SmoothieAq/cevo2/readme.md

# Cevo2
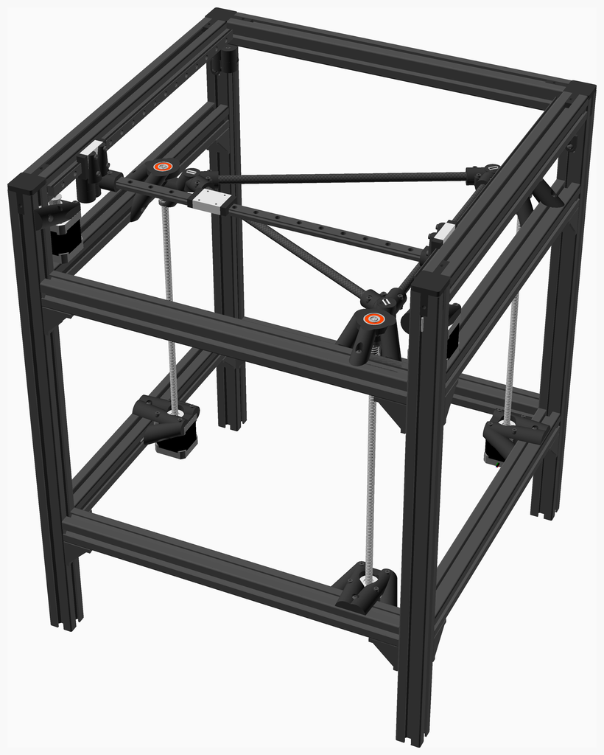
[picture p1: assemblies/frame22_assembled.png]
Main Assembly


<span></span>

---
## Table of Contents
1. [Parts list](#Parts_list)
1. [Loops Motor Holder Assembly](#loops_motor_holder_assembly)
1. [Idler Assembly](#idler_assembly)
1. [Bed1 Assembly](#bed1_assembly)
1. [Leads1 Assembly](#leads1_assembly)
1. [Leads2 Assembly](#leads2_assembly)
1. [Frame SideR Assembly](#frame_sideR_assembly)
1. [Frame SideL Assembly](#frame_sideL_assembly)
1. [Frame Assembly](#frame_assembly)
1. [Frame1 Assembly](#frame1_assembly)
1. [Frame2 Assembly](#frame2_assembly)
1. [Frame3 Assembly](#frame3_assembly)
1. [Frame10 Assembly](#frame10_assembly)
1. [Frame11 Assembly](#frame11_assembly)
1. [Frame20 Assembly](#frame20_assembly)
1. [Frame21 Assembly](#frame21_assembly)
1. [Frame22 Assembly](#frame22_assembly)

<span></span>
[Top](#TOP)

---

## Parts list
| <span style="writing-mode: vertical-rl; text-orientation: mixed;">Loops&nbsp;Motor&nbsp;Holder</span> | <span style="writing-mode: vertical-rl; text-orientation: mixed;">Idler</span> | <span style="writing-mode: vertical-rl; text-orientation: mixed;">Bed1</span> | <span style="writing-mode: vertical-rl; text-orientation: mixed;">Leads1</span> | <span style="writing-mode: vertical-rl; text-orientation: mixed;">Leads2</span> | <span style="writing-mode: vertical-rl; text-orientation: mixed;">Frame&nbsp;SideR</span> | <span style="writing-mode: vertical-rl; text-orientation: mixed;">Frame&nbsp;SideL</span> | <span style="writing-mode: vertical-rl; text-orientation: mixed;">Frame</span> | <span style="writing-mode: vertical-rl; text-orientation: mixed;">Frame1</span> | <span style="writing-mode: vertical-rl; text-orientation: mixed;">Frame2</span> | <span style="writing-mode: vertical-rl; text-orientation: mixed;">Frame3</span> | <span style="writing-mode: vertical-rl; text-orientation: mixed;">Frame10</span> | <span style="writing-mode: vertical-rl; text-orientation: mixed;">Frame11</span> | <span style="writing-mode: vertical-rl; text-orientation: mixed;">Frame20</span> | <span style="writing-mode: vertical-rl; text-orientation: mixed;">Frame21</span> | <span style="writing-mode: vertical-rl; text-orientation: mixed;">Frame22</span> | <span style="writing-mode: vertical-rl; text-orientation: mixed;">TOTALS</span> |  |
|---:|---:|---:|---:|---:|---:|---:|---:|---:|---:|---:|---:|---:|---:|---:|---:|---:|:---|
|  |  |  |  |  |  |  |  |  |  |  |  |  |  |  |  | | **Vitamins** |
| &nbsp;&nbsp;.&nbsp; | &nbsp;&nbsp;.&nbsp; | &nbsp;&nbsp;.&nbsp; | &nbsp;&nbsp;.&nbsp; | &nbsp;&nbsp;.&nbsp; | &nbsp;&nbsp;.&nbsp; | &nbsp;&nbsp;.&nbsp; | &nbsp;&nbsp;.&nbsp; | &nbsp;&nbsp;.&nbsp; | &nbsp;&nbsp;3&nbsp; | &nbsp;&nbsp;.&nbsp; | &nbsp;&nbsp;.&nbsp; | &nbsp;&nbsp;.&nbsp; | &nbsp;&nbsp;.&nbsp; | &nbsp;&nbsp;.&nbsp; | &nbsp;&nbsp;.&nbsp; |  &nbsp;&nbsp;3&nbsp; | &nbsp;&nbsp; Ball bearing 608-2RS 8mm x 22mm x 7mm |
| &nbsp;&nbsp;.&nbsp; | &nbsp;&nbsp;.&nbsp; | &nbsp;&nbsp;.&nbsp; | &nbsp;&nbsp;.&nbsp; | &nbsp;&nbsp;.&nbsp; | &nbsp;&nbsp;.&nbsp; | &nbsp;&nbsp;.&nbsp; | &nbsp;&nbsp;.&nbsp; | &nbsp;&nbsp;.&nbsp; | &nbsp;&nbsp;.&nbsp; | &nbsp;&nbsp;1&nbsp; | &nbsp;&nbsp;.&nbsp; | &nbsp;&nbsp;.&nbsp; | &nbsp;&nbsp;.&nbsp; | &nbsp;&nbsp;.&nbsp; | &nbsp;&nbsp;.&nbsp; |  &nbsp;&nbsp;1&nbsp; | &nbsp;&nbsp; Carbon fiber OD 10mm ID 8mm x 283mm |
| &nbsp;&nbsp;.&nbsp; | &nbsp;&nbsp;.&nbsp; | &nbsp;&nbsp;.&nbsp; | &nbsp;&nbsp;.&nbsp; | &nbsp;&nbsp;.&nbsp; | &nbsp;&nbsp;.&nbsp; | &nbsp;&nbsp;.&nbsp; | &nbsp;&nbsp;.&nbsp; | &nbsp;&nbsp;.&nbsp; | &nbsp;&nbsp;.&nbsp; | &nbsp;&nbsp;2&nbsp; | &nbsp;&nbsp;.&nbsp; | &nbsp;&nbsp;.&nbsp; | &nbsp;&nbsp;.&nbsp; | &nbsp;&nbsp;.&nbsp; | &nbsp;&nbsp;.&nbsp; |  &nbsp;&nbsp;2&nbsp; | &nbsp;&nbsp; Carbon fiber OD 10mm ID 8mm x 318.882mm |
| &nbsp;&nbsp;.&nbsp; | &nbsp;&nbsp;.&nbsp; | &nbsp;&nbsp;.&nbsp; | &nbsp;&nbsp;.&nbsp; | &nbsp;&nbsp;.&nbsp; | &nbsp;&nbsp;3&nbsp; | &nbsp;&nbsp;3&nbsp; | &nbsp;&nbsp;.&nbsp; | &nbsp;&nbsp;.&nbsp; | &nbsp;&nbsp;.&nbsp; | &nbsp;&nbsp;.&nbsp; | &nbsp;&nbsp;.&nbsp; | &nbsp;&nbsp;.&nbsp; | &nbsp;&nbsp;.&nbsp; | &nbsp;&nbsp;.&nbsp; | &nbsp;&nbsp;.&nbsp; |  &nbsp;&nbsp;6&nbsp; | &nbsp;&nbsp; Extrusion E3030 x 410mm |
| &nbsp;&nbsp;.&nbsp; | &nbsp;&nbsp;.&nbsp; | &nbsp;&nbsp;.&nbsp; | &nbsp;&nbsp;.&nbsp; | &nbsp;&nbsp;.&nbsp; | &nbsp;&nbsp;.&nbsp; | &nbsp;&nbsp;.&nbsp; | &nbsp;&nbsp;4&nbsp; | &nbsp;&nbsp;.&nbsp; | &nbsp;&nbsp;.&nbsp; | &nbsp;&nbsp;.&nbsp; | &nbsp;&nbsp;.&nbsp; | &nbsp;&nbsp;.&nbsp; | &nbsp;&nbsp;.&nbsp; | &nbsp;&nbsp;.&nbsp; | &nbsp;&nbsp;.&nbsp; |  &nbsp;&nbsp;4&nbsp; | &nbsp;&nbsp; Extrusion E3030 x 420mm |
| &nbsp;&nbsp;.&nbsp; | &nbsp;&nbsp;.&nbsp; | &nbsp;&nbsp;.&nbsp; | &nbsp;&nbsp;.&nbsp; | &nbsp;&nbsp;.&nbsp; | &nbsp;&nbsp;2&nbsp; | &nbsp;&nbsp;2&nbsp; | &nbsp;&nbsp;.&nbsp; | &nbsp;&nbsp;.&nbsp; | &nbsp;&nbsp;.&nbsp; | &nbsp;&nbsp;.&nbsp; | &nbsp;&nbsp;.&nbsp; | &nbsp;&nbsp;.&nbsp; | &nbsp;&nbsp;.&nbsp; | &nbsp;&nbsp;.&nbsp; | &nbsp;&nbsp;.&nbsp; |  &nbsp;&nbsp;4&nbsp; | &nbsp;&nbsp; Extrusion E3030 x 600mm |
| &nbsp;&nbsp;.&nbsp; | &nbsp;&nbsp;.&nbsp; | &nbsp;&nbsp;.&nbsp; | &nbsp;&nbsp;.&nbsp; | &nbsp;&nbsp;.&nbsp; | &nbsp;&nbsp;4&nbsp; | &nbsp;&nbsp;4&nbsp; | &nbsp;&nbsp;6&nbsp; | &nbsp;&nbsp;.&nbsp; | &nbsp;&nbsp;.&nbsp; | &nbsp;&nbsp;.&nbsp; | &nbsp;&nbsp;.&nbsp; | &nbsp;&nbsp;.&nbsp; | &nbsp;&nbsp;.&nbsp; | &nbsp;&nbsp;.&nbsp; | &nbsp;&nbsp;.&nbsp; |  &nbsp;&nbsp;14&nbsp; | &nbsp;&nbsp; Extrusion corner bracket 30 |
| &nbsp;&nbsp;.&nbsp; | &nbsp;&nbsp;.&nbsp; | &nbsp;&nbsp;.&nbsp; | &nbsp;&nbsp;.&nbsp; | &nbsp;&nbsp;.&nbsp; | &nbsp;&nbsp;2&nbsp; | &nbsp;&nbsp;2&nbsp; | &nbsp;&nbsp;.&nbsp; | &nbsp;&nbsp;.&nbsp; | &nbsp;&nbsp;.&nbsp; | &nbsp;&nbsp;.&nbsp; | &nbsp;&nbsp;.&nbsp; | &nbsp;&nbsp;.&nbsp; | &nbsp;&nbsp;.&nbsp; | &nbsp;&nbsp;.&nbsp; | &nbsp;&nbsp;.&nbsp; |  &nbsp;&nbsp;4&nbsp; | &nbsp;&nbsp; Extrusion inner corner bracket E30 M5 |
| &nbsp;&nbsp;.&nbsp; | &nbsp;&nbsp;.&nbsp; | &nbsp;&nbsp;3&nbsp; | &nbsp;&nbsp;.&nbsp; | &nbsp;&nbsp;.&nbsp; | &nbsp;&nbsp;.&nbsp; | &nbsp;&nbsp;.&nbsp; | &nbsp;&nbsp;.&nbsp; | &nbsp;&nbsp;.&nbsp; | &nbsp;&nbsp;.&nbsp; | &nbsp;&nbsp;.&nbsp; | &nbsp;&nbsp;.&nbsp; | &nbsp;&nbsp;.&nbsp; | &nbsp;&nbsp;.&nbsp; | &nbsp;&nbsp;.&nbsp; | &nbsp;&nbsp;.&nbsp; |  &nbsp;&nbsp;3&nbsp; | &nbsp;&nbsp; Leadscrew nut 8 x 2 |
| &nbsp;&nbsp;.&nbsp; | &nbsp;&nbsp;.&nbsp; | &nbsp;&nbsp;.&nbsp; | &nbsp;&nbsp;.&nbsp; | &nbsp;&nbsp;.&nbsp; | &nbsp;&nbsp;.&nbsp; | &nbsp;&nbsp;.&nbsp; | &nbsp;&nbsp;.&nbsp; | &nbsp;&nbsp;.&nbsp; | &nbsp;&nbsp;.&nbsp; | &nbsp;&nbsp;.&nbsp; | &nbsp;&nbsp;.&nbsp; | &nbsp;&nbsp;.&nbsp; | &nbsp;&nbsp;.&nbsp; | &nbsp;&nbsp;.&nbsp; | &nbsp;&nbsp;1&nbsp; |  &nbsp;&nbsp;1&nbsp; | &nbsp;&nbsp; Linear rail MGN12 x 396mm |
| &nbsp;&nbsp;.&nbsp; | &nbsp;&nbsp;.&nbsp; | &nbsp;&nbsp;.&nbsp; | &nbsp;&nbsp;.&nbsp; | &nbsp;&nbsp;.&nbsp; | &nbsp;&nbsp;.&nbsp; | &nbsp;&nbsp;.&nbsp; | &nbsp;&nbsp;.&nbsp; | &nbsp;&nbsp;.&nbsp; | &nbsp;&nbsp;.&nbsp; | &nbsp;&nbsp;.&nbsp; | &nbsp;&nbsp;.&nbsp; | &nbsp;&nbsp;.&nbsp; | &nbsp;&nbsp;2&nbsp; | &nbsp;&nbsp;.&nbsp; | &nbsp;&nbsp;.&nbsp; |  &nbsp;&nbsp;2&nbsp; | &nbsp;&nbsp; Linear rail MGN12 x 410mm |
| &nbsp;&nbsp;.&nbsp; | &nbsp;&nbsp;.&nbsp; | &nbsp;&nbsp;.&nbsp; | &nbsp;&nbsp;.&nbsp; | &nbsp;&nbsp;.&nbsp; | &nbsp;&nbsp;9&nbsp; | &nbsp;&nbsp;9&nbsp; | &nbsp;&nbsp;.&nbsp; | &nbsp;&nbsp;.&nbsp; | &nbsp;&nbsp;.&nbsp; | &nbsp;&nbsp;.&nbsp; | &nbsp;&nbsp;.&nbsp; | &nbsp;&nbsp;.&nbsp; | &nbsp;&nbsp;.&nbsp; | &nbsp;&nbsp;.&nbsp; | &nbsp;&nbsp;.&nbsp; |  &nbsp;&nbsp;18&nbsp; | &nbsp;&nbsp; Nut M3 sliding T |
| &nbsp;&nbsp;.&nbsp; | &nbsp;&nbsp;4&nbsp; | &nbsp;&nbsp;12&nbsp; | &nbsp;&nbsp;.&nbsp; | &nbsp;&nbsp;.&nbsp; | &nbsp;&nbsp;.&nbsp; | &nbsp;&nbsp;.&nbsp; | &nbsp;&nbsp;.&nbsp; | &nbsp;&nbsp;.&nbsp; | &nbsp;&nbsp;.&nbsp; | &nbsp;&nbsp;9&nbsp; | &nbsp;&nbsp;.&nbsp; | &nbsp;&nbsp;.&nbsp; | &nbsp;&nbsp;.&nbsp; | &nbsp;&nbsp;4&nbsp; | &nbsp;&nbsp;2&nbsp; |  &nbsp;&nbsp;31&nbsp; | &nbsp;&nbsp; Nut M3 x 2.4mm  |
| &nbsp;&nbsp;.&nbsp; | &nbsp;&nbsp;.&nbsp; | &nbsp;&nbsp;.&nbsp; | &nbsp;&nbsp;.&nbsp; | &nbsp;&nbsp;.&nbsp; | &nbsp;&nbsp;17&nbsp; | &nbsp;&nbsp;17&nbsp; | &nbsp;&nbsp;15&nbsp; | &nbsp;&nbsp;.&nbsp; | &nbsp;&nbsp;.&nbsp; | &nbsp;&nbsp;.&nbsp; | &nbsp;&nbsp;.&nbsp; | &nbsp;&nbsp;.&nbsp; | &nbsp;&nbsp;.&nbsp; | &nbsp;&nbsp;.&nbsp; | &nbsp;&nbsp;.&nbsp; |  &nbsp;&nbsp;49&nbsp; | &nbsp;&nbsp; Nut M4 sliding T |
| &nbsp;&nbsp;.&nbsp; | &nbsp;&nbsp;4&nbsp; | &nbsp;&nbsp;.&nbsp; | &nbsp;&nbsp;.&nbsp; | &nbsp;&nbsp;.&nbsp; | &nbsp;&nbsp;.&nbsp; | &nbsp;&nbsp;.&nbsp; | &nbsp;&nbsp;.&nbsp; | &nbsp;&nbsp;.&nbsp; | &nbsp;&nbsp;.&nbsp; | &nbsp;&nbsp;.&nbsp; | &nbsp;&nbsp;.&nbsp; | &nbsp;&nbsp;.&nbsp; | &nbsp;&nbsp;.&nbsp; | &nbsp;&nbsp;.&nbsp; | &nbsp;&nbsp;4&nbsp; |  &nbsp;&nbsp;8&nbsp; | &nbsp;&nbsp; Pulley GT2 idler smooth 10mm |
| &nbsp;&nbsp;2&nbsp; | &nbsp;&nbsp;.&nbsp; | &nbsp;&nbsp;.&nbsp; | &nbsp;&nbsp;.&nbsp; | &nbsp;&nbsp;.&nbsp; | &nbsp;&nbsp;.&nbsp; | &nbsp;&nbsp;.&nbsp; | &nbsp;&nbsp;.&nbsp; | &nbsp;&nbsp;.&nbsp; | &nbsp;&nbsp;.&nbsp; | &nbsp;&nbsp;.&nbsp; | &nbsp;&nbsp;.&nbsp; | &nbsp;&nbsp;.&nbsp; | &nbsp;&nbsp;.&nbsp; | &nbsp;&nbsp;.&nbsp; | &nbsp;&nbsp;.&nbsp; |  &nbsp;&nbsp;2&nbsp; | &nbsp;&nbsp; Pulley GT2OB 20 teeth |
| &nbsp;&nbsp;.&nbsp; | &nbsp;&nbsp;.&nbsp; | &nbsp;&nbsp;.&nbsp; | &nbsp;&nbsp;.&nbsp; | &nbsp;&nbsp;.&nbsp; | &nbsp;&nbsp;.&nbsp; | &nbsp;&nbsp;.&nbsp; | &nbsp;&nbsp;.&nbsp; | &nbsp;&nbsp;.&nbsp; | &nbsp;&nbsp;.&nbsp; | &nbsp;&nbsp;.&nbsp; | &nbsp;&nbsp;.&nbsp; | &nbsp;&nbsp;.&nbsp; | &nbsp;&nbsp;18&nbsp; | &nbsp;&nbsp;.&nbsp; | &nbsp;&nbsp;.&nbsp; |  &nbsp;&nbsp;18&nbsp; | &nbsp;&nbsp; Screw M3 cap x  5mm |
| &nbsp;&nbsp;.&nbsp; | &nbsp;&nbsp;.&nbsp; | &nbsp;&nbsp;.&nbsp; | &nbsp;&nbsp;.&nbsp; | &nbsp;&nbsp;.&nbsp; | &nbsp;&nbsp;.&nbsp; | &nbsp;&nbsp;.&nbsp; | &nbsp;&nbsp;.&nbsp; | &nbsp;&nbsp;.&nbsp; | &nbsp;&nbsp;.&nbsp; | &nbsp;&nbsp;.&nbsp; | &nbsp;&nbsp;.&nbsp; | &nbsp;&nbsp;.&nbsp; | &nbsp;&nbsp;.&nbsp; | &nbsp;&nbsp;4&nbsp; | &nbsp;&nbsp;.&nbsp; |  &nbsp;&nbsp;4&nbsp; | &nbsp;&nbsp; Screw M3 cap x 10mm |
| &nbsp;&nbsp;4&nbsp; | &nbsp;&nbsp;.&nbsp; | &nbsp;&nbsp;.&nbsp; | &nbsp;&nbsp;.&nbsp; | &nbsp;&nbsp;.&nbsp; | &nbsp;&nbsp;.&nbsp; | &nbsp;&nbsp;.&nbsp; | &nbsp;&nbsp;.&nbsp; | &nbsp;&nbsp;.&nbsp; | &nbsp;&nbsp;.&nbsp; | &nbsp;&nbsp;.&nbsp; | &nbsp;&nbsp;.&nbsp; | &nbsp;&nbsp;.&nbsp; | &nbsp;&nbsp;.&nbsp; | &nbsp;&nbsp;.&nbsp; | &nbsp;&nbsp;.&nbsp; |  &nbsp;&nbsp;4&nbsp; | &nbsp;&nbsp; Screw M3 cap x 11mm |
| &nbsp;&nbsp;.&nbsp; | &nbsp;&nbsp;.&nbsp; | &nbsp;&nbsp;12&nbsp; | &nbsp;&nbsp;12&nbsp; | &nbsp;&nbsp;.&nbsp; | &nbsp;&nbsp;.&nbsp; | &nbsp;&nbsp;.&nbsp; | &nbsp;&nbsp;.&nbsp; | &nbsp;&nbsp;.&nbsp; | &nbsp;&nbsp;.&nbsp; | &nbsp;&nbsp;9&nbsp; | &nbsp;&nbsp;.&nbsp; | &nbsp;&nbsp;.&nbsp; | &nbsp;&nbsp;.&nbsp; | &nbsp;&nbsp;4&nbsp; | &nbsp;&nbsp;.&nbsp; |  &nbsp;&nbsp;37&nbsp; | &nbsp;&nbsp; Screw M3 cap x 12mm |
| &nbsp;&nbsp;4&nbsp; | &nbsp;&nbsp;.&nbsp; | &nbsp;&nbsp;.&nbsp; | &nbsp;&nbsp;.&nbsp; | &nbsp;&nbsp;.&nbsp; | &nbsp;&nbsp;.&nbsp; | &nbsp;&nbsp;.&nbsp; | &nbsp;&nbsp;.&nbsp; | &nbsp;&nbsp;.&nbsp; | &nbsp;&nbsp;.&nbsp; | &nbsp;&nbsp;.&nbsp; | &nbsp;&nbsp;.&nbsp; | &nbsp;&nbsp;.&nbsp; | &nbsp;&nbsp;.&nbsp; | &nbsp;&nbsp;.&nbsp; | &nbsp;&nbsp;.&nbsp; |  &nbsp;&nbsp;4&nbsp; | &nbsp;&nbsp; Screw M3 cap x 14mm |
| &nbsp;&nbsp;.&nbsp; | &nbsp;&nbsp;.&nbsp; | &nbsp;&nbsp;.&nbsp; | &nbsp;&nbsp;.&nbsp; | &nbsp;&nbsp;.&nbsp; | &nbsp;&nbsp;.&nbsp; | &nbsp;&nbsp;.&nbsp; | &nbsp;&nbsp;.&nbsp; | &nbsp;&nbsp;.&nbsp; | &nbsp;&nbsp;.&nbsp; | &nbsp;&nbsp;.&nbsp; | &nbsp;&nbsp;.&nbsp; | &nbsp;&nbsp;.&nbsp; | &nbsp;&nbsp;.&nbsp; | &nbsp;&nbsp;.&nbsp; | &nbsp;&nbsp;2&nbsp; |  &nbsp;&nbsp;2&nbsp; | &nbsp;&nbsp; Screw M3 cap x 16mm |
| &nbsp;&nbsp;.&nbsp; | &nbsp;&nbsp;4&nbsp; | &nbsp;&nbsp;.&nbsp; | &nbsp;&nbsp;.&nbsp; | &nbsp;&nbsp;.&nbsp; | &nbsp;&nbsp;.&nbsp; | &nbsp;&nbsp;.&nbsp; | &nbsp;&nbsp;.&nbsp; | &nbsp;&nbsp;.&nbsp; | &nbsp;&nbsp;.&nbsp; | &nbsp;&nbsp;.&nbsp; | &nbsp;&nbsp;.&nbsp; | &nbsp;&nbsp;.&nbsp; | &nbsp;&nbsp;.&nbsp; | &nbsp;&nbsp;.&nbsp; | &nbsp;&nbsp;.&nbsp; |  &nbsp;&nbsp;4&nbsp; | &nbsp;&nbsp; Screw M3 cap x 25mm |
| &nbsp;&nbsp;.&nbsp; | &nbsp;&nbsp;.&nbsp; | &nbsp;&nbsp;.&nbsp; | &nbsp;&nbsp;.&nbsp; | &nbsp;&nbsp;.&nbsp; | &nbsp;&nbsp;.&nbsp; | &nbsp;&nbsp;.&nbsp; | &nbsp;&nbsp;.&nbsp; | &nbsp;&nbsp;.&nbsp; | &nbsp;&nbsp;.&nbsp; | &nbsp;&nbsp;.&nbsp; | &nbsp;&nbsp;.&nbsp; | &nbsp;&nbsp;.&nbsp; | &nbsp;&nbsp;.&nbsp; | &nbsp;&nbsp;.&nbsp; | &nbsp;&nbsp;4&nbsp; |  &nbsp;&nbsp;4&nbsp; | &nbsp;&nbsp; Screw M3 cap x 30mm |
| &nbsp;&nbsp;4&nbsp; | &nbsp;&nbsp;.&nbsp; | &nbsp;&nbsp;.&nbsp; | &nbsp;&nbsp;.&nbsp; | &nbsp;&nbsp;.&nbsp; | &nbsp;&nbsp;.&nbsp; | &nbsp;&nbsp;.&nbsp; | &nbsp;&nbsp;.&nbsp; | &nbsp;&nbsp;.&nbsp; | &nbsp;&nbsp;.&nbsp; | &nbsp;&nbsp;.&nbsp; | &nbsp;&nbsp;.&nbsp; | &nbsp;&nbsp;.&nbsp; | &nbsp;&nbsp;.&nbsp; | &nbsp;&nbsp;.&nbsp; | &nbsp;&nbsp;.&nbsp; |  &nbsp;&nbsp;4&nbsp; | &nbsp;&nbsp; Screw M3 grub x  6mm |
| &nbsp;&nbsp;.&nbsp; | &nbsp;&nbsp;.&nbsp; | &nbsp;&nbsp;.&nbsp; | &nbsp;&nbsp;.&nbsp; | &nbsp;&nbsp;.&nbsp; | &nbsp;&nbsp;8&nbsp; | &nbsp;&nbsp;8&nbsp; | &nbsp;&nbsp;12&nbsp; | &nbsp;&nbsp;.&nbsp; | &nbsp;&nbsp;.&nbsp; | &nbsp;&nbsp;.&nbsp; | &nbsp;&nbsp;8&nbsp; | &nbsp;&nbsp;.&nbsp; | &nbsp;&nbsp;.&nbsp; | &nbsp;&nbsp;.&nbsp; | &nbsp;&nbsp;.&nbsp; |  &nbsp;&nbsp;36&nbsp; | &nbsp;&nbsp; Screw M4 dome x  8mm |
| &nbsp;&nbsp;.&nbsp; | &nbsp;&nbsp;.&nbsp; | &nbsp;&nbsp;.&nbsp; | &nbsp;&nbsp;.&nbsp; | &nbsp;&nbsp;.&nbsp; | &nbsp;&nbsp;.&nbsp; | &nbsp;&nbsp;.&nbsp; | &nbsp;&nbsp;.&nbsp; | &nbsp;&nbsp;9&nbsp; | &nbsp;&nbsp;9&nbsp; | &nbsp;&nbsp;.&nbsp; | &nbsp;&nbsp;.&nbsp; | &nbsp;&nbsp;4&nbsp; | &nbsp;&nbsp;.&nbsp; | &nbsp;&nbsp;.&nbsp; | &nbsp;&nbsp;.&nbsp; |  &nbsp;&nbsp;22&nbsp; | &nbsp;&nbsp; Screw M4 dome x 12mm |
| &nbsp;&nbsp;.&nbsp; | &nbsp;&nbsp;.&nbsp; | &nbsp;&nbsp;6&nbsp; | &nbsp;&nbsp;.&nbsp; | &nbsp;&nbsp;.&nbsp; | &nbsp;&nbsp;.&nbsp; | &nbsp;&nbsp;.&nbsp; | &nbsp;&nbsp;.&nbsp; | &nbsp;&nbsp;.&nbsp; | &nbsp;&nbsp;.&nbsp; | &nbsp;&nbsp;.&nbsp; | &nbsp;&nbsp;.&nbsp; | &nbsp;&nbsp;.&nbsp; | &nbsp;&nbsp;.&nbsp; | &nbsp;&nbsp;.&nbsp; | &nbsp;&nbsp;.&nbsp; |  &nbsp;&nbsp;6&nbsp; | &nbsp;&nbsp; Smooth rod 2mm x 10mm |
| &nbsp;&nbsp;.&nbsp; | &nbsp;&nbsp;.&nbsp; | &nbsp;&nbsp;3&nbsp; | &nbsp;&nbsp;.&nbsp; | &nbsp;&nbsp;.&nbsp; | &nbsp;&nbsp;.&nbsp; | &nbsp;&nbsp;.&nbsp; | &nbsp;&nbsp;.&nbsp; | &nbsp;&nbsp;.&nbsp; | &nbsp;&nbsp;.&nbsp; | &nbsp;&nbsp;.&nbsp; | &nbsp;&nbsp;.&nbsp; | &nbsp;&nbsp;.&nbsp; | &nbsp;&nbsp;.&nbsp; | &nbsp;&nbsp;.&nbsp; | &nbsp;&nbsp;.&nbsp; |  &nbsp;&nbsp;3&nbsp; | &nbsp;&nbsp; Spring 11.85mm OD, 0.8mm gauge x 37.8mm long, closed end |
| &nbsp;&nbsp;2&nbsp; | &nbsp;&nbsp;.&nbsp; | &nbsp;&nbsp;.&nbsp; | &nbsp;&nbsp;.&nbsp; | &nbsp;&nbsp;.&nbsp; | &nbsp;&nbsp;.&nbsp; | &nbsp;&nbsp;.&nbsp; | &nbsp;&nbsp;.&nbsp; | &nbsp;&nbsp;.&nbsp; | &nbsp;&nbsp;.&nbsp; | &nbsp;&nbsp;.&nbsp; | &nbsp;&nbsp;.&nbsp; | &nbsp;&nbsp;.&nbsp; | &nbsp;&nbsp;.&nbsp; | &nbsp;&nbsp;.&nbsp; | &nbsp;&nbsp;.&nbsp; |  &nbsp;&nbsp;2&nbsp; | &nbsp;&nbsp; Stepper motor NEMA17 x 47mm |
| &nbsp;&nbsp;.&nbsp; | &nbsp;&nbsp;.&nbsp; | &nbsp;&nbsp;.&nbsp; | &nbsp;&nbsp;3&nbsp; | &nbsp;&nbsp;.&nbsp; | &nbsp;&nbsp;.&nbsp; | &nbsp;&nbsp;.&nbsp; | &nbsp;&nbsp;.&nbsp; | &nbsp;&nbsp;.&nbsp; | &nbsp;&nbsp;.&nbsp; | &nbsp;&nbsp;.&nbsp; | &nbsp;&nbsp;.&nbsp; | &nbsp;&nbsp;.&nbsp; | &nbsp;&nbsp;.&nbsp; | &nbsp;&nbsp;.&nbsp; | &nbsp;&nbsp;.&nbsp; |  &nbsp;&nbsp;3&nbsp; | &nbsp;&nbsp; Stepper motor NEMA17 x 47mm |
| &nbsp;&nbsp;.&nbsp; | &nbsp;&nbsp;.&nbsp; | &nbsp;&nbsp;6&nbsp; | &nbsp;&nbsp;.&nbsp; | &nbsp;&nbsp;.&nbsp; | &nbsp;&nbsp;.&nbsp; | &nbsp;&nbsp;.&nbsp; | &nbsp;&nbsp;.&nbsp; | &nbsp;&nbsp;.&nbsp; | &nbsp;&nbsp;.&nbsp; | &nbsp;&nbsp;.&nbsp; | &nbsp;&nbsp;.&nbsp; | &nbsp;&nbsp;.&nbsp; | &nbsp;&nbsp;.&nbsp; | &nbsp;&nbsp;.&nbsp; | &nbsp;&nbsp;.&nbsp; |  &nbsp;&nbsp;6&nbsp; | &nbsp;&nbsp; Washer  M2 x 5mm x 0.3mm |
| &nbsp;&nbsp;.&nbsp; | &nbsp;&nbsp;8&nbsp; | &nbsp;&nbsp;.&nbsp; | &nbsp;&nbsp;.&nbsp; | &nbsp;&nbsp;.&nbsp; | &nbsp;&nbsp;.&nbsp; | &nbsp;&nbsp;.&nbsp; | &nbsp;&nbsp;.&nbsp; | &nbsp;&nbsp;.&nbsp; | &nbsp;&nbsp;.&nbsp; | &nbsp;&nbsp;.&nbsp; | &nbsp;&nbsp;.&nbsp; | &nbsp;&nbsp;.&nbsp; | &nbsp;&nbsp;.&nbsp; | &nbsp;&nbsp;.&nbsp; | &nbsp;&nbsp;8&nbsp; |  &nbsp;&nbsp;16&nbsp; | &nbsp;&nbsp; Washer  M3 x 6mm x 1mm |
| &nbsp;&nbsp;16&nbsp; | &nbsp;&nbsp;20&nbsp; | &nbsp;&nbsp;42&nbsp; | &nbsp;&nbsp;15&nbsp; | &nbsp;&nbsp;.&nbsp; | &nbsp;&nbsp;45&nbsp; | &nbsp;&nbsp;45&nbsp; | &nbsp;&nbsp;37&nbsp; | &nbsp;&nbsp;9&nbsp; | &nbsp;&nbsp;12&nbsp; | &nbsp;&nbsp;21&nbsp; | &nbsp;&nbsp;8&nbsp; | &nbsp;&nbsp;4&nbsp; | &nbsp;&nbsp;20&nbsp; | &nbsp;&nbsp;12&nbsp; | &nbsp;&nbsp;21&nbsp; | &nbsp;&nbsp;327&nbsp; | &nbsp;&nbsp;Total vitamins count |
|  |  |  |  |  |  |  |  |  |  |  |  |  |  |  |  | | **3D printed parts** |
| &nbsp;&nbsp;.&nbsp; | &nbsp;&nbsp;.&nbsp; | &nbsp;&nbsp;.&nbsp; | &nbsp;&nbsp;.&nbsp; | &nbsp;&nbsp;.&nbsp; | &nbsp;&nbsp;.&nbsp; | &nbsp;&nbsp;.&nbsp; | &nbsp;&nbsp;.&nbsp; | &nbsp;&nbsp;.&nbsp; | &nbsp;&nbsp;.&nbsp; | &nbsp;&nbsp;1&nbsp; | &nbsp;&nbsp;.&nbsp; | &nbsp;&nbsp;.&nbsp; | &nbsp;&nbsp;.&nbsp; | &nbsp;&nbsp;.&nbsp; | &nbsp;&nbsp;.&nbsp; |  &nbsp;&nbsp;1&nbsp; | &nbsp;&nbsp;bed_holderB1.stl |
| &nbsp;&nbsp;.&nbsp; | &nbsp;&nbsp;.&nbsp; | &nbsp;&nbsp;1&nbsp; | &nbsp;&nbsp;.&nbsp; | &nbsp;&nbsp;.&nbsp; | &nbsp;&nbsp;.&nbsp; | &nbsp;&nbsp;.&nbsp; | &nbsp;&nbsp;.&nbsp; | &nbsp;&nbsp;.&nbsp; | &nbsp;&nbsp;.&nbsp; | &nbsp;&nbsp;.&nbsp; | &nbsp;&nbsp;.&nbsp; | &nbsp;&nbsp;.&nbsp; | &nbsp;&nbsp;.&nbsp; | &nbsp;&nbsp;.&nbsp; | &nbsp;&nbsp;.&nbsp; |  &nbsp;&nbsp;1&nbsp; | &nbsp;&nbsp;bed_holderB2.stl |
| &nbsp;&nbsp;.&nbsp; | &nbsp;&nbsp;.&nbsp; | &nbsp;&nbsp;.&nbsp; | &nbsp;&nbsp;.&nbsp; | &nbsp;&nbsp;.&nbsp; | &nbsp;&nbsp;.&nbsp; | &nbsp;&nbsp;.&nbsp; | &nbsp;&nbsp;.&nbsp; | &nbsp;&nbsp;.&nbsp; | &nbsp;&nbsp;.&nbsp; | &nbsp;&nbsp;1&nbsp; | &nbsp;&nbsp;.&nbsp; | &nbsp;&nbsp;.&nbsp; | &nbsp;&nbsp;.&nbsp; | &nbsp;&nbsp;.&nbsp; | &nbsp;&nbsp;.&nbsp; |  &nbsp;&nbsp;1&nbsp; | &nbsp;&nbsp;bed_holderF1.stl |
| &nbsp;&nbsp;.&nbsp; | &nbsp;&nbsp;.&nbsp; | &nbsp;&nbsp;1&nbsp; | &nbsp;&nbsp;.&nbsp; | &nbsp;&nbsp;.&nbsp; | &nbsp;&nbsp;.&nbsp; | &nbsp;&nbsp;.&nbsp; | &nbsp;&nbsp;.&nbsp; | &nbsp;&nbsp;.&nbsp; | &nbsp;&nbsp;.&nbsp; | &nbsp;&nbsp;.&nbsp; | &nbsp;&nbsp;.&nbsp; | &nbsp;&nbsp;.&nbsp; | &nbsp;&nbsp;.&nbsp; | &nbsp;&nbsp;.&nbsp; | &nbsp;&nbsp;.&nbsp; |  &nbsp;&nbsp;1&nbsp; | &nbsp;&nbsp;bed_holderF2.stl |
| &nbsp;&nbsp;.&nbsp; | &nbsp;&nbsp;.&nbsp; | &nbsp;&nbsp;.&nbsp; | &nbsp;&nbsp;.&nbsp; | &nbsp;&nbsp;.&nbsp; | &nbsp;&nbsp;.&nbsp; | &nbsp;&nbsp;.&nbsp; | &nbsp;&nbsp;.&nbsp; | &nbsp;&nbsp;.&nbsp; | &nbsp;&nbsp;.&nbsp; | &nbsp;&nbsp;1&nbsp; | &nbsp;&nbsp;.&nbsp; | &nbsp;&nbsp;.&nbsp; | &nbsp;&nbsp;.&nbsp; | &nbsp;&nbsp;.&nbsp; | &nbsp;&nbsp;.&nbsp; |  &nbsp;&nbsp;1&nbsp; | &nbsp;&nbsp;bed_holderL1.stl |
| &nbsp;&nbsp;.&nbsp; | &nbsp;&nbsp;.&nbsp; | &nbsp;&nbsp;1&nbsp; | &nbsp;&nbsp;.&nbsp; | &nbsp;&nbsp;.&nbsp; | &nbsp;&nbsp;.&nbsp; | &nbsp;&nbsp;.&nbsp; | &nbsp;&nbsp;.&nbsp; | &nbsp;&nbsp;.&nbsp; | &nbsp;&nbsp;.&nbsp; | &nbsp;&nbsp;.&nbsp; | &nbsp;&nbsp;.&nbsp; | &nbsp;&nbsp;.&nbsp; | &nbsp;&nbsp;.&nbsp; | &nbsp;&nbsp;.&nbsp; | &nbsp;&nbsp;.&nbsp; |  &nbsp;&nbsp;1&nbsp; | &nbsp;&nbsp;bed_holderL2.stl |
| &nbsp;&nbsp;.&nbsp; | &nbsp;&nbsp;1&nbsp; | &nbsp;&nbsp;.&nbsp; | &nbsp;&nbsp;.&nbsp; | &nbsp;&nbsp;.&nbsp; | &nbsp;&nbsp;.&nbsp; | &nbsp;&nbsp;.&nbsp; | &nbsp;&nbsp;.&nbsp; | &nbsp;&nbsp;.&nbsp; | &nbsp;&nbsp;.&nbsp; | &nbsp;&nbsp;.&nbsp; | &nbsp;&nbsp;.&nbsp; | &nbsp;&nbsp;.&nbsp; | &nbsp;&nbsp;.&nbsp; | &nbsp;&nbsp;.&nbsp; | &nbsp;&nbsp;.&nbsp; |  &nbsp;&nbsp;1&nbsp; | &nbsp;&nbsp;idler_holderL1.stl |
| &nbsp;&nbsp;.&nbsp; | &nbsp;&nbsp;1&nbsp; | &nbsp;&nbsp;.&nbsp; | &nbsp;&nbsp;.&nbsp; | &nbsp;&nbsp;.&nbsp; | &nbsp;&nbsp;.&nbsp; | &nbsp;&nbsp;.&nbsp; | &nbsp;&nbsp;.&nbsp; | &nbsp;&nbsp;.&nbsp; | &nbsp;&nbsp;.&nbsp; | &nbsp;&nbsp;.&nbsp; | &nbsp;&nbsp;.&nbsp; | &nbsp;&nbsp;.&nbsp; | &nbsp;&nbsp;.&nbsp; | &nbsp;&nbsp;.&nbsp; | &nbsp;&nbsp;.&nbsp; |  &nbsp;&nbsp;1&nbsp; | &nbsp;&nbsp;idler_holderL2.stl |
| &nbsp;&nbsp;.&nbsp; | &nbsp;&nbsp;1&nbsp; | &nbsp;&nbsp;.&nbsp; | &nbsp;&nbsp;.&nbsp; | &nbsp;&nbsp;.&nbsp; | &nbsp;&nbsp;.&nbsp; | &nbsp;&nbsp;.&nbsp; | &nbsp;&nbsp;.&nbsp; | &nbsp;&nbsp;.&nbsp; | &nbsp;&nbsp;.&nbsp; | &nbsp;&nbsp;.&nbsp; | &nbsp;&nbsp;.&nbsp; | &nbsp;&nbsp;.&nbsp; | &nbsp;&nbsp;.&nbsp; | &nbsp;&nbsp;.&nbsp; | &nbsp;&nbsp;.&nbsp; |  &nbsp;&nbsp;1&nbsp; | &nbsp;&nbsp;idler_holderR1.stl |
| &nbsp;&nbsp;.&nbsp; | &nbsp;&nbsp;1&nbsp; | &nbsp;&nbsp;.&nbsp; | &nbsp;&nbsp;.&nbsp; | &nbsp;&nbsp;.&nbsp; | &nbsp;&nbsp;.&nbsp; | &nbsp;&nbsp;.&nbsp; | &nbsp;&nbsp;.&nbsp; | &nbsp;&nbsp;.&nbsp; | &nbsp;&nbsp;.&nbsp; | &nbsp;&nbsp;.&nbsp; | &nbsp;&nbsp;.&nbsp; | &nbsp;&nbsp;.&nbsp; | &nbsp;&nbsp;.&nbsp; | &nbsp;&nbsp;.&nbsp; | &nbsp;&nbsp;.&nbsp; |  &nbsp;&nbsp;1&nbsp; | &nbsp;&nbsp;idler_holderR2.stl |
| &nbsp;&nbsp;.&nbsp; | &nbsp;&nbsp;.&nbsp; | &nbsp;&nbsp;.&nbsp; | &nbsp;&nbsp;.&nbsp; | &nbsp;&nbsp;.&nbsp; | &nbsp;&nbsp;.&nbsp; | &nbsp;&nbsp;.&nbsp; | &nbsp;&nbsp;.&nbsp; | &nbsp;&nbsp;.&nbsp; | &nbsp;&nbsp;3&nbsp; | &nbsp;&nbsp;.&nbsp; | &nbsp;&nbsp;.&nbsp; | &nbsp;&nbsp;.&nbsp; | &nbsp;&nbsp;.&nbsp; | &nbsp;&nbsp;.&nbsp; | &nbsp;&nbsp;.&nbsp; |  &nbsp;&nbsp;3&nbsp; | &nbsp;&nbsp;leads_holder.stl |
| &nbsp;&nbsp;.&nbsp; | &nbsp;&nbsp;.&nbsp; | &nbsp;&nbsp;.&nbsp; | &nbsp;&nbsp;3&nbsp; | &nbsp;&nbsp;.&nbsp; | &nbsp;&nbsp;.&nbsp; | &nbsp;&nbsp;.&nbsp; | &nbsp;&nbsp;.&nbsp; | &nbsp;&nbsp;.&nbsp; | &nbsp;&nbsp;.&nbsp; | &nbsp;&nbsp;.&nbsp; | &nbsp;&nbsp;.&nbsp; | &nbsp;&nbsp;.&nbsp; | &nbsp;&nbsp;.&nbsp; | &nbsp;&nbsp;.&nbsp; | &nbsp;&nbsp;.&nbsp; |  &nbsp;&nbsp;3&nbsp; | &nbsp;&nbsp;leads_motor_holder.stl |
| &nbsp;&nbsp;1&nbsp; | &nbsp;&nbsp;.&nbsp; | &nbsp;&nbsp;.&nbsp; | &nbsp;&nbsp;.&nbsp; | &nbsp;&nbsp;.&nbsp; | &nbsp;&nbsp;.&nbsp; | &nbsp;&nbsp;.&nbsp; | &nbsp;&nbsp;.&nbsp; | &nbsp;&nbsp;.&nbsp; | &nbsp;&nbsp;.&nbsp; | &nbsp;&nbsp;.&nbsp; | &nbsp;&nbsp;.&nbsp; | &nbsp;&nbsp;.&nbsp; | &nbsp;&nbsp;.&nbsp; | &nbsp;&nbsp;.&nbsp; | &nbsp;&nbsp;.&nbsp; |  &nbsp;&nbsp;1&nbsp; | &nbsp;&nbsp;loops_motor_holderL.stl |
| &nbsp;&nbsp;1&nbsp; | &nbsp;&nbsp;.&nbsp; | &nbsp;&nbsp;.&nbsp; | &nbsp;&nbsp;.&nbsp; | &nbsp;&nbsp;.&nbsp; | &nbsp;&nbsp;.&nbsp; | &nbsp;&nbsp;.&nbsp; | &nbsp;&nbsp;.&nbsp; | &nbsp;&nbsp;.&nbsp; | &nbsp;&nbsp;.&nbsp; | &nbsp;&nbsp;.&nbsp; | &nbsp;&nbsp;.&nbsp; | &nbsp;&nbsp;.&nbsp; | &nbsp;&nbsp;.&nbsp; | &nbsp;&nbsp;.&nbsp; | &nbsp;&nbsp;.&nbsp; |  &nbsp;&nbsp;1&nbsp; | &nbsp;&nbsp;loops_motor_holderR.stl |
| &nbsp;&nbsp;.&nbsp; | &nbsp;&nbsp;.&nbsp; | &nbsp;&nbsp;.&nbsp; | &nbsp;&nbsp;.&nbsp; | &nbsp;&nbsp;.&nbsp; | &nbsp;&nbsp;.&nbsp; | &nbsp;&nbsp;.&nbsp; | &nbsp;&nbsp;.&nbsp; | &nbsp;&nbsp;.&nbsp; | &nbsp;&nbsp;.&nbsp; | &nbsp;&nbsp;.&nbsp; | &nbsp;&nbsp;.&nbsp; | &nbsp;&nbsp;.&nbsp; | &nbsp;&nbsp;.&nbsp; | &nbsp;&nbsp;1&nbsp; | &nbsp;&nbsp;.&nbsp; |  &nbsp;&nbsp;1&nbsp; | &nbsp;&nbsp;x_holderL1.stl |
| &nbsp;&nbsp;.&nbsp; | &nbsp;&nbsp;.&nbsp; | &nbsp;&nbsp;.&nbsp; | &nbsp;&nbsp;.&nbsp; | &nbsp;&nbsp;.&nbsp; | &nbsp;&nbsp;.&nbsp; | &nbsp;&nbsp;.&nbsp; | &nbsp;&nbsp;.&nbsp; | &nbsp;&nbsp;.&nbsp; | &nbsp;&nbsp;.&nbsp; | &nbsp;&nbsp;.&nbsp; | &nbsp;&nbsp;.&nbsp; | &nbsp;&nbsp;.&nbsp; | &nbsp;&nbsp;.&nbsp; | &nbsp;&nbsp;.&nbsp; | &nbsp;&nbsp;1&nbsp; |  &nbsp;&nbsp;1&nbsp; | &nbsp;&nbsp;x_holderL2.stl |
| &nbsp;&nbsp;.&nbsp; | &nbsp;&nbsp;.&nbsp; | &nbsp;&nbsp;.&nbsp; | &nbsp;&nbsp;.&nbsp; | &nbsp;&nbsp;.&nbsp; | &nbsp;&nbsp;.&nbsp; | &nbsp;&nbsp;.&nbsp; | &nbsp;&nbsp;.&nbsp; | &nbsp;&nbsp;.&nbsp; | &nbsp;&nbsp;.&nbsp; | &nbsp;&nbsp;.&nbsp; | &nbsp;&nbsp;.&nbsp; | &nbsp;&nbsp;.&nbsp; | &nbsp;&nbsp;.&nbsp; | &nbsp;&nbsp;1&nbsp; | &nbsp;&nbsp;.&nbsp; |  &nbsp;&nbsp;1&nbsp; | &nbsp;&nbsp;x_holderR1.stl |
| &nbsp;&nbsp;.&nbsp; | &nbsp;&nbsp;.&nbsp; | &nbsp;&nbsp;.&nbsp; | &nbsp;&nbsp;.&nbsp; | &nbsp;&nbsp;.&nbsp; | &nbsp;&nbsp;.&nbsp; | &nbsp;&nbsp;.&nbsp; | &nbsp;&nbsp;.&nbsp; | &nbsp;&nbsp;.&nbsp; | &nbsp;&nbsp;.&nbsp; | &nbsp;&nbsp;.&nbsp; | &nbsp;&nbsp;.&nbsp; | &nbsp;&nbsp;.&nbsp; | &nbsp;&nbsp;.&nbsp; | &nbsp;&nbsp;.&nbsp; | &nbsp;&nbsp;1&nbsp; |  &nbsp;&nbsp;1&nbsp; | &nbsp;&nbsp;x_holderR2.stl |
| &nbsp;&nbsp;2&nbsp; | &nbsp;&nbsp;4&nbsp; | &nbsp;&nbsp;3&nbsp; | &nbsp;&nbsp;3&nbsp; | &nbsp;&nbsp;.&nbsp; | &nbsp;&nbsp;.&nbsp; | &nbsp;&nbsp;.&nbsp; | &nbsp;&nbsp;.&nbsp; | &nbsp;&nbsp;.&nbsp; | &nbsp;&nbsp;3&nbsp; | &nbsp;&nbsp;3&nbsp; | &nbsp;&nbsp;.&nbsp; | &nbsp;&nbsp;.&nbsp; | &nbsp;&nbsp;.&nbsp; | &nbsp;&nbsp;2&nbsp; | &nbsp;&nbsp;2&nbsp; | &nbsp;&nbsp;22&nbsp; | &nbsp;&nbsp;Total 3D printed parts count |

<span></span>
[Top](#TOP)

---

## Loops Motor Holder Assembly
### Vitamins
|Qty|Description|
|---:|:---|
|2| Pulley GT2OB 20 teeth|
|4| Screw M3 cap x 11mm|
|4| Screw M3 cap x 14mm|
|4| Screw M3 grub x  6mm|
|2| Stepper motor NEMA17 x 47mm|

### 3D Printed parts

| 1 x loops_motor_holderL.stl | 1 x loops_motor_holderR.stl |
|---|---|
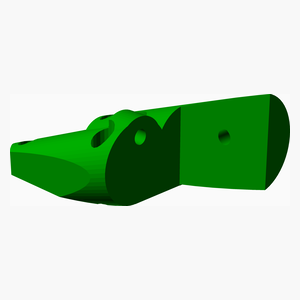
[picture p2: stls/loops_motor_holderL.png]
loops_motor_holderL.stl
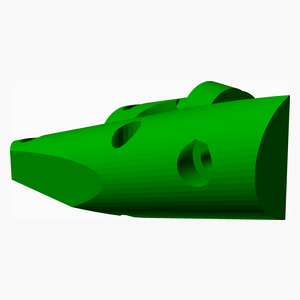
[picture p3: stls/loops_motor_holderR.png]
loops_motor_holderR.stl
|  |  

### Assembly instructions
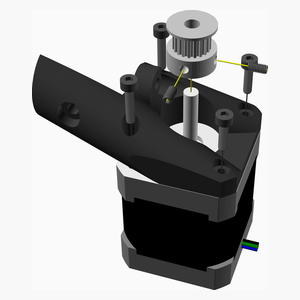
[picture p4: assemblies/loops_motor_holder_assembly_tn.png]
loops_motor_holder_assembly


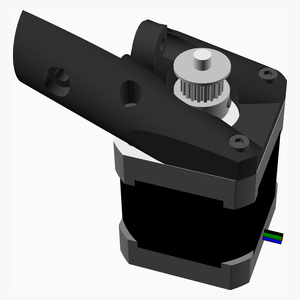
[picture p5: assemblies/loops_motor_holder_assembled_tn.png]
loops_motor_holder_assembled


<span></span>
[Top](#TOP)

---

## Idler Assembly
### Vitamins
|Qty|Description|
|---:|:---|
|4| Nut M3 x 2.4mm |
|4| Pulley GT2 idler smooth 10mm|
|4| Screw M3 cap x 25mm|
|8| Washer  M3 x 6mm x 1mm|

### 3D Printed parts

| 1 x idler_holderL1.stl | 1 x idler_holderL2.stl | 1 x idler_holderR1.stl |
|---|---|---|
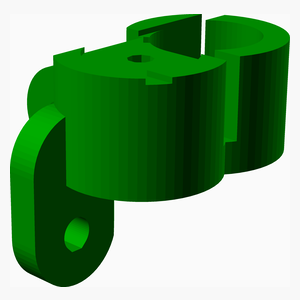
[picture p6: stls/idler_holderL1.png]
idler_holderL1.stl
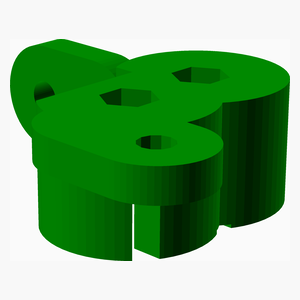
[picture p7: stls/idler_holderL2.png]
idler_holderL2.stl
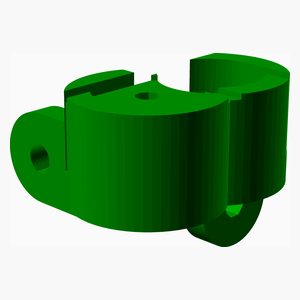
[picture p8: stls/idler_holderR1.png]
idler_holderR1.stl
|  |  |  

| 1 x idler_holderR2.stl |
|---|
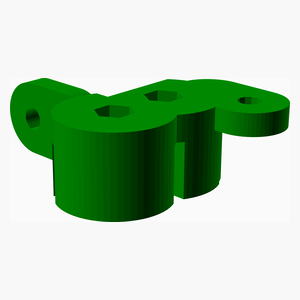
[picture p9: stls/idler_holderR2.png]
idler_holderR2.stl
|  

### Assembly instructions
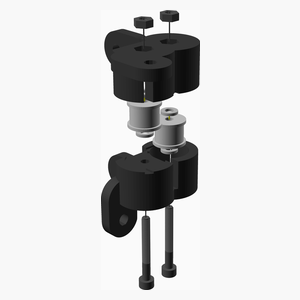
[picture p10: assemblies/idler_assembly_tn.png]
idler_assembly


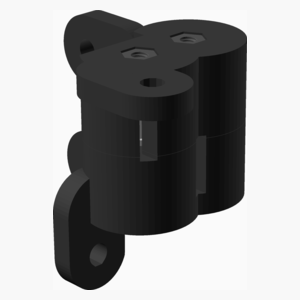
[picture p11: assemblies/idler_assembled_tn.png]
idler_assembled


<span></span>
[Top](#TOP)

---

## Bed1 Assembly
### Vitamins
|Qty|Description|
|---:|:---|
|3| Leadscrew nut 8 x 2|
|12| Nut M3 x 2.4mm |
|12| Screw M3 cap x 12mm|
|6| Smooth rod 2mm x 10mm|
|3| Spring 11.85mm OD, 0.8mm gauge x 37.8mm long, closed end|
|6| Washer  M2 x 5mm x 0.3mm|

### 3D Printed parts

| 1 x bed_holderB2.stl | 1 x bed_holderF2.stl | 1 x bed_holderL2.stl |
|---|---|---|
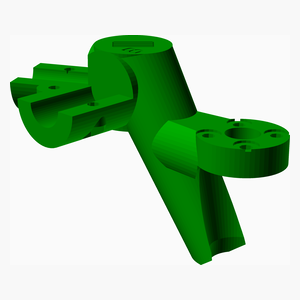
[picture p12: stls/bed_holderB2.png]
bed_holderB2.stl
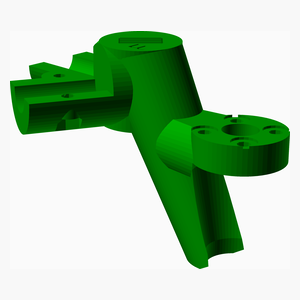
[picture p13: stls/bed_holderF2.png]
bed_holderF2.stl
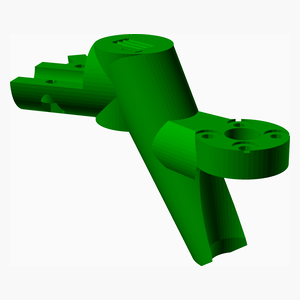
[picture p14: stls/bed_holderL2.png]
bed_holderL2.stl
|  |  |  

### Assembly instructions
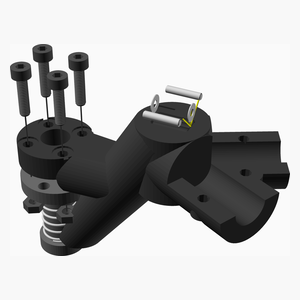
[picture p15: assemblies/bed1_assembly_tn.png]
bed1_assembly


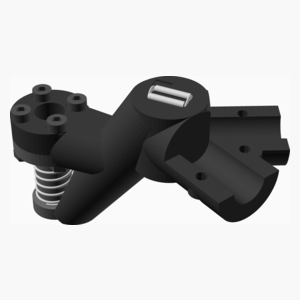
[picture p16: assemblies/bed1_assembled_tn.png]
bed1_assembled


<span></span>
[Top](#TOP)

---

## Leads1 Assembly
### Vitamins
|Qty|Description|
|---:|:---|
|12| Screw M3 cap x 12mm|
|3| Stepper motor NEMA17 x 47mm|

### 3D Printed parts

| 3 x leads_motor_holder.stl |
|---|
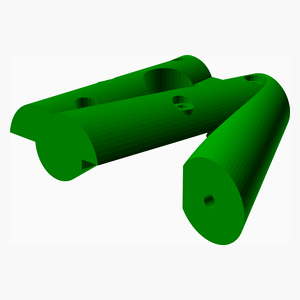
[picture p17: stls/leads_motor_holder.png]
leads_motor_holder.stl
|  

### Assembly instructions
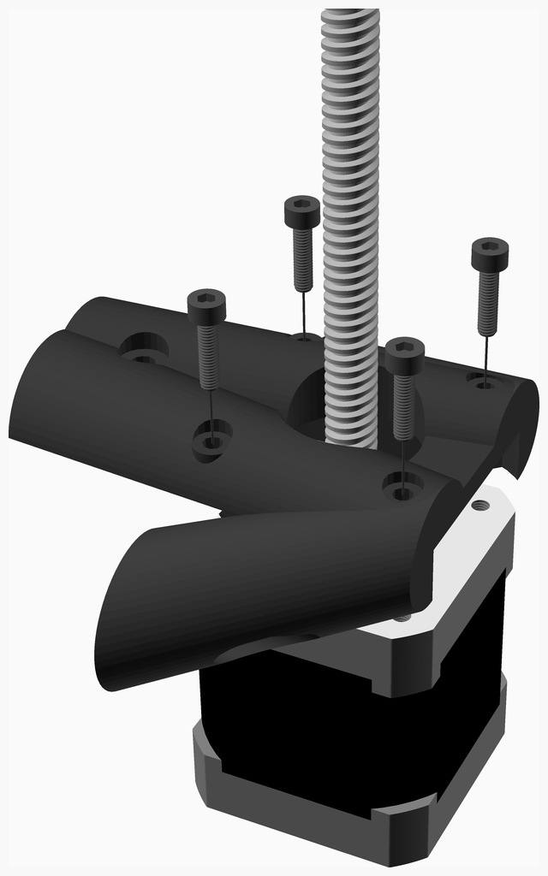
[picture p18: assemblies/leads1_assembly.png]
leads1_assembly


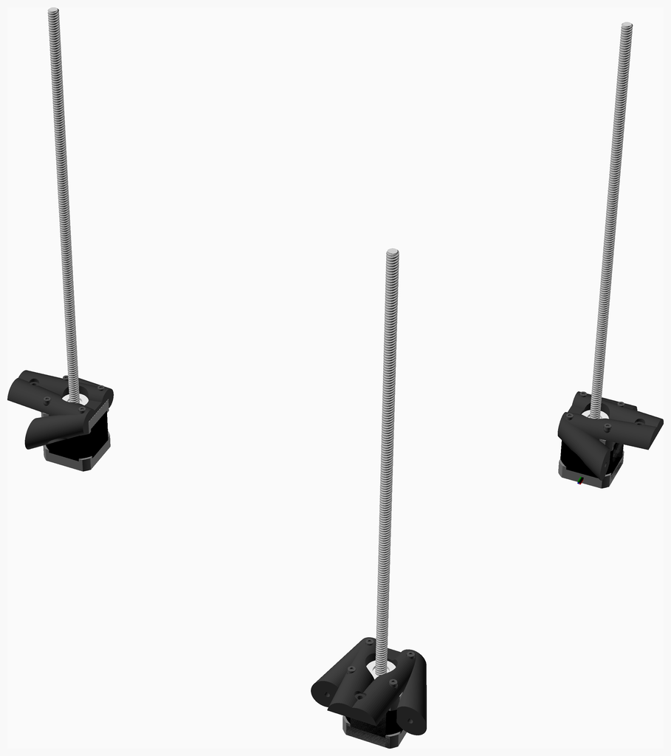
[picture p19: assemblies/leads1_assembled.png]
leads1_assembled


<span></span>
[Top](#TOP)

---

## Leads2 Assembly
### Sub-assemblies

| 1 x bed1_assembly | 1 x leads1_assembly |
|---|---|
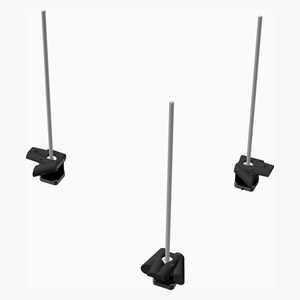
[picture p20: assemblies/leads1_assembled_tn.png]
leads1_assembled
| bed1_assembled |  

### Assembly instructions
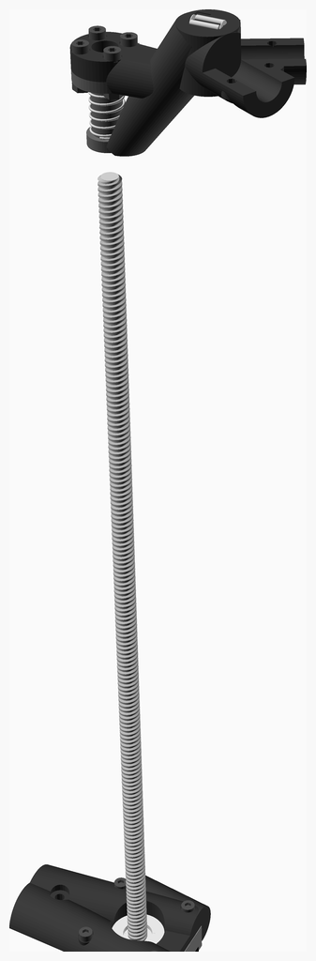
[picture p21: assemblies/leads2_assembly.png]
leads2_assembly


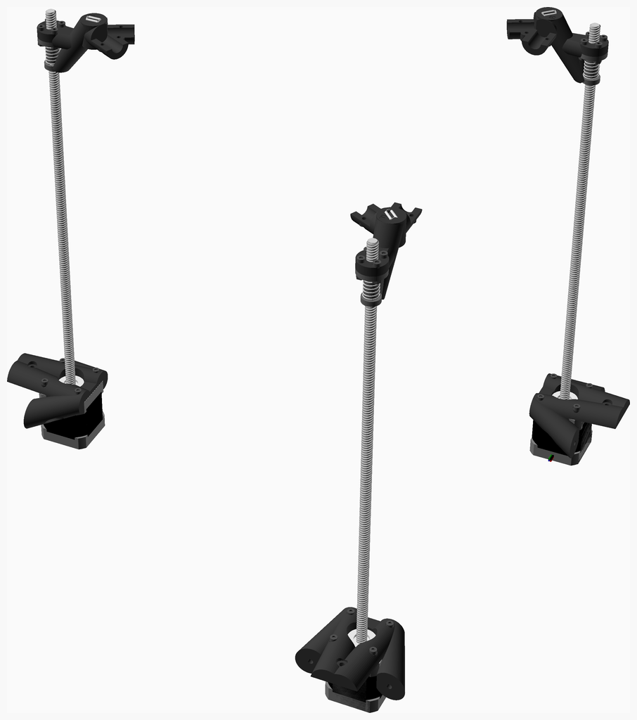
[picture p22: assemblies/leads2_assembled.png]
leads2_assembled


<span></span>
[Top](#TOP)

---

## Frame SideR Assembly
### Vitamins
|Qty|Description|
|---:|:---|
|3| Extrusion E3030 x 410mm|
|2| Extrusion E3030 x 600mm|
|4| Extrusion corner bracket 30|
|2| Extrusion inner corner bracket E30 M5|
|9| Nut M3 sliding T|
|17| Nut M4 sliding T|
|8| Screw M4 dome x  8mm|

### Assembly instructions
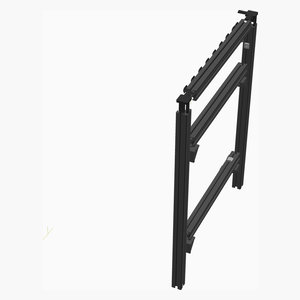
[picture p23: assemblies/frame_sideR_assembly_tn.png]
frame_sideR_assembly


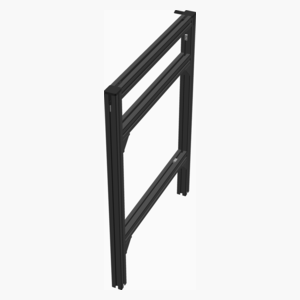
[picture p24: assemblies/frame_sideR_assembled_tn.png]
frame_sideR_assembled


<span></span>
[Top](#TOP)

---

## Frame SideL Assembly
### Vitamins
|Qty|Description|
|---:|:---|
|3| Extrusion E3030 x 410mm|
|2| Extrusion E3030 x 600mm|
|4| Extrusion corner bracket 30|
|2| Extrusion inner corner bracket E30 M5|
|9| Nut M3 sliding T|
|17| Nut M4 sliding T|
|8| Screw M4 dome x  8mm|

### Assembly instructions
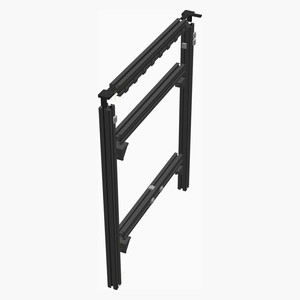
[picture p25: assemblies/frame_sideL_assembly_tn.png]
frame_sideL_assembly


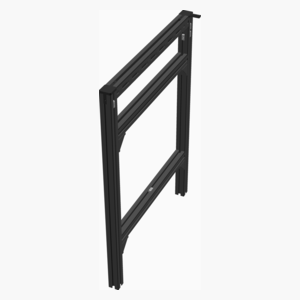
[picture p26: assemblies/frame_sideL_assembled_tn.png]
frame_sideL_assembled


<span></span>
[Top](#TOP)

---

## Frame Assembly
### Vitamins
|Qty|Description|
|---:|:---|
|4| Extrusion E3030 x 420mm|
|6| Extrusion corner bracket 30|
|15| Nut M4 sliding T|
|12| Screw M4 dome x  8mm|

### Sub-assemblies

| 1 x frame_sideL_assembly | 1 x frame_sideR_assembly |
|---|---|
| frame_sideL_assembled | frame_sideR_assembled 

### Assembly instructions
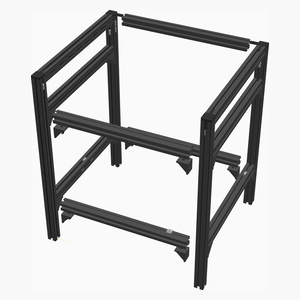
[picture p27: assemblies/frame_assembly_tn.png]
frame_assembly


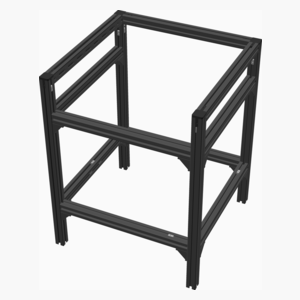
[picture p28: assemblies/frame_assembled_tn.png]
frame_assembled


<span></span>
[Top](#TOP)

---

## Frame1 Assembly
### Vitamins
|Qty|Description|
|---:|:---|
|9| Screw M4 dome x 12mm|

### Sub-assemblies

| 1 x frame_assembly | 1 x leads2_assembly |
|---|---|
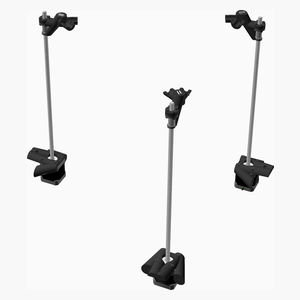
[picture p29: assemblies/leads2_assembled_tn.png]
leads2_assembled
| frame_assembled |  

### Assembly instructions
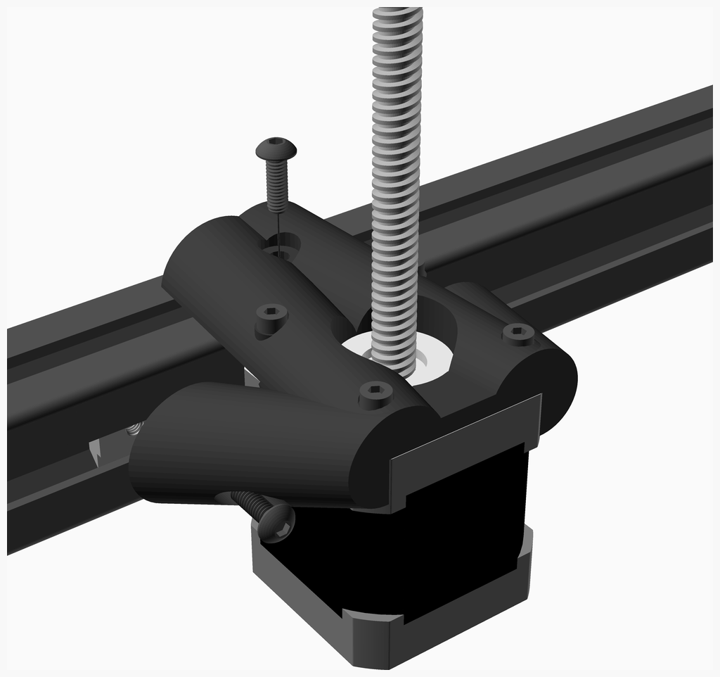
[picture p30: assemblies/frame1_assembly.png]
frame1_assembly


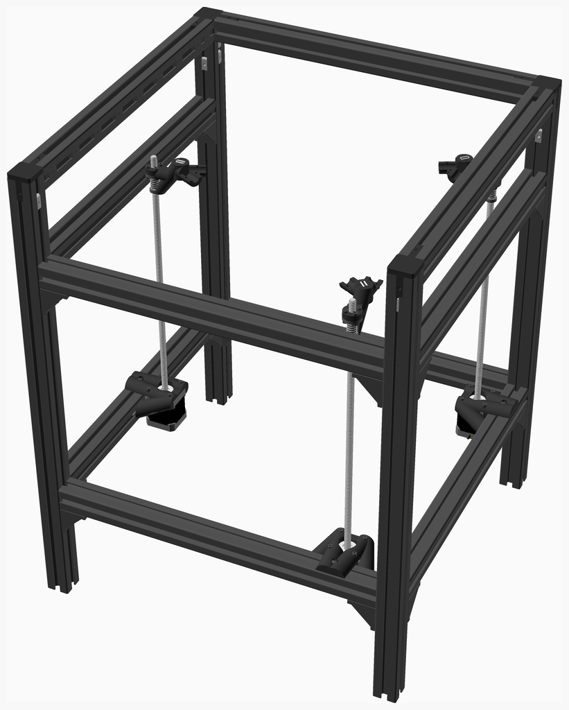
[picture p31: assemblies/frame1_assembled.png]
frame1_assembled


<span></span>
[Top](#TOP)

---

## Frame2 Assembly
### Vitamins
|Qty|Description|
|---:|:---|
|3| Ball bearing 608-2RS 8mm x 22mm x 7mm|
|9| Screw M4 dome x 12mm|

### 3D Printed parts

| 3 x leads_holder.stl |
|---|
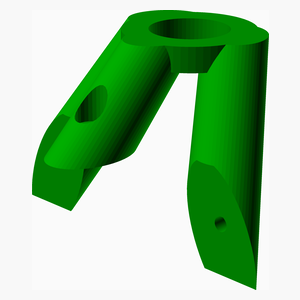
[picture p32: stls/leads_holder.png]
leads_holder.stl
|  

### Sub-assemblies

| 1 x frame1_assembly |
|---|
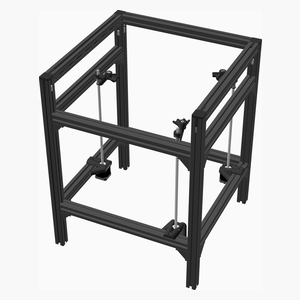
[picture p33: assemblies/frame1_assembled_tn.png]
frame1_assembled
|  

### Assembly instructions
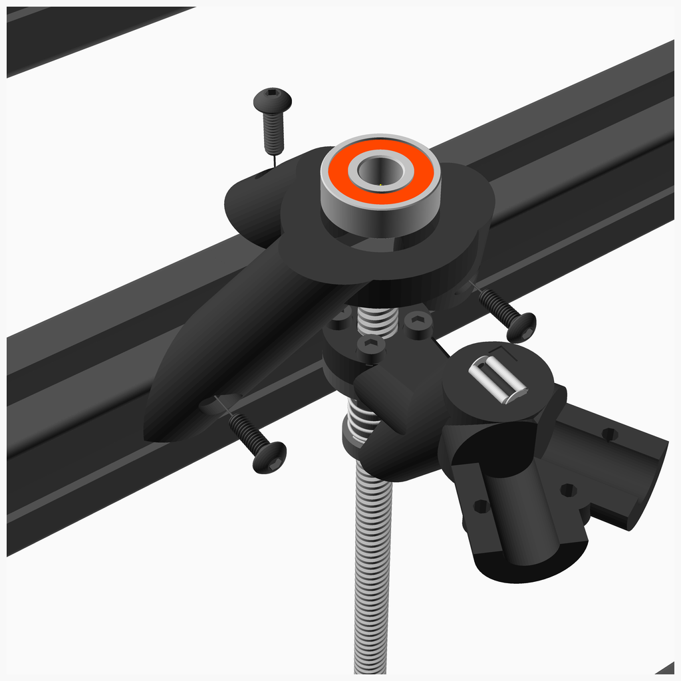
[picture p34: assemblies/frame2_assembly.png]
frame2_assembly


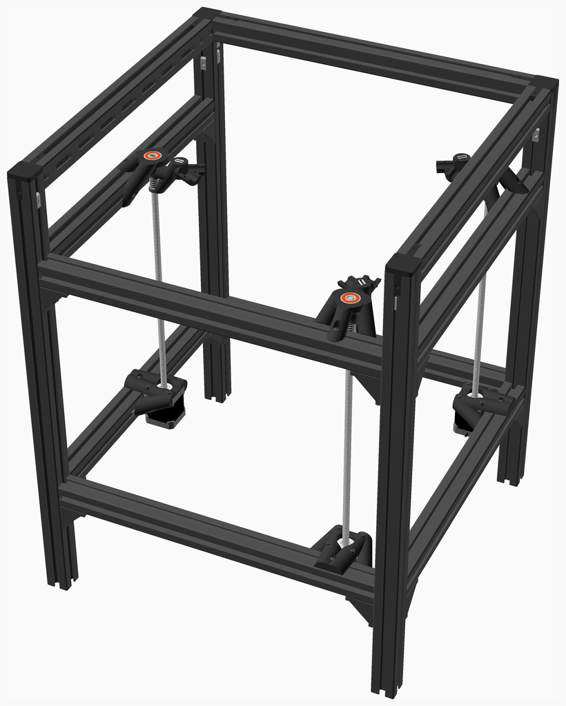
[picture p35: assemblies/frame2_assembled.png]
frame2_assembled


<span></span>
[Top](#TOP)

---

## Frame3 Assembly
### Vitamins
|Qty|Description|
|---:|:---|
|1| Carbon fiber OD 10mm ID 8mm x 283mm|
|2| Carbon fiber OD 10mm ID 8mm x 318.882mm|
|9| Nut M3 x 2.4mm |
|9| Screw M3 cap x 12mm|

### 3D Printed parts

| 1 x bed_holderB1.stl | 1 x bed_holderF1.stl | 1 x bed_holderL1.stl |
|---|---|---|
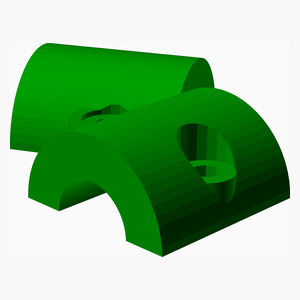
[picture p36: stls/bed_holderB1.png]
bed_holderB1.stl
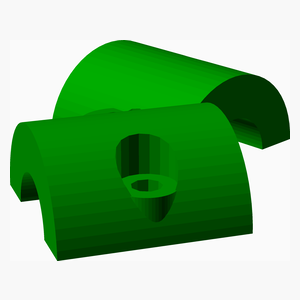
[picture p37: stls/bed_holderF1.png]
bed_holderF1.stl
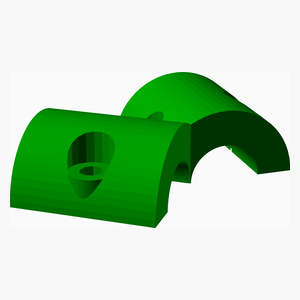
[picture p38: stls/bed_holderL1.png]
bed_holderL1.stl
|  |  |  

### Sub-assemblies

| 1 x frame2_assembly |
|---|
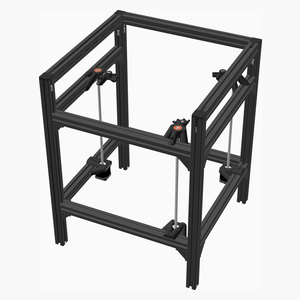
[picture p39: assemblies/frame2_assembled_tn.png]
frame2_assembled
|  

### Assembly instructions
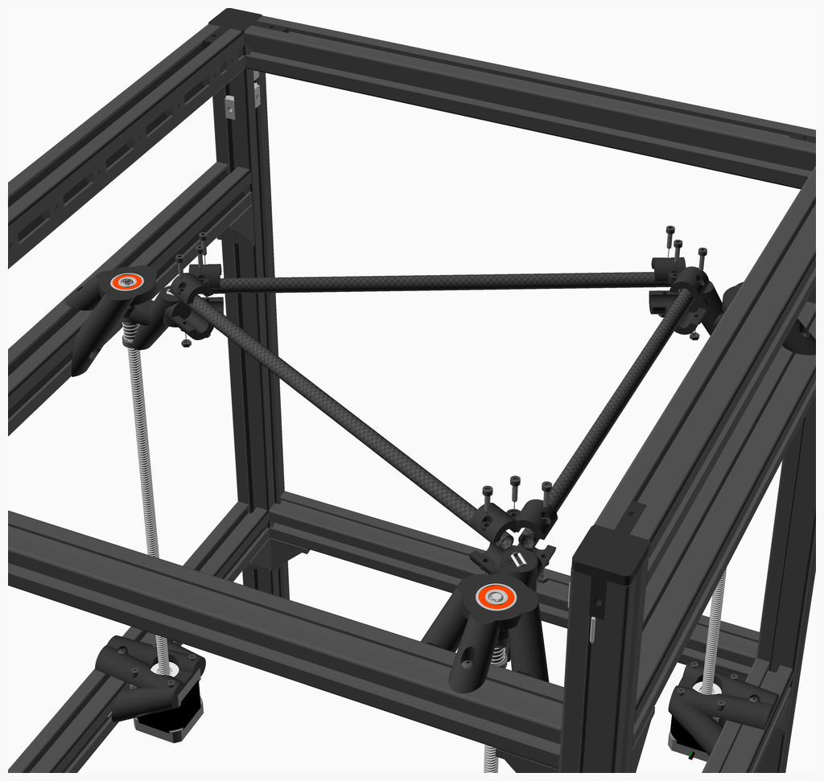
[picture p40: assemblies/frame3_assembly.png]
frame3_assembly


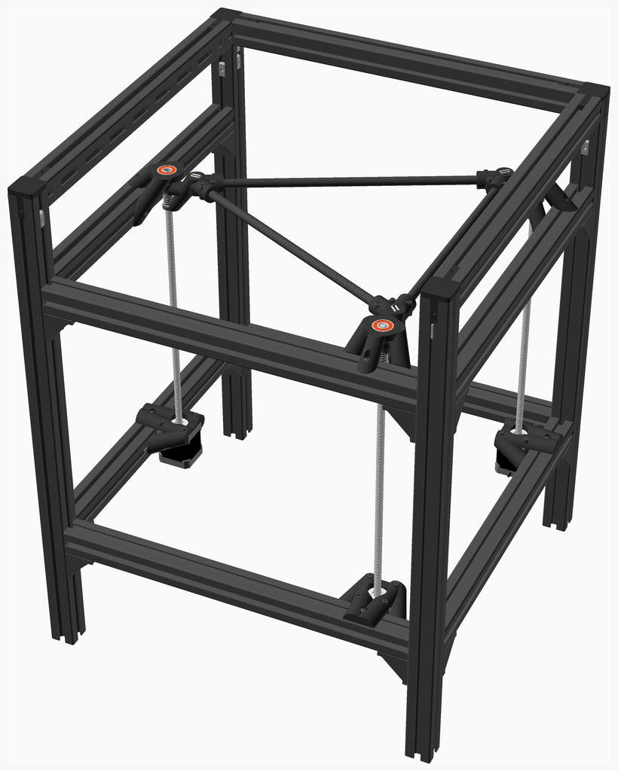
[picture p41: assemblies/frame3_assembled.png]
frame3_assembled


<span></span>
[Top](#TOP)

---

## Frame10 Assembly
### Vitamins
|Qty|Description|
|---:|:---|
|8| Screw M4 dome x  8mm|

### Sub-assemblies

| 1 x frame3_assembly | 1 x idler_assembly |
|---|---|
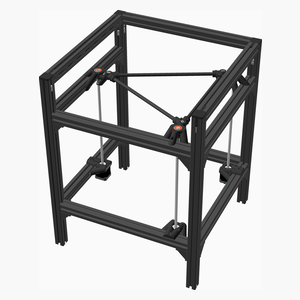
[picture p42: assemblies/frame3_assembled_tn.png]
frame3_assembled
|  | idler_assembled 

### Assembly instructions
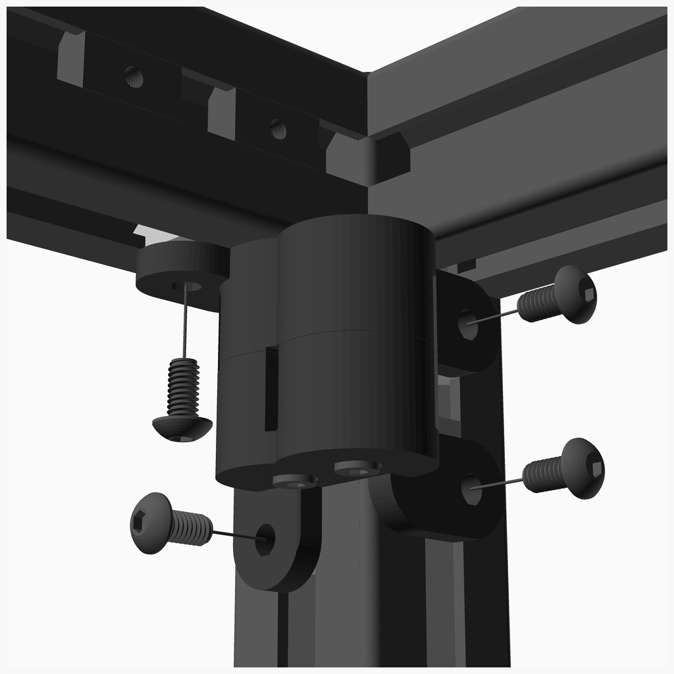
[picture p43: assemblies/frame10_assembly.png]
frame10_assembly


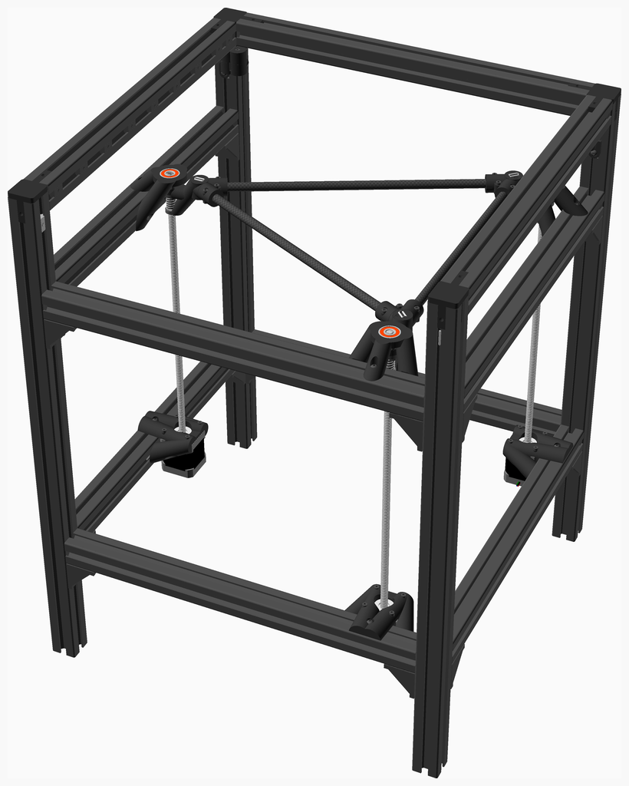
[picture p44: assemblies/frame10_assembled.png]
frame10_assembled


<span></span>
[Top](#TOP)

---

## Frame11 Assembly
### Vitamins
|Qty|Description|
|---:|:---|
|4| Screw M4 dome x 12mm|

### Sub-assemblies

| 1 x frame10_assembly | 1 x loops_motor_holder_assembly |
|---|---|
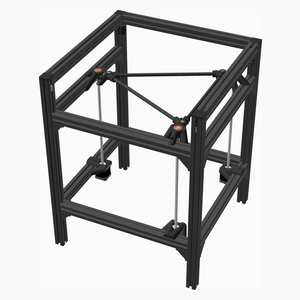
[picture p45: assemblies/frame10_assembled_tn.png]
frame10_assembled
|  | loops_motor_holder_assembled 

### Assembly instructions
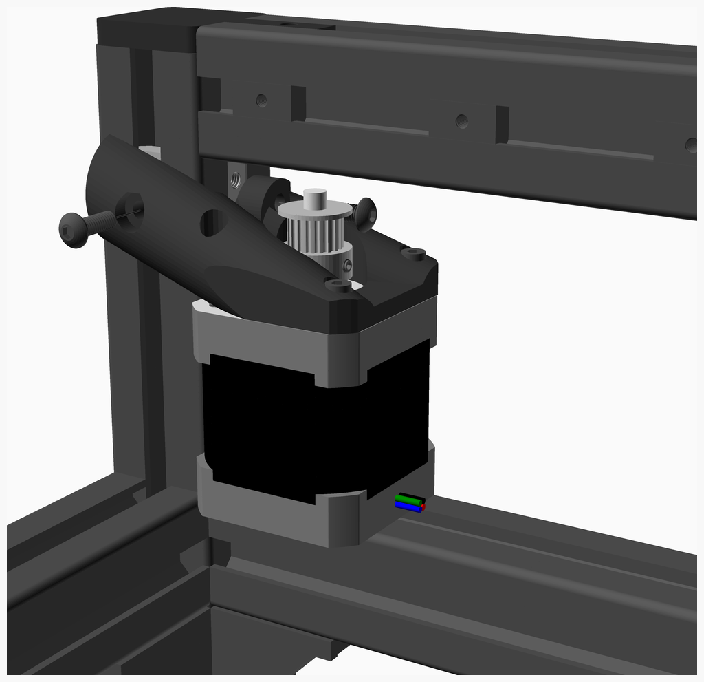
[picture p46: assemblies/frame11_assembly.png]
frame11_assembly


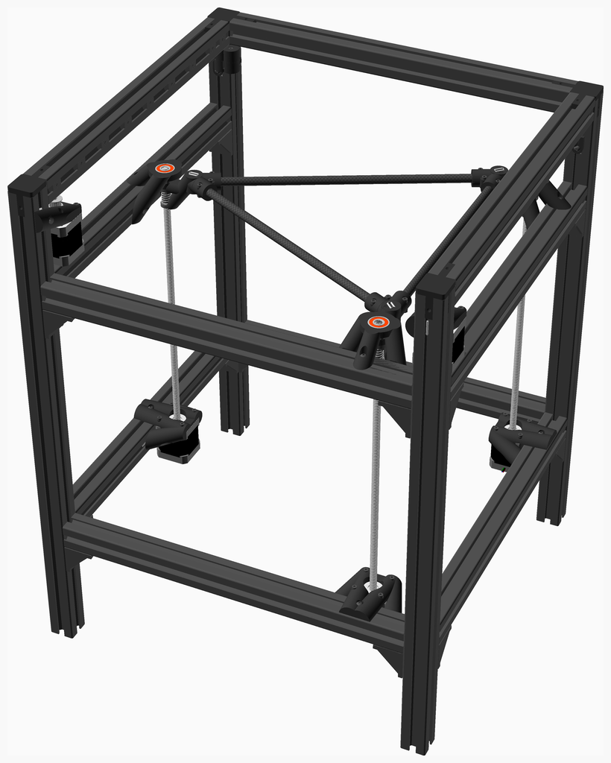
[picture p47: assemblies/frame11_assembled.png]
frame11_assembled


<span></span>
[Top](#TOP)

---

## Frame20 Assembly
### Vitamins
|Qty|Description|
|---:|:---|
|2| Linear rail MGN12 x 410mm|
|18| Screw M3 cap x  5mm|

### Sub-assemblies

| 1 x frame11_assembly |
|---|
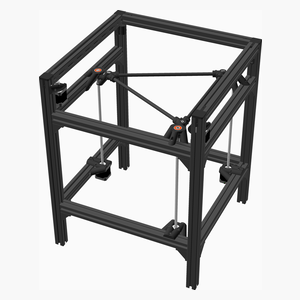
[picture p48: assemblies/frame11_assembled_tn.png]
frame11_assembled
|  

### Assembly instructions
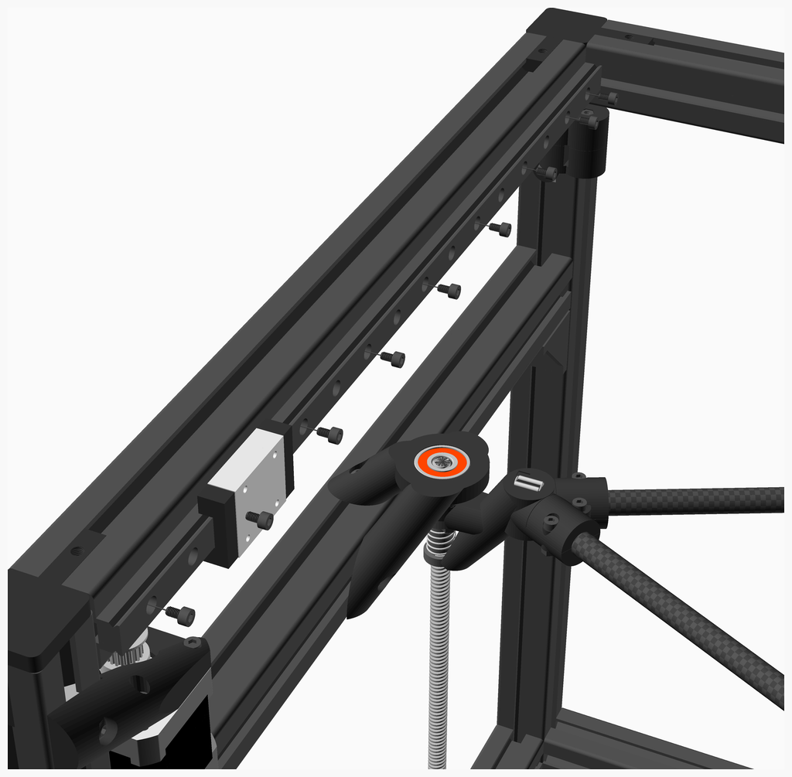
[picture p49: assemblies/frame20_assembly.png]
frame20_assembly


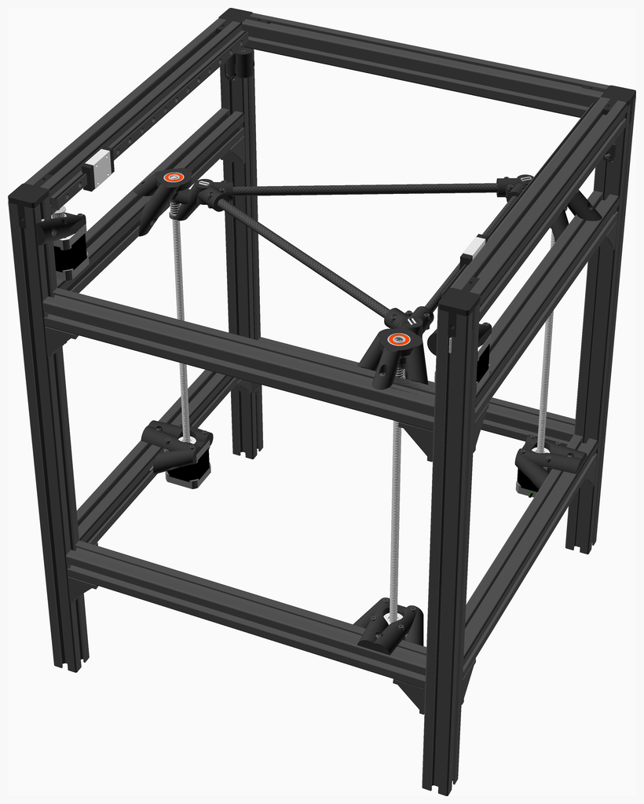
[picture p50: assemblies/frame20_assembled.png]
frame20_assembled


<span></span>
[Top](#TOP)

---

## Frame21 Assembly
### Vitamins
|Qty|Description|
|---:|:---|
|4| Nut M3 x 2.4mm |
|4| Screw M3 cap x 10mm|
|4| Screw M3 cap x 12mm|

### 3D Printed parts

| 1 x x_holderL1.stl | 1 x x_holderR1.stl |
|---|---|
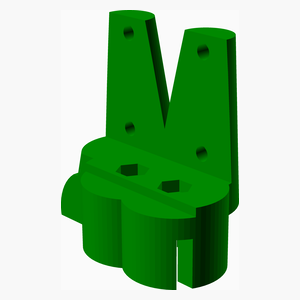
[picture p51: stls/x_holderL1.png]
x_holderL1.stl
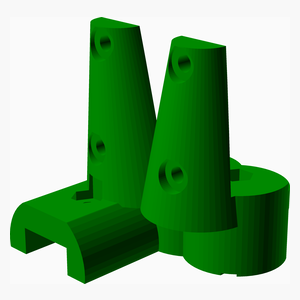
[picture p52: stls/x_holderR1.png]
x_holderR1.stl
|  |  

### Sub-assemblies

| 1 x frame20_assembly |
|---|
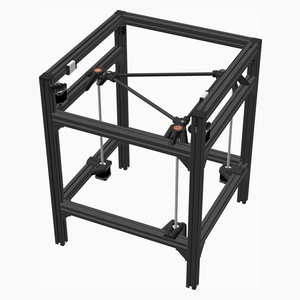
[picture p53: assemblies/frame20_assembled_tn.png]
frame20_assembled
|  

### Assembly instructions
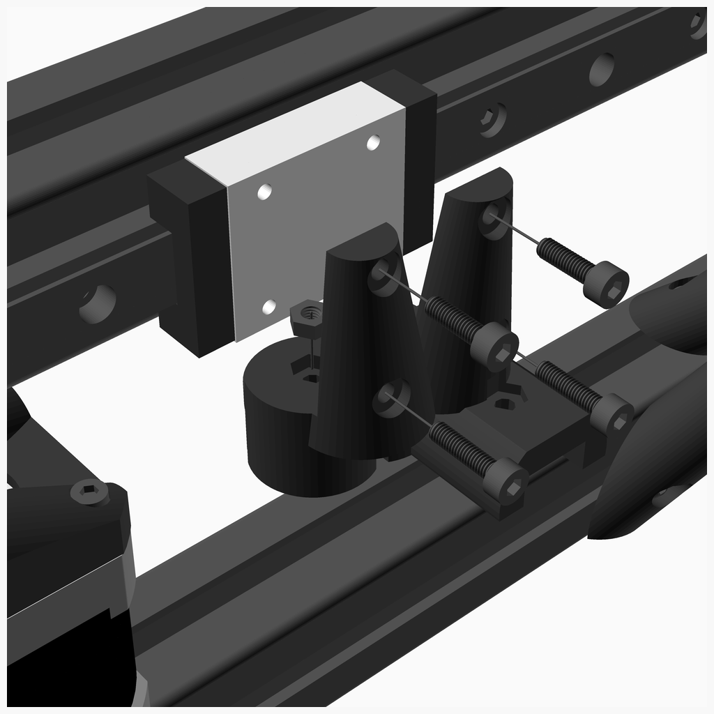
[picture p54: assemblies/frame21_assembly.png]
frame21_assembly


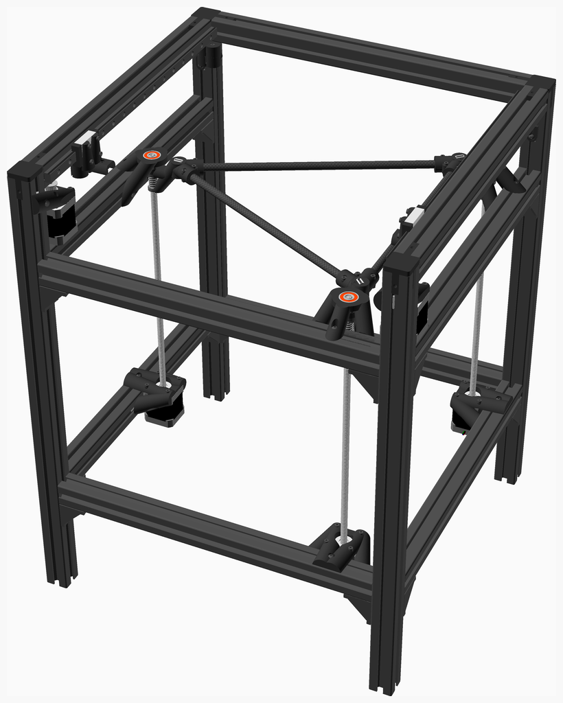
[picture p55: assemblies/frame21_assembled.png]
frame21_assembled


<span></span>
[Top](#TOP)

---

## Frame22 Assembly
### Vitamins
|Qty|Description|
|---:|:---|
|1| Linear rail MGN12 x 396mm|
|2| Nut M3 x 2.4mm |
|4| Pulley GT2 idler smooth 10mm|
|2| Screw M3 cap x 16mm|
|4| Screw M3 cap x 30mm|
|8| Washer  M3 x 6mm x 1mm|

### 3D Printed parts

| 1 x x_holderL2.stl | 1 x x_holderR2.stl |
|---|---|
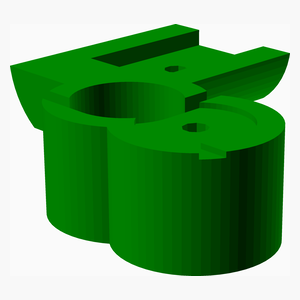
[picture p56: stls/x_holderL2.png]
x_holderL2.stl
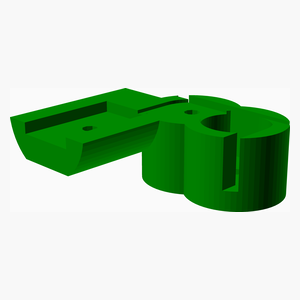
[picture p57: stls/x_holderR2.png]
x_holderR2.stl
|  |  

### Sub-assemblies

| 1 x frame21_assembly |
|---|
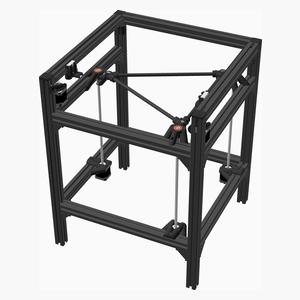
[picture p58: assemblies/frame21_assembled_tn.png]
frame21_assembled
|  

### Assembly instructions
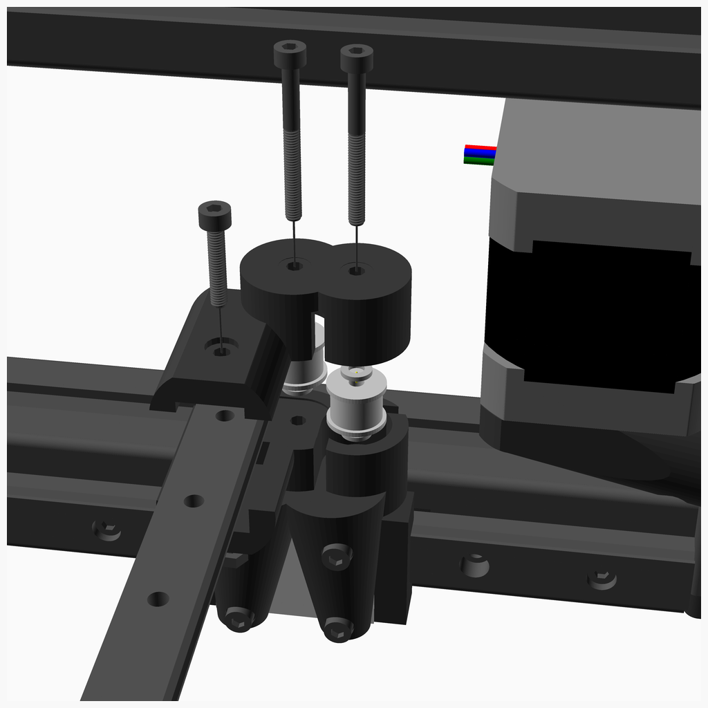
[picture p59: assemblies/frame22_assembly.png]
frame22_assembly


frame22_assembled

<span></span>
[Top](#TOP)
