SmoothieAq/cevo2/build/stls/bed_holderL2.stl

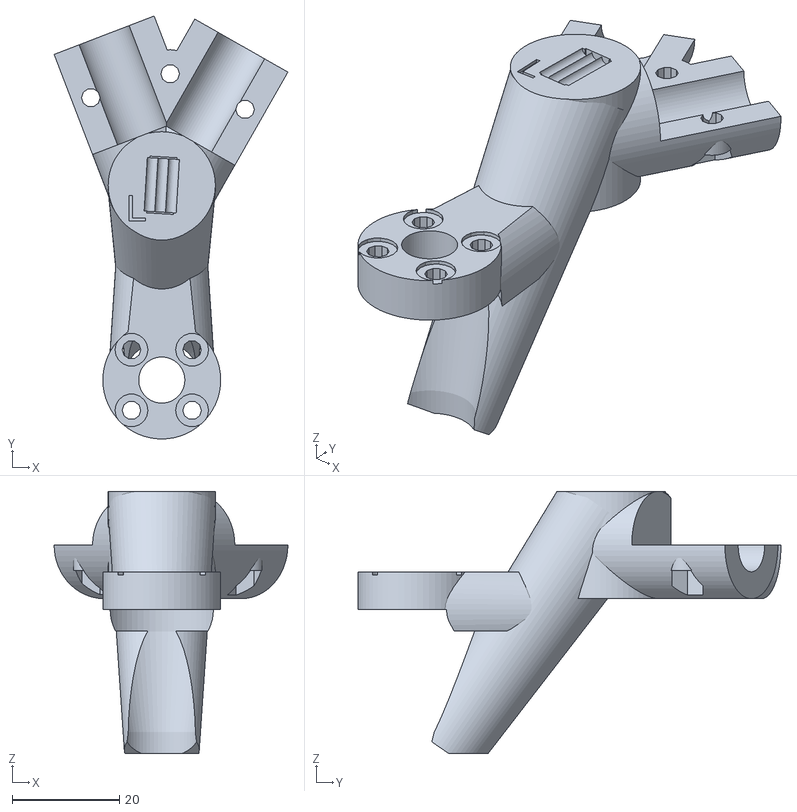
[picture p60: CAD file, 2021-05-01]
build/stls/bed_holderL2.stl
43.6 x 78.9 x 48.9
