SmoothieAq/cevo2/div/PrusaSlicer-proj/leads_holder.3mf

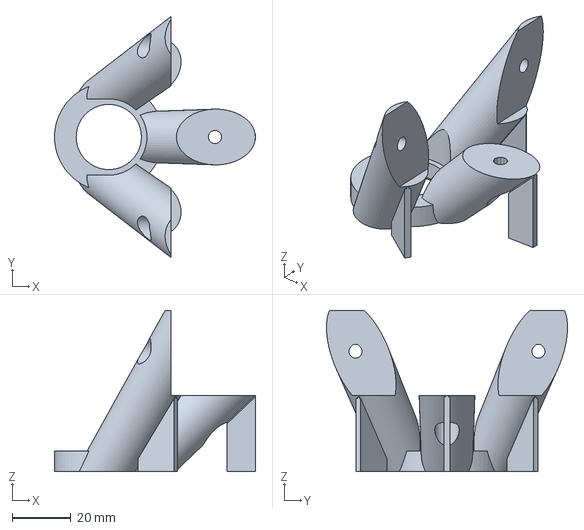
[picture p61: CAD file, 2021-12-31]
div/PrusaSlicer-proj/leads_holder.3mf
68.5 x 82.1 x 55.0 mm
