SmoothieAq/cevo2/scad/extparts/RHD_BMG_Mosquito_Fan_Shroud.stl

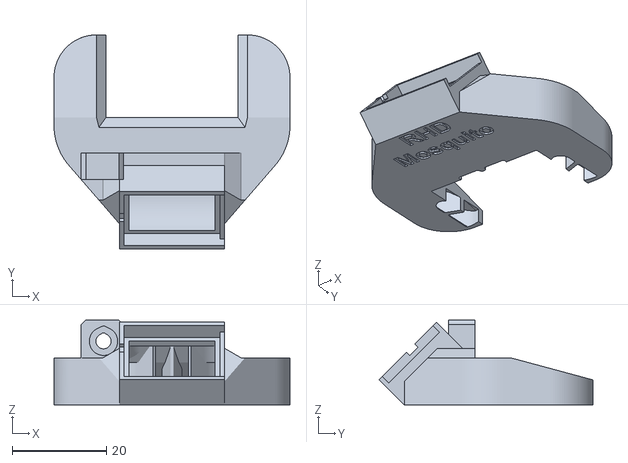
[picture p62: CAD file, 2021-02-27]
scad/extparts/RHD_BMG_Mosquito_Fan_Shroud.stl
50.0 x 45.4 x 18.0
