SmoothieAq/cevo2/std/stls/bed_holderL2.stl

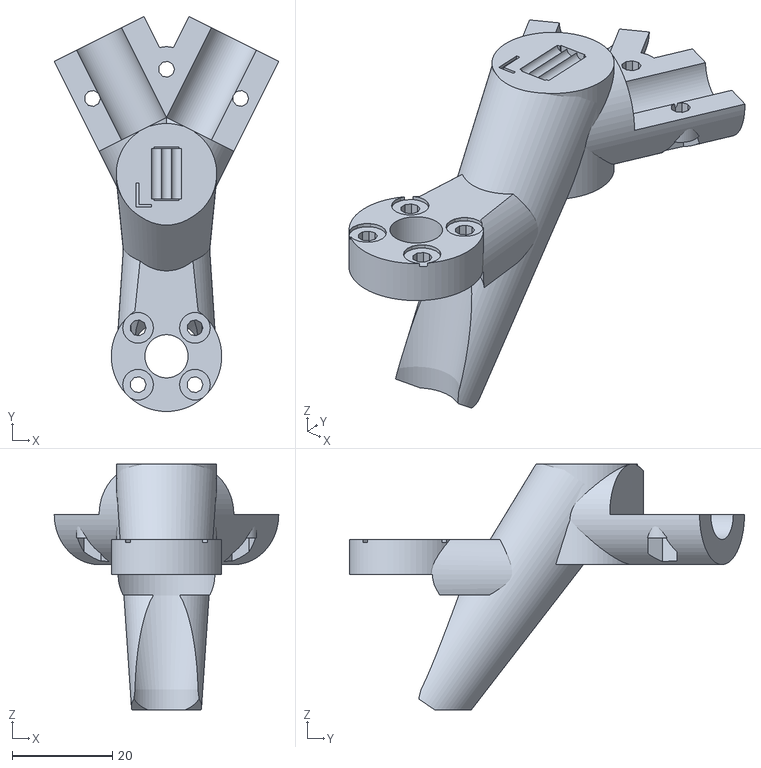
[picture p63: CAD file, 2021-01-30]
std/stls/bed_holderL2.stl
44.7 x 78.7 x 48.9
