SmoothieAq/cevo2/build/stls/rail_y_back_stop.stl

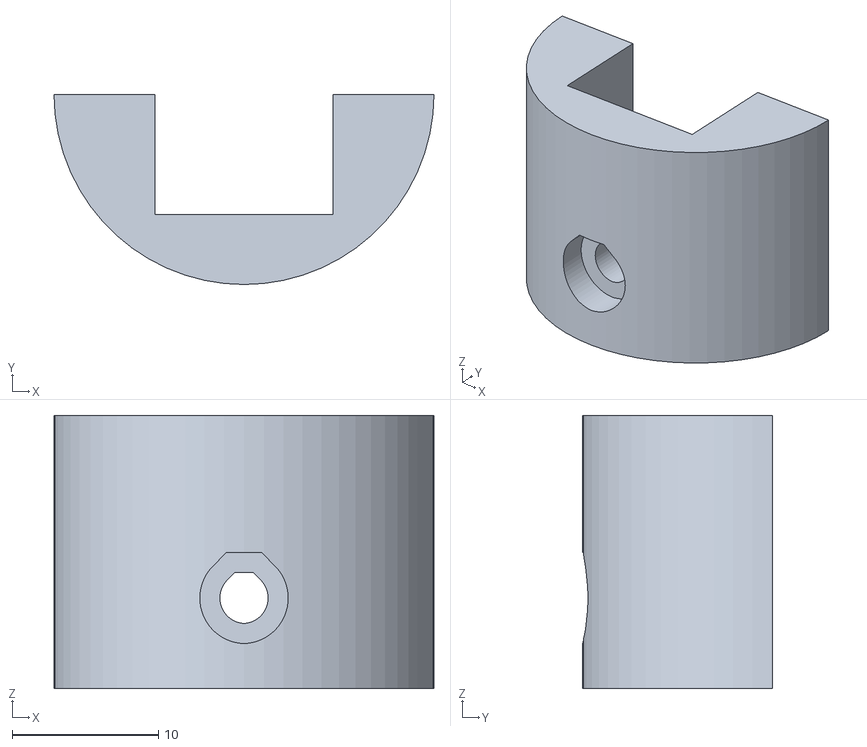
[picture p64: CAD file, 2021-05-01]
build/stls/rail_y_back_stop.stl
26.0 x 13.0 x 18.7
