SmoothieAq/cevo2/div/PrusaSlicer-proj/loops_motor_holders.3mf

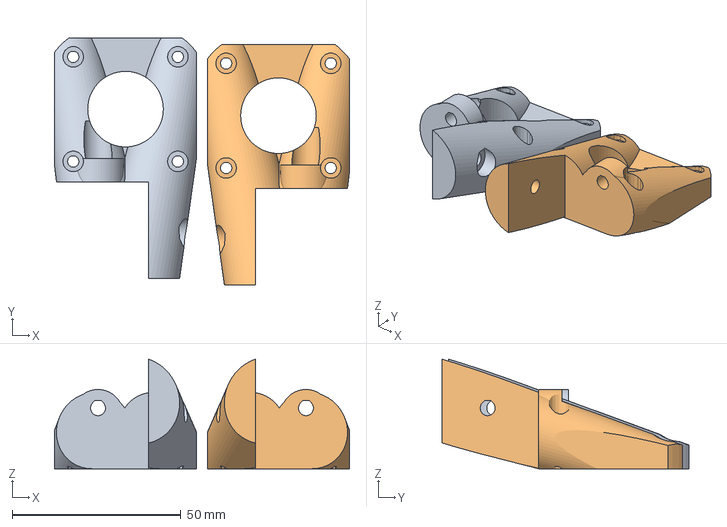
[picture p65: CAD file, 2021-04-05]
div/PrusaSlicer-proj/loops_motor_holders.3mf
87.4 x 73.1 x 32.5 mm
loops_motor_holderL.stl
loops_motor_holderR.stl
