SmoothieAq/cevo2/scad/extparts/BLTouch_contracted.stl

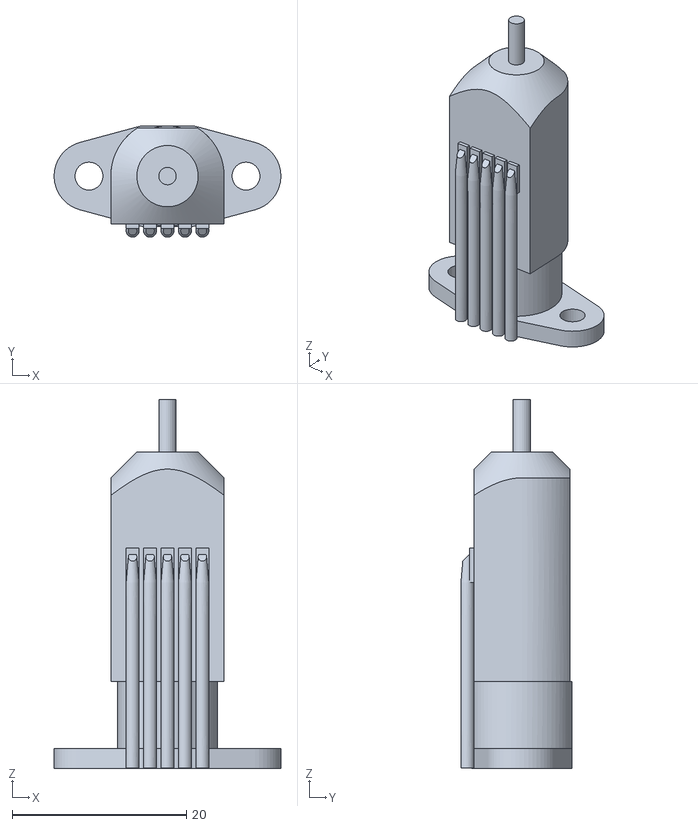
[picture p66: CAD file, 2021-02-27]
scad/extparts/BLTouch_contracted.stl
26.0 x 12.8 x 42.3
