SmoothieAq/cevo2/build/stls/leads_motor_holderL.stl

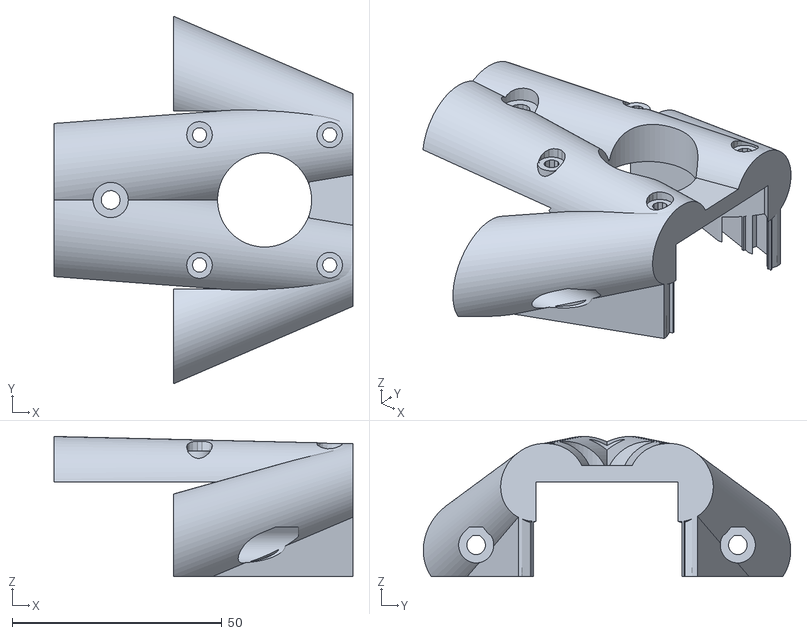
[picture p67: CAD file, 2021-05-01]
build/stls/leads_motor_holderL.stl
71.2 x 87.5 x 33.4
