SmoothieAq/cevo2/scad/extparts/BLTouch_extracted.stl

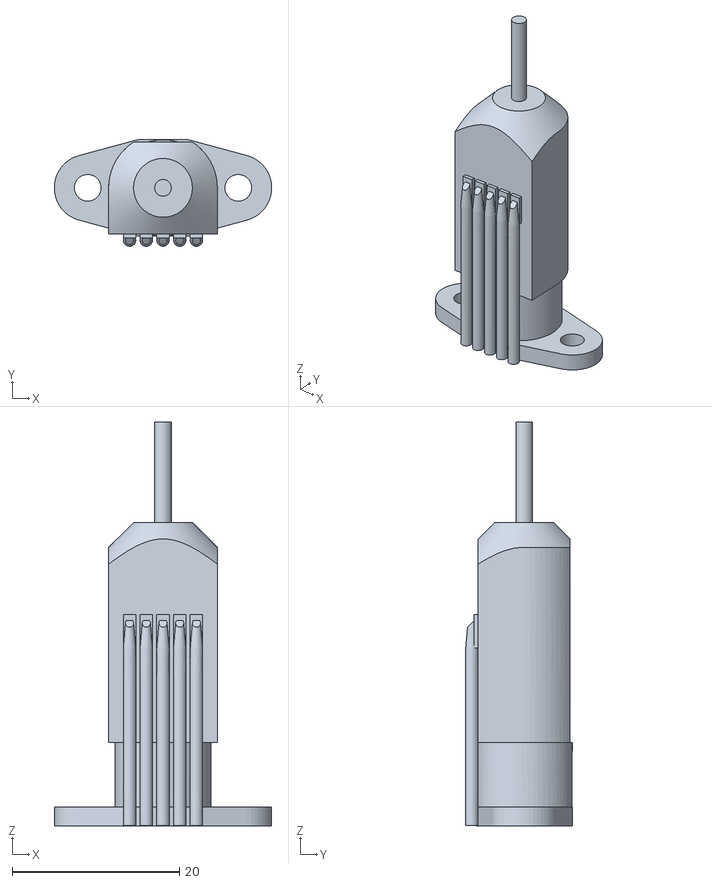
[picture p68: CAD file, 2021-02-27]
scad/extparts/BLTouch_extracted.stl
26.0 x 12.8 x 48.3
