SmoothieAq/cevo2/build/stls/idler_holderR1.stl

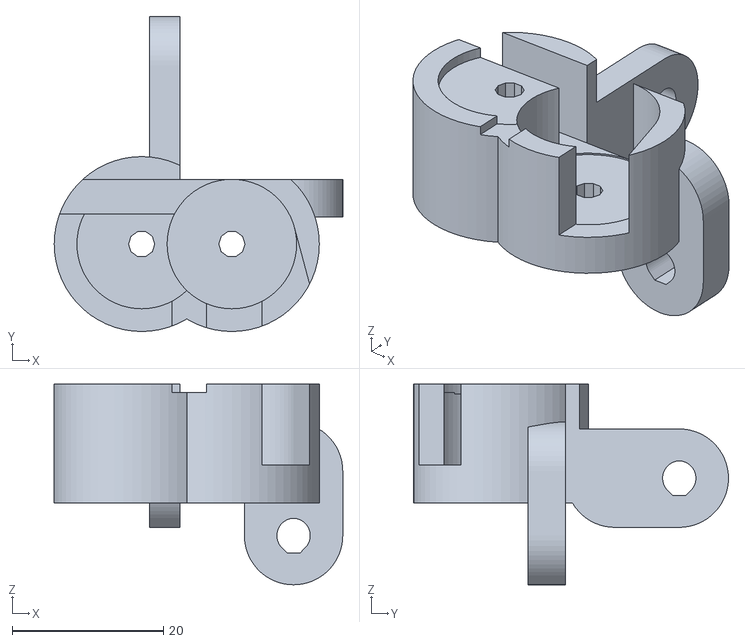
[picture p69: CAD file, 2021-05-01]
build/stls/idler_holderR1.stl
38.1 x 41.6 x 26.5
