SmoothieAq/cevo2/scad/extparts/Latch_v1.5.stl

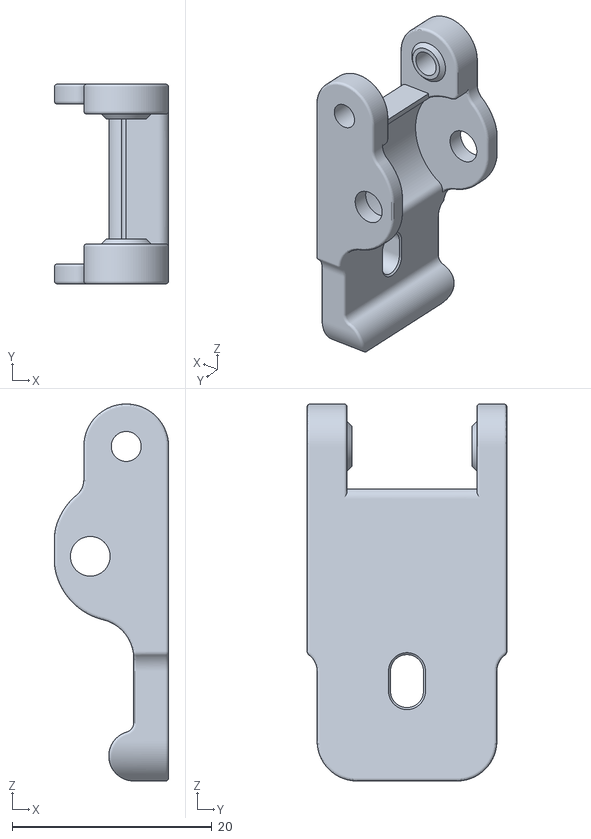
[picture p70: CAD file, 2021-02-22]
scad/extparts/Latch_v1.5.stl
11.4 x 20.0 x 37.7
