SmoothieAq/cevo2/build/stls/x_holderR2.stl

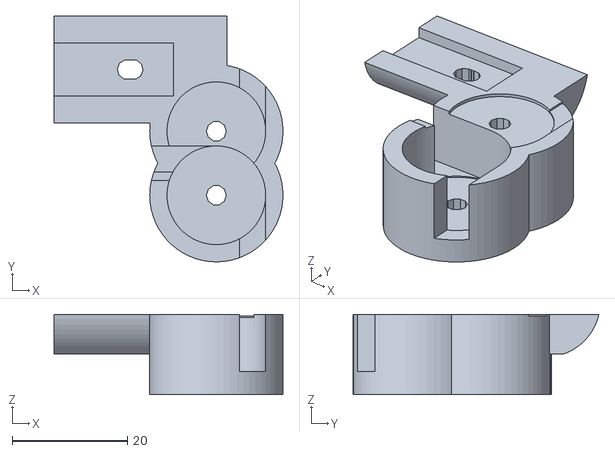
[picture p71: CAD file, 2021-05-01]
build/stls/x_holderR2.stl
39.7 x 42.6 x 13.9
