SmoothieAq/cevo2/scad/extparts/Mosquito_Hotend_Std.STL

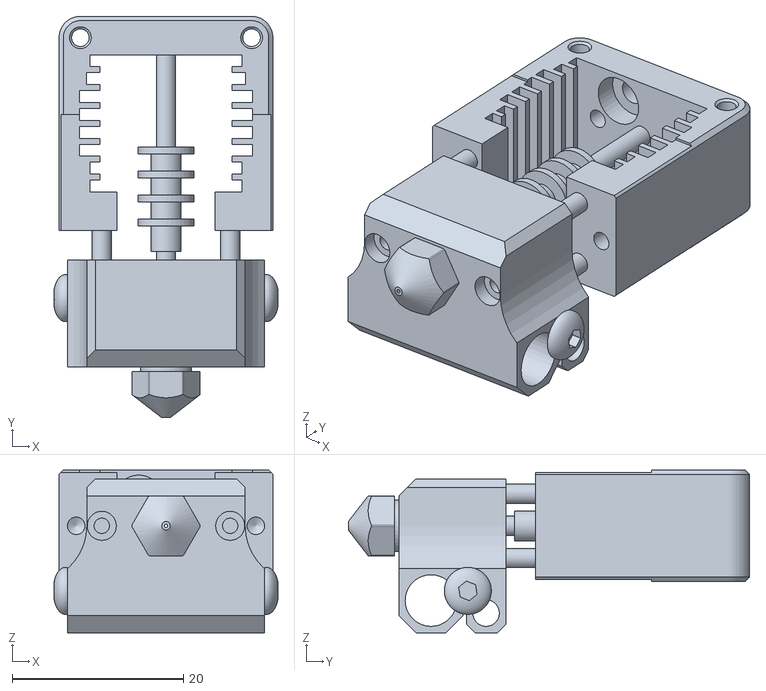
[picture p72: CAD file, 2021-02-22]
scad/extparts/Mosquito_Hotend_Std.STL
26.2 x 46.9 x 19.0
