SmoothieAq/cevo2/build/stls/bed_holderF2.stl

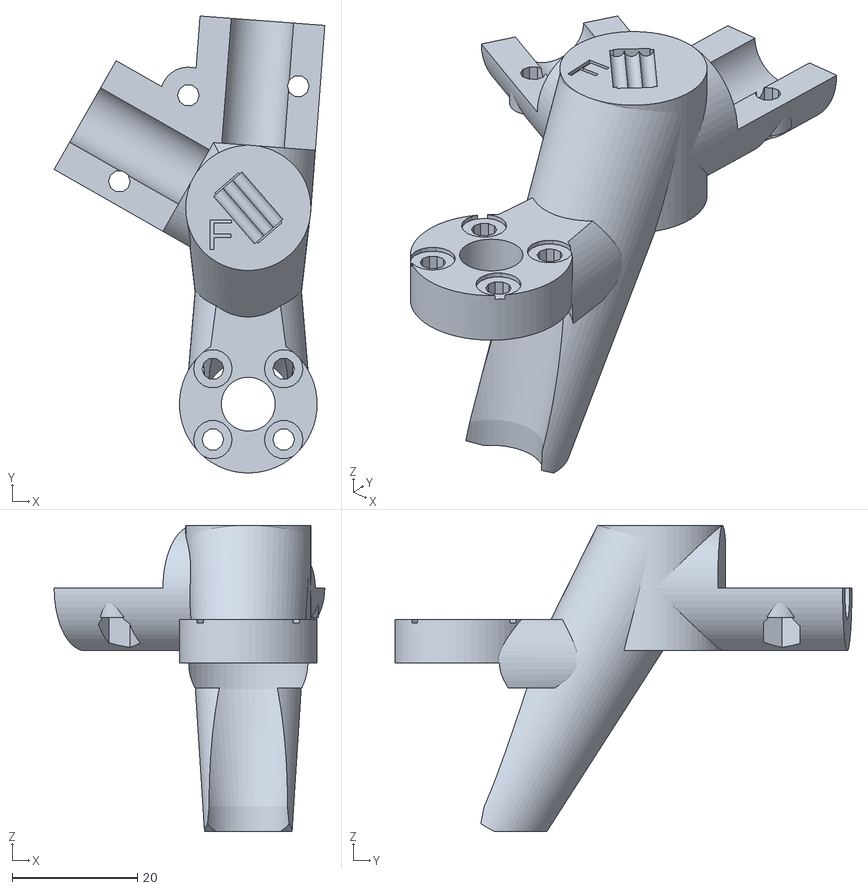
[picture p73: CAD file, 2021-05-01]
build/stls/bed_holderF2.stl
43.2 x 73.0 x 48.9
