SmoothieAq/cevo2/scad/extparts/Gear_Housing_65_teeth.stl

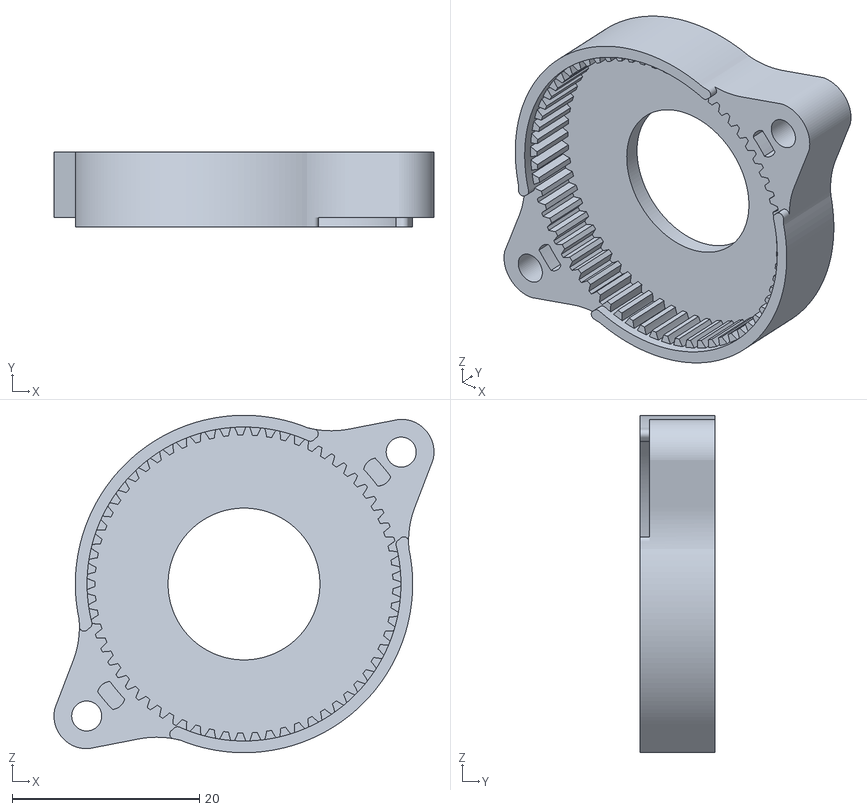
[picture p74: CAD file, 2021-02-22]
scad/extparts/Gear_Housing_65_teeth.stl
40.6 x 8.00 x 36.0
