SmoothieAq/cevo2/build/stls/leads_motor_holderB.stl

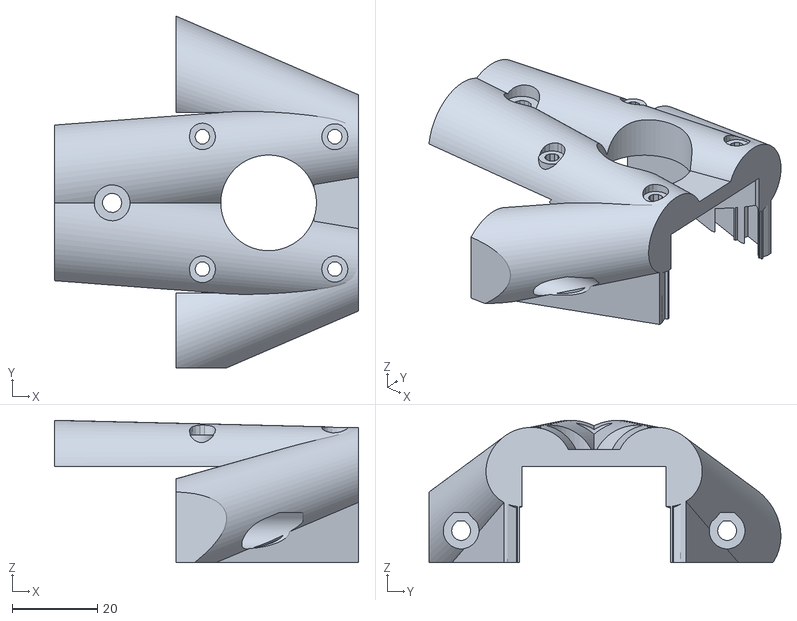
[picture p75: CAD file, 2021-05-01]
build/stls/leads_motor_holderB.stl
71.2 x 82.4 x 33.4
