SmoothieAq/cevo2/scad/extparts/Orbiter_Housing_1.5.stl

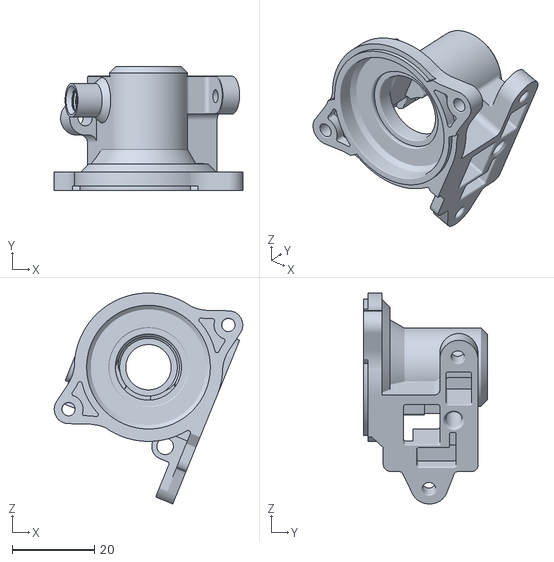
[picture p76: CAD file, 2021-02-22]
scad/extparts/Orbiter_Housing_1.5.stl
45.7 x 30.0 x 51.2
