SmoothieAq/cevo2/build/stls/x_holderR1.stl

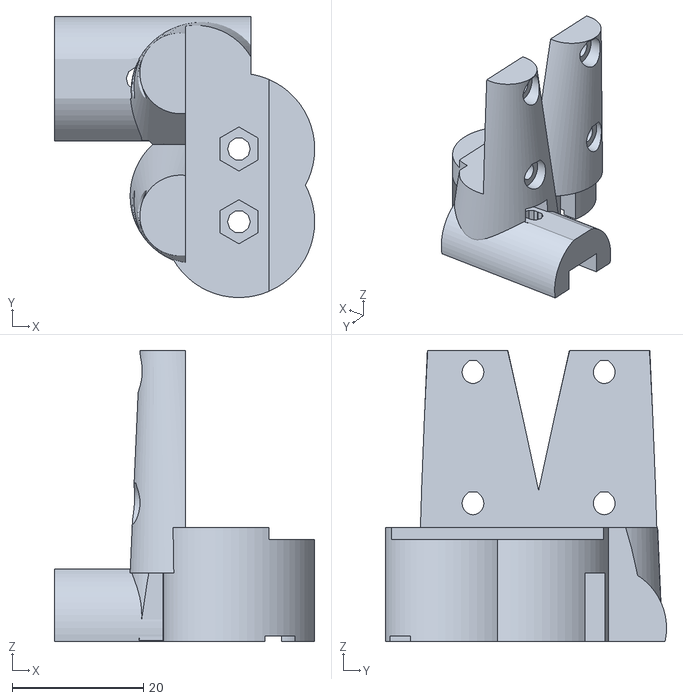
[picture p77: CAD file, 2021-05-01]
build/stls/x_holderR1.stl
39.7 x 42.8 x 44.3
