SmoothieAq/cevo2/build/stls/idler_holderL2.stl

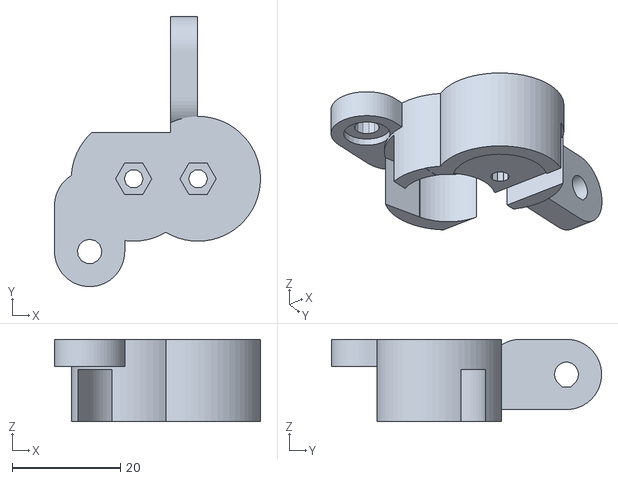
[picture p78: CAD file, 2021-05-01]
build/stls/idler_holderL2.stl
38.1 x 50.0 x 15.2
