SmoothieAq/cevo2/build/stls/leads_motor_holder.3mf

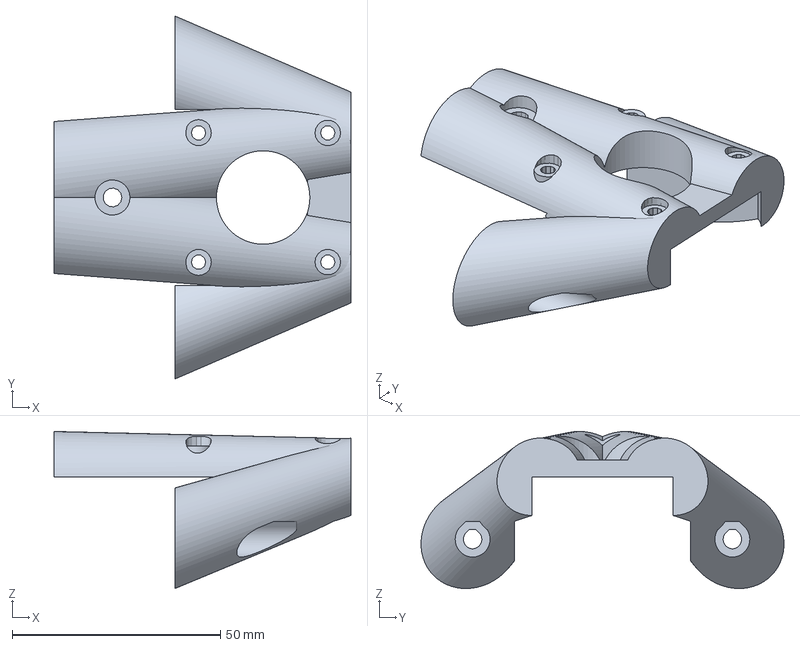
[picture p79: CAD file, 2021-05-01]
build/stls/leads_motor_holder.3mf
71.2 x 87.1 x 37.7 mm
