SmoothieAq/cevo2/build/stls/idler_holderR2.stl

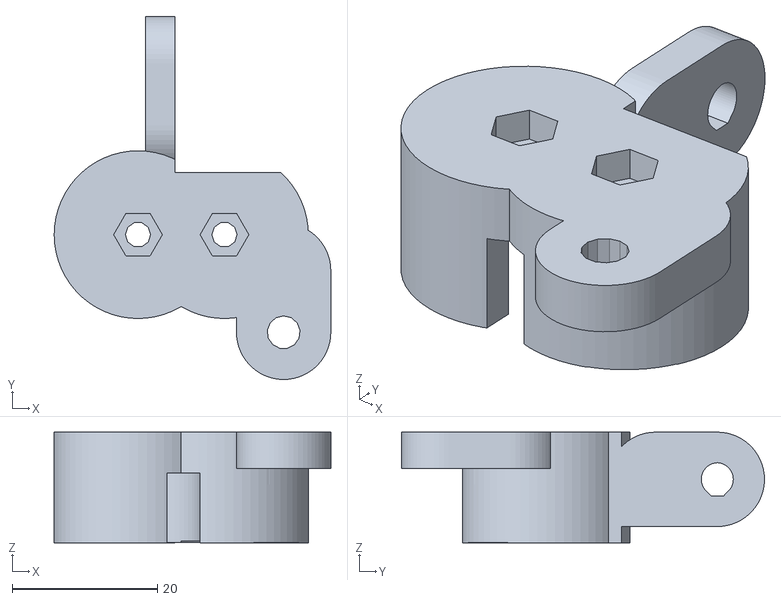
[picture p80: CAD file, 2021-05-01]
build/stls/idler_holderR2.stl
38.1 x 50.0 x 15.2
