SmoothieAq/cevo2/build/stls/bed_holderF1.stl

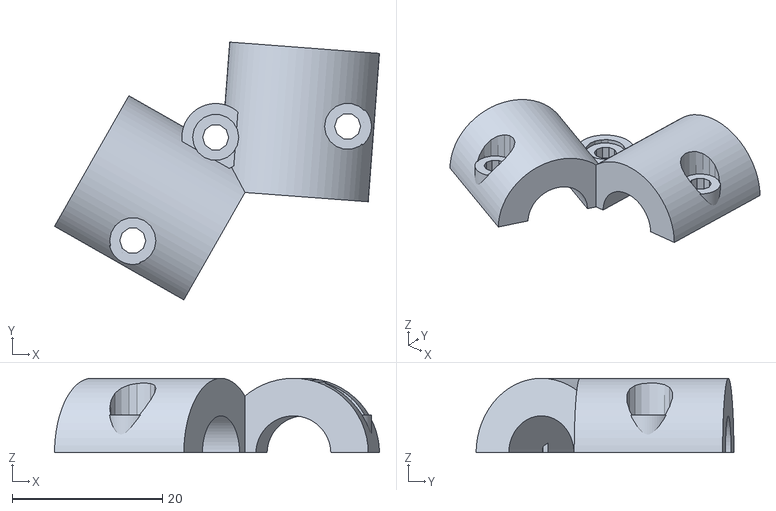
[picture p81: CAD file, 2021-05-01]
build/stls/bed_holderF1.stl
43.2 x 34.3 x 9.90
