SmoothieAq/cevo2/build/stls/bed_holderB2.stl

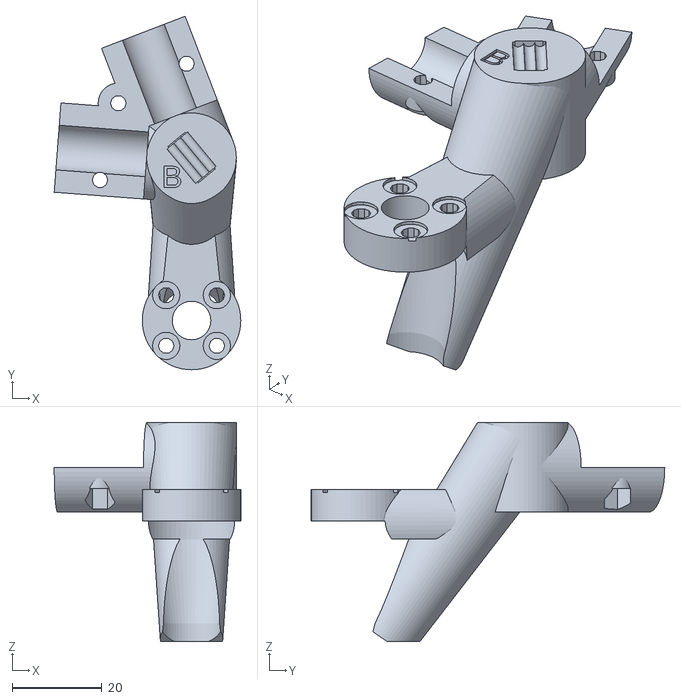
[picture p82: CAD file, 2021-05-01]
build/stls/bed_holderB2.stl
41.7 x 78.9 x 48.9
