SmoothieAq/cevo2/build/stls/bed_holderB1.stl

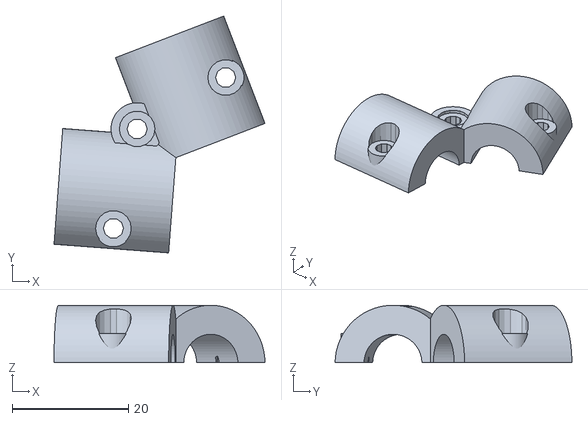
[picture p83: CAD file, 2021-05-01]
build/stls/bed_holderB1.stl
36.3 x 40.8 x 9.90
