SmoothieAq/cevo2/build/stls/carriage.stl

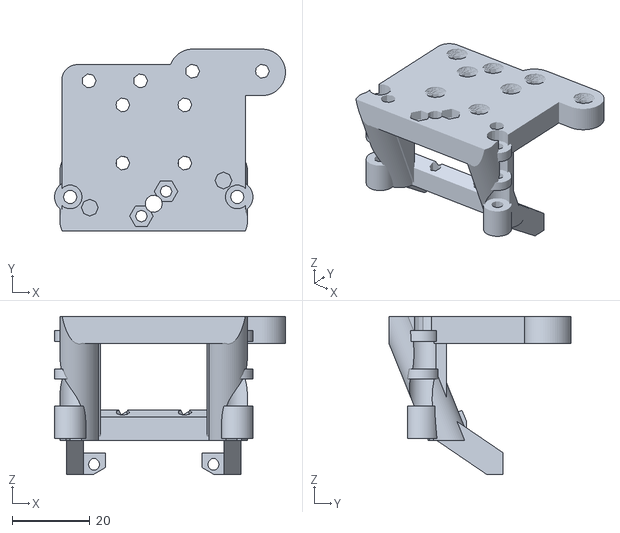
[picture p84: CAD file, 2021-05-01]
build/stls/carriage.stl
59.6 x 46.9 x 40.8
