SmoothieAq/cevo2/build/stls/rail_y_front_stop.stl

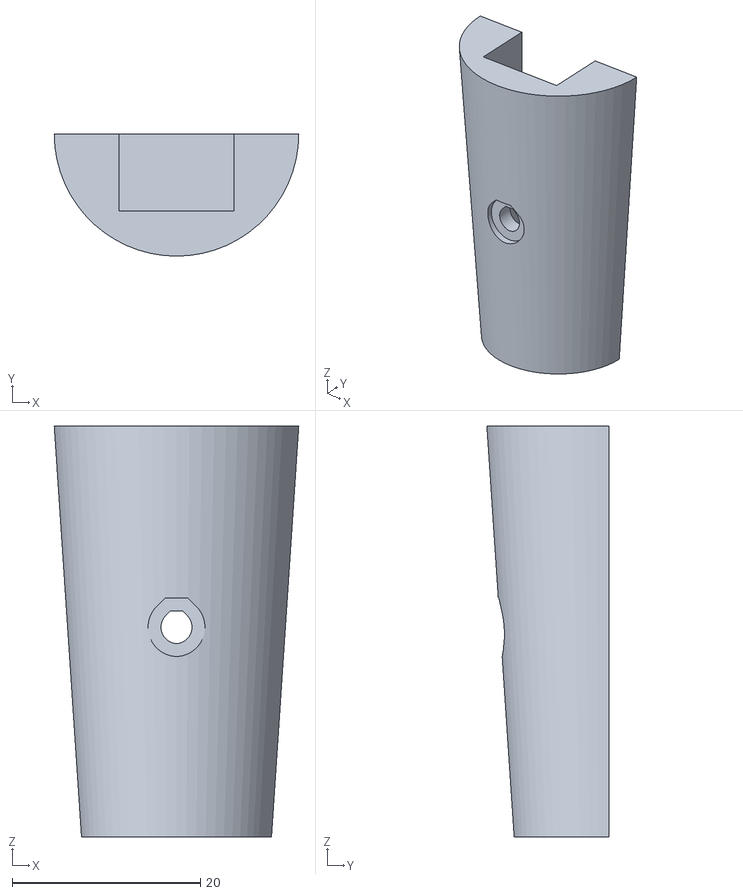
[picture p85: CAD file, 2021-05-01]
build/stls/rail_y_front_stop.stl
26.0 x 13.0 x 43.7
