SmoothieAq/cevo2/build/stls/bed_holderL1.stl

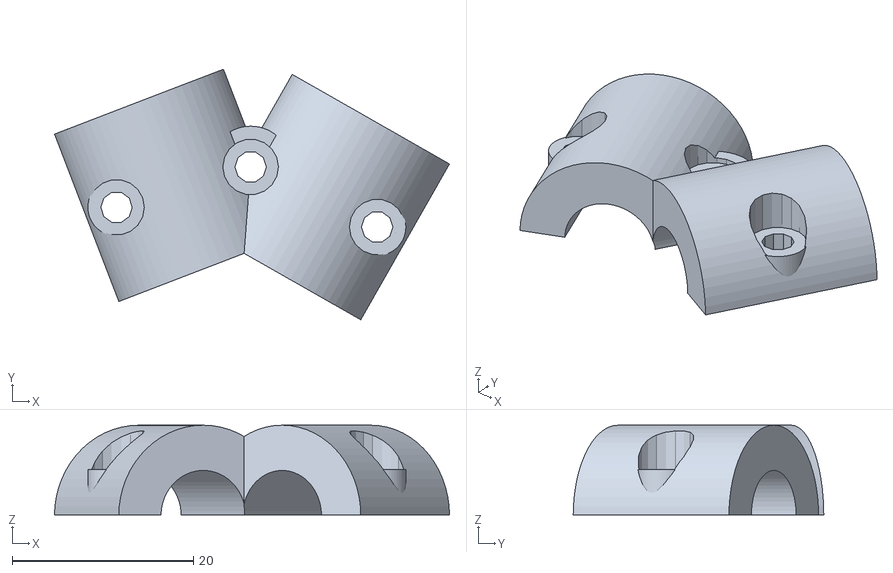
[picture p86: CAD file, 2021-05-01]
build/stls/bed_holderL1.stl
43.6 x 27.7 x 9.90
