SmoothieAq/cevo2/build/stls/fan_holder_at_carriage.stl

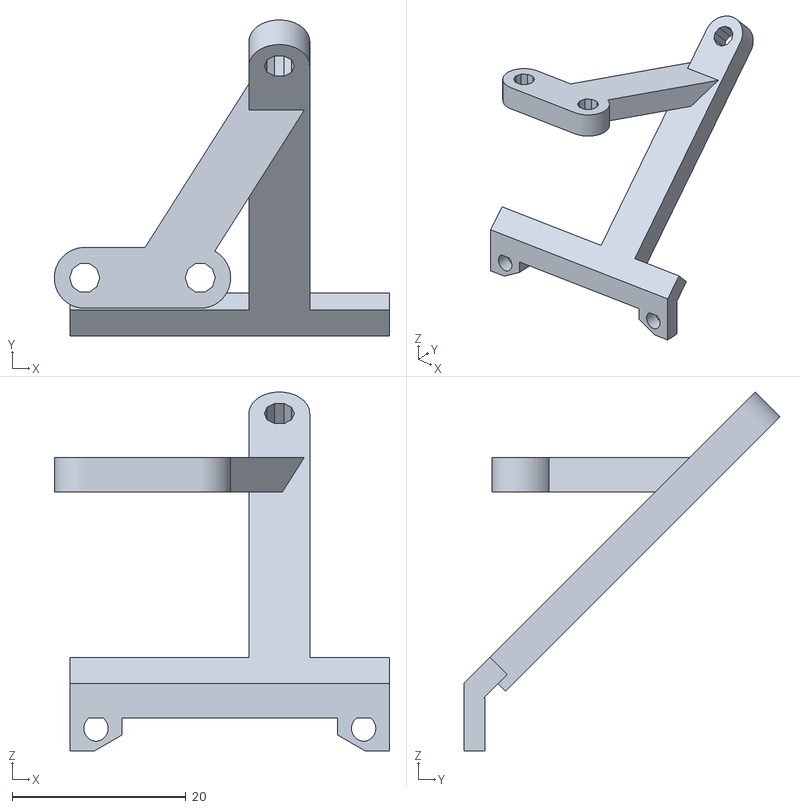
[picture p87: CAD file, 2021-04-05]
build/stls/fan_holder_at_carriage.stl
38.6 x 36.4 x 41.3
