SmoothieAq/cevo2/build/stls/mosquito_fan_duct.stl

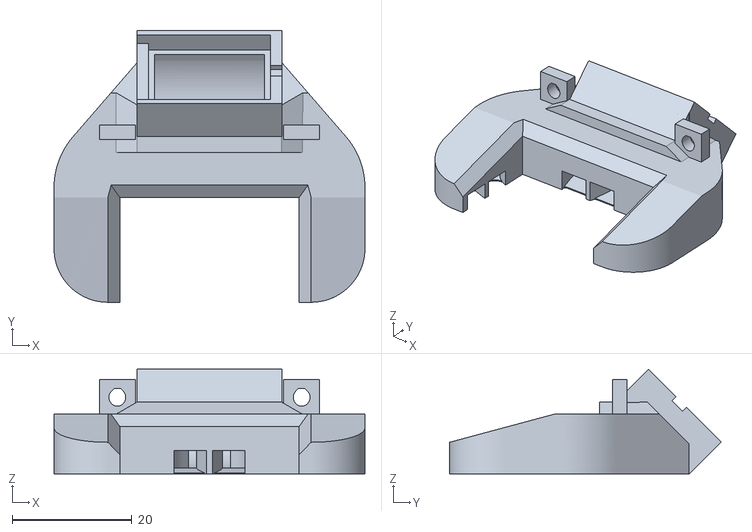
[picture p88: CAD file, 2021-03-22]
build/stls/mosquito_fan_duct.stl
52.0 x 45.4 x 17.5
