SmoothieAq/cevo2/build/stls/loops_motor_holderR.stl

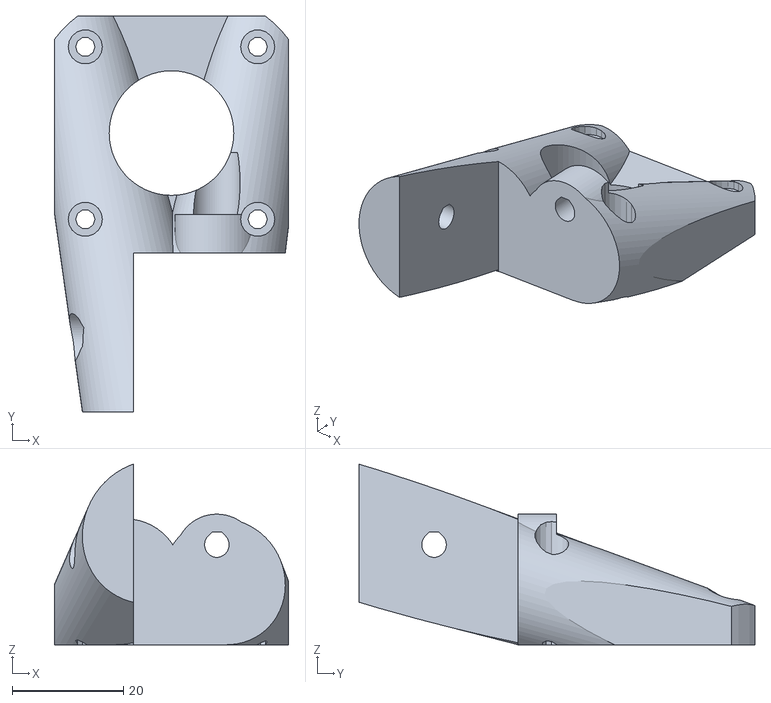
[picture p89: CAD file, 2021-03-22]
build/stls/loops_motor_holderR.stl
42.1 x 71.2 x 32.5
