SmoothieAq/cevo2/build/stls/leads_holder.stl

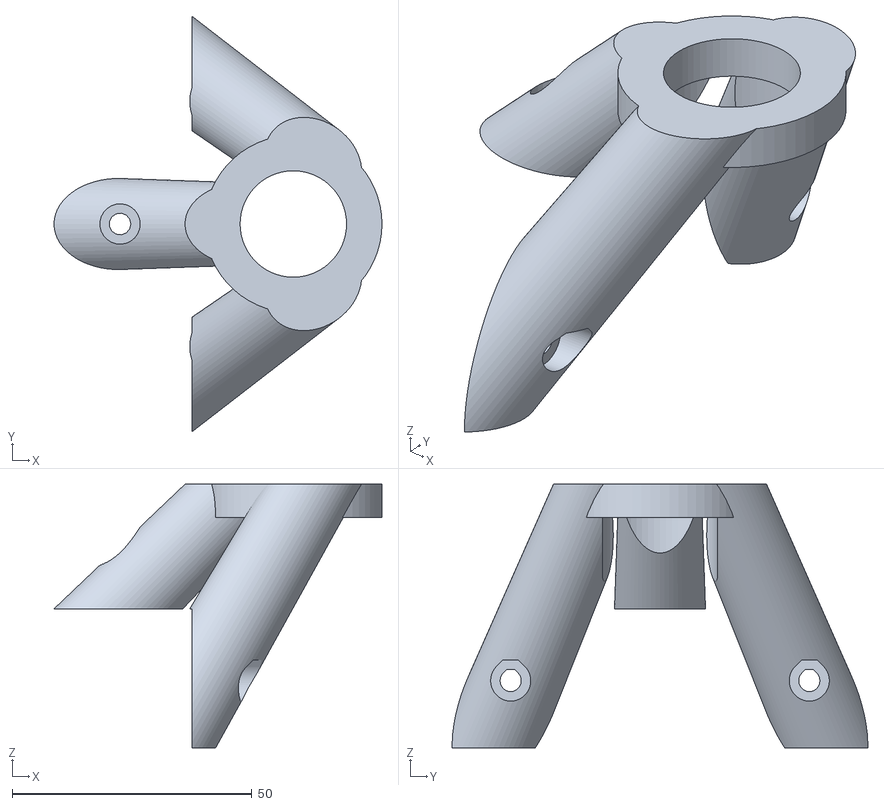
[picture p90: CAD file, 2021-03-22]
build/stls/leads_holder.stl
68.4 x 86.7 x 55.0
