SmoothieAq/cevo2/scad/cevo2.scad

$layer_height = 0.2;
$extrusion_width = 0.5;
$nozzle = 0.4;
include <../../xNopSCADlib/xxVitamins/xxDefaults.scad>
$show_threads=true;
//$show_lines=false;
//$explode = 1;
//$pose = undef;
//$posed=undef;
include <../../xNopSCADlib/xNopSCADlib/core.scad>
