SmoothieAq/cevo2/scad/target.scad

include <config_build.scad>
$target = "build";
$cwd="C:/Users/jesper/IdeaProjects/cevo2";
