SmoothieAq/cevo2/scad/assemblies/t.scad

include <../cevo2.scad>

include <NopSCADlib/vitamins/extrusion_brackets.scad>
include <../../../xNopSCADlib/xVitamins/xextrusion_bracket.scad>
include <../../../xNopSCADlib/xxVitamins/xxscrews.scad>
use <../../../xNopSCADlib/xVitamins/xextrusion_bracket3.scad>

xextrusion_bracket3(cut=1);
