SmoothieAq/cevo2/scad/parts/leads_holder.scad

include <../cevo2.scad>
include <../defs/leads_defs.scad>
include <NopSCADlib/vitamins/tubings.scad>
include <../../../xNopSCADlib/xxVitamins/xxscrews.scad>
use <util.scad>


mw = NEMA_width(leads_motor);
lbz = NEMA_shaft_length(leads_motor)[0]-frame_y_z2+frame_y_z1;

lead_bearing_holder_screws = [ for (i = [-1:1]) let(
	t = [i?-mw/2+base_part_thickx-1:-mw/2-extr_d2,i*(-mw/2-10),i?-extr_d2:base_part_thickx],
	r = i?[90,180,90]:[0,0,0],
	thick = i?base_part_thickx*2:base_part_thickx,
	horizontal = i != 0
) axxscrew_setLengAdjustDepth(screwFrameMount,thick=thick,t=t,r=r,spacing=20,horizontal=horizontal) ];

function lead_bearing_holder_screws() = lead_bearing_holder_screws;

module leads_holder_stl() { stl("leads_holder"); leads_holder(); }
module leads_holder() color(partColor) {
	difference() {
		union() {
			for (r = [1, -1])
				translate([-mw/2-3, r*(-mw/2-10), -extr_d2-3])
					holder_tube( h = holder_thick2 * 4.6, d1 = holder_thick2, d2 = holder_thick2 - 3, dz = holder_thick2,
						rx = r * -20, ry = 30, sh = extr_d2 + 3, sx = 18, nsd = 0, st = 1);
			translate([-mw/2-extr_d2, 0, 0])
				holder_tube( h = holder_thick2 * 3, d1 = holder_thick2, d2 = holder_thick2 - 3, dz = holder_thick2,
					ry = 45, sh = 0, sx = 20, nsd = 0, st = 1);
			translate([0,0,lbz-bb_width(lead_bearing)])
				cylinder(holder_thick1+10,d=bb_diameter(lead_bearing)+15);
			xxside1_plate(lead_bearing_holder_screws);
		}
		xxside1_hole(lead_bearing_holder_screws);
		translate([-extr_d-mw/2, -extr_d*4, -extr_d])
			cube([extr_d, extr_d*8, extr_d]);
		translate([-extr_d*2-mw/2+1, -extr_d*4, -extr_d])
			cube([extr_d, extr_d*8, extr_d]);
		translate([-extr_d*1.5, -extr_d*4, -extr_d*2+1])
			cube([extr_d*2, extr_d*8, extr_d]);
		translate([0,0,lbz-bb_width(lead_bearing)-1])
			cylinder(holder_thick1*2,d=bb_diameter(lead_bearing)+part_assemble_nudge*1);
		translate([0,0,lbz-1.5-part_assemble_nudge*1.5]) // todo 1.5
			cylinder(holder_thick1*2,d=25+part_assemble_nudge*3); // todo 25
		translate([0,0,lbz-bb_width(lead_bearing)+holder_thick1])
			cylinder(holder_thick1*4,d=bb_diameter(lead_bearing)*5);
		lnw = leadnut_flange_dia(leadnut)+motor_nudge*6;
		translate([0,0,lbz-bb_width(lead_bearing)-extr_d*2])
			cylinder(extr_d*2,d=lnw);
		translate([0,-lnw/2,lbz-bb_width(lead_bearing)-extr_d*2])
			cube([lnw,lnw,extr_d*2]);
	}
}

$preview=0;
leads_holder_stl();
