SmoothieAq/cevo2/scad/parts/x_holder.scad

include <../cevo2.scad>
include <../defs/loops_defs.scad>
include <../../../xNopSCADlib/xxVitamins/xxscrews.scad>

carriage_y = xrail_carriage(rail_y);
ch = carriage_height(carriage_y);
chc = ch-carriage_clearance(carriage_y);
cw = carriage_width(carriage_y);
cl = carriage_length(carriage_y);
cpx = carriage_pitch_x(carriage_y);
rh2 = rail_height(rail_y)/2;

ph = pulley_height(idler);
pod = pulley_od(idler);
iwt = washer_thickness(idler_washer);
bt = belt_thickness(belt);
bw = belt_width(belt);
bth = bt + 1;
bwh = ph + 2*iwt; //bw + 3;

zidlerholder = loops[1][0]-ph/2-iwt-base_part_thick;
didlerholder = cw/2+part_assemble_nudge;//max(cw/2+part_assemble_nudge,extr_d2+motor_nudge);
hidlerholder = frame_y_z3-didlerholder-zidlerholder;

yxbs = [ for (x = [extr_d2,extr_x_len+extr_d2]) [x,pos_y,frame_y_z3] ];

idlerps = [[loopshp(4),loopslp(8)],[loopshp(8),loopslp(4)]];

idlerScrews = [ for (i = [0:1]) let(
	screw = axxscrew_setLengAdjustDepth(screwPart,thick=hidlerholder,nut_depth=1.2,nut_plate=0,plate=0,twist=30),
	pss = [ for (p = idlerps[i]) [p.x,p.y,zidlerholder] ]
) [ for (p = pss) axxscrew(screw,t=p,r=[180,0,0]) ] ];
function x_holder_idler_screws(i) = idlerScrews[i];

carriageScrews = [ for (i = [0:1]) let(
	t1 = 5,
	t2 = 7.5,
	cps = carriage_hole_ps(carriage_y),
	pss = [ for(j = [0:3])  let (p = cps[j]) [(i?-1:1)*(p.z+((j%2)?t1:t2-1)),p.x-cpx/2,p.y]+yxbs[i] ],
	r = [90,0,90+i*180]
) [ for (j = [0:3]) axxscrew_setLeng(screwPart,t=pss[j],r=r,thick=((j%2)?t1:t2-1)+5,xnut=false,horizontal=true) ] ];
function x_holder_carriage_screws(i) = carriageScrews[i];

holderScrews = [ for (i = [0:1]) let(
	thick = rh2*2+10,
	t = yxbs[i]+[(i?-1:1)*(-xrail_xoff+rail_hole_ps(rail_x)[0]),0,- xrail_zoff + rh2 - thick/2]
//) [axxscrew_setLengAdjustDepth(screwPart,thick=thick,t=t,r=[180,0,33])] ];
) [axxscrew_setLeng(screwPart,thick=thick,t=t,r=[180,0,33],depth=0,nut_depth=0,nut_spacing=0.5,twist=30)] ];
function x_holder_screws(i) = holderScrews[i];

function holderScrewsw(i) = let (s = holderScrews[i][0]) [ for (d = [-0.5,0,0.5]) axxscrew(s,t=xxscrew_translate(s)+[d,0,0]) ];

xholderScrews = [ for (i = [0:1]) concat( idlerScrews[i], carriageScrews[i], holderScrewsw(i)) ];

module idler_idler(i) {
	module w() translate([0,0,ph/2]) explode([0,0,ph/4]) xwasher(idler_washer);
	for (p = idlerps[i])
	translate(p) {
		w();
		pulley_assembly(idler);
		rotate([180,0,0]) w();
	}
}

module x_holderL1_stl() stl("x_holderL1") x_holder1(0);
module x_holderL2_stl() stl("x_holderL2") x_holder2(0);
module x_holderR1_stl() stl("x_holderR1") x_holder1(1);
module x_holderR2_stl() stl("x_holderR2") x_holder2(1);

function cut(i,zd) = [ch + part_assemble_nudge-(i*2+1)*xyholder_thick2,-cl/2-cpx/2-3,(idlerps[i][(i+1)%2]-yxbs[i]).z+ph/2+iwt+zd];

idler_holderpd = base_part_thick2-7;
module x_holder_cut(i,zd) {
	p = idlerps[i][1];
	translate([p.x-base_part_thick2*2,p.y-base_part_thick2*2,min(p.z+ph/2+iwt, frame_y_z3-extr_d2-idler_holderpd)-0.9+zd])
		cube([base_part_thick2*4,base_part_thick2*4,base_part_thick2*3]);

}

module x_holder1(i) {
	xxpart1(xholderScrews[i],partColor,noscrew=true)
		difference() {
			tr(yxbs[i]) x_holder(i);
			x_holder_cut(i,-base_part_thick2*3+part_assemble_line);
		}
}
module x_holder2(i) {
	xxpart2(xholderScrews[i],partColor,noscrew=true)
		difference() {
			tr(yxbs[i]) x_holder(i);
			x_holder_cut(i,0);
		}
}


module x_holder(i) {
	y1xb = yxbs[i];
	difference() {
		union() {
			mirror([i,0,0]) {
				translate([ch + part_assemble_nudge, 0, - xrail_zoff + rh2]) // x_rail holder
					difference() {
						rotate([0, 90, 0])
							translate([0, 0, - chc])
								cylinder(xyholder_thick2 + chc, d = rail_width(rail_x) + 10);
						translate([-1-chc,-xyholder_thick2,rh2+5])
							cube([xyholder_thick2*2, xyholder_thick2*2, xyholder_thick2]);
						translate([-1-chc,-xyholder_thick2,-xyholder_thick2-rh2-5])
							cube([xyholder_thick2*2, xyholder_thick2*2, xyholder_thick2]);
					}
				translate([idler_tubed/2.7,-idler_tubed/4, -hidlerholder-didlerholder]) // extra strength
					cylinder(hidlerholder/3, d = idler_tubed/1.7);
				difference() {
					union() { // y_carriage holders
						x = ch + part_assemble_nudge - 3;
						yo = 3;
						z = - xrail_zoff + rh2 + 2-4;
						h = xrail_zoff - rh2 + cw / 2+3;
						d1 = xyholder_thick2 + 4;
						d2 = xyholder_thick2 * 0.6;
						translate([x, - yo, z])
							rotate([- 5, 5, 0])
								cylinder(h, d1 = d1, d2 = d2);
						translate([x, - cpx + yo, z])
							rotate([5, 5, 0])
								cylinder(h, d1 = d1, d2 = d2);
					}
					translate([0, - cl / 2 - cpx / 2 - 3, cw / 2 - part_assemble_nudge])
						cube([xyholder_thick2 * 2, cl, xyholder_thick2]); // cut top
					translate([0,- cpx / 2 - cl/2 +0.6, - xyholder_thick2 - frame_y_z3 + loops[0][0] + bwh/2])
						cube([xyholder_thick2 * 2, cl/2, xyholder_thick2]); // cut buttom front
					translate([0, - cl / 2 - cpx / 2 - 3, - xyholder_thick2 - frame_y_z3 + loops[0][0] + bwh/2*-1+0.5])
						cube([xyholder_thick2 * 2, cl, xyholder_thick2]); // cut buttom back
					translate([- xyholder_thick2 * 2 + part_assemble_nudge + ch, - cl / 2 - cpx / 2 - 3, -didlerholder])
						cube([xyholder_thick2 * 2, cl, cw + 2]); // cut for y_carriage
					translate([- xyholder_thick2 * 2 + part_assemble_nudge + carriage_clearance(carriage_y), - cl / 2 -
							cpx / 2 - 3, - cw * 2])
						cube([xyholder_thick2 * 2, cl, cw * 2]); // cut back
				}
			}
			for (l = idlerps[i]) { // idler holder
				p = l - y1xb;
				translate([p.x, p.y, -hidlerholder-didlerholder])
					cylinder(hidlerholder, d = idler_tubed);
			}
		}
		mirror([i,0,0]) {
			translate([ch-motor_nudge, -rail_width(rail_x)/2-part_assemble_nudge/2, part_assemble_nudge/2-xrail_zoff])
				cube([xyholder_thick2*2, rail_width(rail_x)+part_assemble_nudge, rail_height(rail_x)+part_support_nudge-part_assemble_nudge]); // hole for x_rail
			translate([-extr_d+motor_nudge,-cl,-extr_d2-motor_nudge])
				cube([extr_d,cl*2,extr_d]); // space for extrution
		}
		for (j = [0:1]) {
			p = idlerps[i][j] - y1xb;
			translate(p) {
				phx = part_support_nudge; // extra high hole, because supporters make the surface uneven
				translate([0, 0, - ph / 2 - iwt - phx/2])
					cylinder(ph + 2 * iwt + phx, d = idler_tubehd); // hole for idler
				translate([i?-xyholder_thick2:0, (j?i?1:- 1:i?-1:1) * idler_tubehd/2 + (j?i?-1:0:i?0:-1)*idler_tubebth, -idler_tubebwh / 2])
					cube([xyholder_thick2, idler_tubebth, idler_tubebwh]); // hole for belt into idler
				translate([(i?1:-1)*idler_tubehd/2+(i?-1:0)*idler_tubebth, (j?i?-1:0:i?0:-1)*xyholder_thick2, -idler_tubebwh / 2])
					cube([idler_tubebth, xyholder_thick2, idler_tubebwh]); // hole for belt into idler
			}
		}
	}
}


rail_y_stop_screw = axscrew(rail_screw(rail_y), l = 16, material = MaterialBlackSteel);

use <loops_motor_holder.scad>
rail_y_front_stop_screws = [axxscrew(rail_y_stop_screw,t=[0,yrail_yoff-extr_d2+rail_pitch(rail_y)/2,carriage_height(carriage_y)-2],horizontal=true)];
function rail_y_front_stop_screws() = rail_y_front_stop_screws;
module rail_y_front_stop_stl() stl("rail_y_front_stop") color(partColor) {
	//xd = cpx/2 + (rail_width(rail_x) + 10)/2 - cl/2;
	xd = pos_y - idlerps[0][0].y - cl/2;
	l = loops_motor_holder_max_xd() + xd + 2;
	rotate([90,0,0]) difference() {
		d = extr_d-4;
		translate([0,l,0])
			rotate([90, 0, 0])
				translate([0, carriage_height(carriage_y)-d/2, 0])
					cylinder(l-part_assemble_nudge, d1 = d, d2=d-5);
		translate([-extr_d,-1,-extr_d])
			cube([extr_d*2,l+2,extr_d]);
		translate([-rail_width(rail_y)/2-part_assemble_nudge/2,yrail_yoff-extr_d2-3,-1])
			cube([rail_width(rail_y)+part_assemble_nudge, l+2, rail_height(rail_y)+part_support_nudge-part_assemble_nudge+1]); // hole for y_rail
		xxside1_hole(rail_y_front_stop_screws);
	}
}


use <idler_holder.scad>
rail_y_back_stop_screws = [axxscrew(rail_y_stop_screw,t=[0,-rail_pitch(rail_y)/2+motor_nudge,carriage_height(carriage_y)-2],horizontal=180)];
function rail_y_back_stop_screws() = rail_y_back_stop_screws;
module rail_y_back_stop_stl() stl("rail_y_back_stop") color(partColor) {
	xd = cpx/2 + (rail_width(rail_x) + 10)/2 - cl/2;
	l = idler_holder_max_xd() + xd + 2;
	rotate([-90,0,0]) difference() {
		d = extr_d-4;
		rotate([90, 0, 0])
			translate([0, carriage_height(carriage_y)-d/2, 0])
				cylinder(l-part_assemble_nudge, d = d);
		translate([-extr_d,-l-1,-extr_d])
			cube([extr_d*2,l+2,extr_d]);
		translate([-rail_width(rail_y)/2-part_assemble_nudge/2,-l-1,-1])
			cube([rail_width(rail_y)+part_assemble_nudge, l+2, rail_height(rail_y)+part_support_nudge-part_assemble_nudge+1]); // hole for y_rail
		xxside1_hole(rail_y_back_stop_screws);
	}
}

rail_y_back_stop_stl();
//translate([0,0,15])x_holderL1_stl();
//x_holderL2_stl();
//translate([0,0,15])x_holderR1_stl();
//x_holderR2_stl();
//xxside1(idlerScrews[0]);
//xxside2(idlerScrews[0]);
