SmoothieAq/cevo2/scad/spacers/dremel_work_station_plate.scad

include <../cevo2.scad>
include <../defs/loops_defs.scad>

difference() {
	cube([50, 50, 28], center = true);
	cube([40, 40, 28.1], center = true);
}
