SmoothieAq/cevo2/scad/spacers/plate_yrail.scad

include <../cevo2.scad>
include <../defs/loops_defs.scad>

	cube([32,8,9.4]);
