SmoothieAq/cevo2/scad/spacers/spacer_z0_z1.scad

include <../cevo2.scad>
include <../defs/base_defs.scad>

cube([frame_y_z1-extr_d2,extr_d,10]);
