SmoothieAq/cevo2/scad/spacers/spacer_z2_z3.scad

include <../cevo2.scad>
include <../defs/base_defs.scad>

cube([frame_y_z3-frame_y_z2-extr_d,extr_d,10]);
