SmoothieAq/cevo2/(list of files, cad)

Other CAD files:
build/stls/x_holderL2.stl
build/stls/idler_holderL1.stl
build/stls/x_holderL1.stl
build/stls/loops_motor_holderL.stl
scad/assemblies/bed.scad
scad/assemblies/frame32_assembly.scad
scad/assemblies/frame33_assembly.scad
scad/assemblies/frame34_assembly.scad
scad/assemblies/frame40_assembly.scad
scad/assemblies/hotend_assembly.scad
scad/parts/bed_holder.scad
scad/old/frame34_assembly.scad
scad/old/frame3_assembly.scad
scad/old/hotend_assembly.scad
scad/old/leads.scad
scad/old/loops.scad
scad/old/x_assembly.scad
