SmoothieAq/cevo2/build/readme.md

# Cevo2
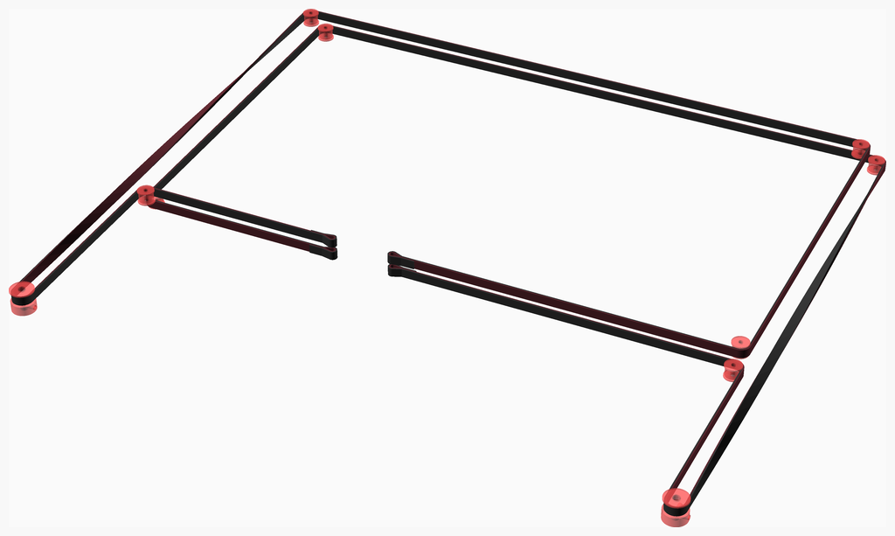
[picture p91: build/assemblies/frame40_assembled.png]
Main Assembly


<span></span>

---
## Table of Contents
1. [Parts list](#Parts_list)
1. [Carriage1 Assembly](#carriage1_assembly)
1. [Carriage2 Assembly](#carriage2_assembly)
1. [Loops Motor Holder Assembly](#loops_motor_holder_assembly)
1. [Idler Assembly](#idler_assembly)
1. [Bed1 Assembly](#bed1_assembly)
1. [Leads1 Assembly](#leads1_assembly)
1. [Leads2 Assembly](#leads2_assembly)
1. [Frame SideR Assembly](#frame_sideR_assembly)
1. [Frame SideL Assembly](#frame_sideL_assembly)
1. [Frame Assembly](#frame_assembly)
1. [Frame1 Assembly](#frame1_assembly)
1. [Frame2 Assembly](#frame2_assembly)
1. [Frame3 Assembly](#frame3_assembly)
1. [Frame10 Assembly](#frame10_assembly)
1. [Frame11 Assembly](#frame11_assembly)
1. [Frame20 Assembly](#frame20_assembly)
1. [Frame21 Assembly](#frame21_assembly)
1. [Frame22 Assembly](#frame22_assembly)
1. [Frame30 Assembly](#frame30_assembly)
1. [Frame31 Assembly](#frame31_assembly)
1. [Frame32 Assembly](#frame32_assembly)
1. [Frame33 Assembly](#frame33_assembly)
1. [Frame35 Assembly](#frame35_assembly)
1. [Frame40 Assembly](#frame40_assembly)

<span></span>
[Top](#TOP)

---

## Parts list
| <span style="writing-mode: vertical-rl; text-orientation: mixed;">Carriage1</span> | <span style="writing-mode: vertical-rl; text-orientation: mixed;">Carriage2</span> | <span style="writing-mode: vertical-rl; text-orientation: mixed;">Loops&nbsp;Motor&nbsp;Holder</span> | <span style="writing-mode: vertical-rl; text-orientation: mixed;">Idler</span> | <span style="writing-mode: vertical-rl; text-orientation: mixed;">Bed1</span> | <span style="writing-mode: vertical-rl; text-orientation: mixed;">Leads1</span> | <span style="writing-mode: vertical-rl; text-orientation: mixed;">Leads2</span> | <span style="writing-mode: vertical-rl; text-orientation: mixed;">Frame&nbsp;SideR</span> | <span style="writing-mode: vertical-rl; text-orientation: mixed;">Frame&nbsp;SideL</span> | <span style="writing-mode: vertical-rl; text-orientation: mixed;">Frame</span> | <span style="writing-mode: vertical-rl; text-orientation: mixed;">Frame1</span> | <span style="writing-mode: vertical-rl; text-orientation: mixed;">Frame2</span> | <span style="writing-mode: vertical-rl; text-orientation: mixed;">Frame3</span> | <span style="writing-mode: vertical-rl; text-orientation: mixed;">Frame10</span> | <span style="writing-mode: vertical-rl; text-orientation: mixed;">Frame11</span> | <span style="writing-mode: vertical-rl; text-orientation: mixed;">Frame20</span> | <span style="writing-mode: vertical-rl; text-orientation: mixed;">Frame21</span> | <span style="writing-mode: vertical-rl; text-orientation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
| &nbsp;&nbsp;.&nbsp; | &nbsp;&nbsp;.&nbsp; | &nbsp;&nbsp;.&nbsp; | &nbsp;&nbsp;.&nbsp; | &nbsp;&nbsp;.&nbsp; | &nbsp;&nbsp;.&nbsp; | &nbsp;&nbsp;.&nbsp; | &nbsp;&nbsp;.&nbsp; | &nbsp;&nbsp;.&nbsp; | &nbsp;&nbsp;.&nbsp; | &nbsp;&nbsp;.&nbsp; | &nbsp;&nbsp;.&nbsp; | &nbsp;&nbsp;.&nbsp; | &nbsp;&nbsp;.&nbsp; | &nbsp;&nbsp;.&nbsp; | &nbsp;&nbsp;.&nbsp; | &nbsp;&nbsp;.&nbsp; | &nbsp;&nbsp;1&nbsp; | &nbsp;&nbsp;.&nbsp; | &nbsp;&nbsp;.&nbsp; | &nbsp;&nbsp;.&nbsp; | &nbsp;&nbsp;.&nbsp; | &nbsp;&nbsp;.&nbsp; | &nbsp;&nbsp;.&nbsp; |  &nbsp;&nbsp;1&nbsp; | &nbsp;&nbsp;x_holderR2.stl |
| &nbsp;&nbsp;1&nbsp; | &nbsp;&nbsp;.&nbsp; | &nbsp;&nbsp;2&nbsp; | &nbsp;&nbsp;4&nbsp; | &nbsp;&nbsp;3&nbsp; | &nbsp;&nbsp;3&nbsp; | &nbsp;&nbsp;.&nbsp; | &nbsp;&nbsp;.&nbsp; | &nbsp;&nbsp;.&nbsp; | &nbsp;&nbsp;.&nbsp; | &nbsp;&nbsp;.&nbsp; | &nbsp;&nbsp;3&nbsp; | &nbsp;&nbsp;3&nbsp; | &nbsp;&nbsp;.&nbsp; | &nbsp;&nbsp;.&nbsp; | &nbsp;&nbsp;4&nbsp; | &nbsp;&nbsp;2&nbsp; | &nbsp;&nbsp;2&nbsp; | &nbsp;&nbsp;.&nbsp; | &nbsp;&nbsp;2&nbsp; | &nbsp;&nbsp;.&nbsp; | &nbsp;&nbsp;.&nbsp; | &nbsp;&nbsp;.&nbsp; | &nbsp;&nbsp;.&nbsp; | &nbsp;&nbsp;29&nbsp; | &nbsp;&nbsp;Total 3D printed parts count |

<span></span>
[Top](#TOP)

---

## Carriage1 Assembly
### Vitamins
|Qty|Description|
|---:|:---|
|1| Mosquito hotend|
|2| Nut M2.5 x 2.2mm |
|2| Screw M2.5 dome x 10mm|

### 3D Printed parts

| 1 x carriage.stl |
|---|
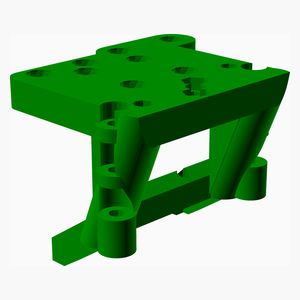
[picture p92: build/stls/carriage.png]
carriage.stl
|  

### Assembly instructions
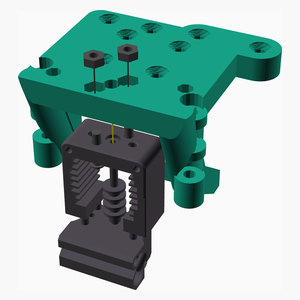
[picture p93: build/assemblies/carriage1_assembly_tn.png]
carriage1_assembly


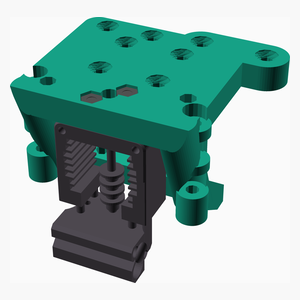
[picture p94: build/assemblies/carriage1_assembled_tn.png]
carriage1_assembled


<span></span>
[Top](#TOP)

---

## Carriage2 Assembly
### Vitamins
|Qty|Description|
|---:|:---|
|1| Fan 25.4mm x 10mm|
|2| Nut M2.5 x 2.2mm |
|2| Screw M2.5 cap x 30mm|

### Sub-assemblies

| 1 x carriage1_assembly |
|---|
| carriage1_assembled 

### Assembly instructions
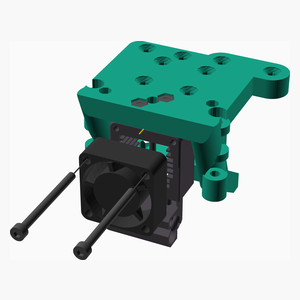
[picture p95: build/assemblies/carriage2_assembly_tn.png]
carriage2_assembly


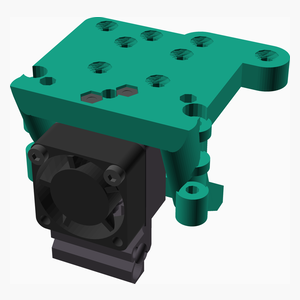
[picture p96: build/assemblies/carriage2_assembled_tn.png]
carriage2_assembled


<span></span>
[Top](#TOP)

---

## Loops Motor Holder Assembly
### Vitamins
|Qty|Description|
|---:|:---|
|2| Pulley GT2OB 20 teeth|
|4| Screw M3 cap x 11mm|
|4| Screw M3 cap x 14mm|
|4| Screw M3 grub x  6mm|
|2| Stepper motor NEMA17 x 40mm|

### 3D Printed parts

| 1 x loops_motor_holderL.stl | 1 x loops_motor_holderR.stl |
|---|---|
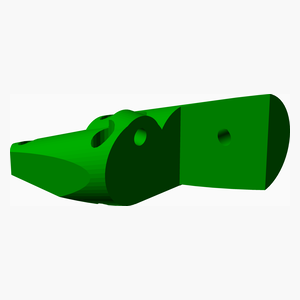
[picture p97: build/stls/loops_motor_holderL.png]
loops_motor_holderL.stl
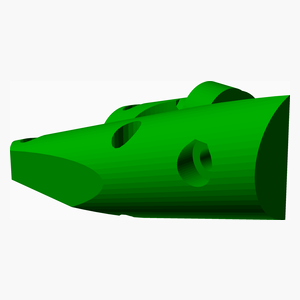
[picture p98: build/stls/loops_motor_holderR.png]
loops_motor_holderR.stl
|  |  

### Assembly instructions
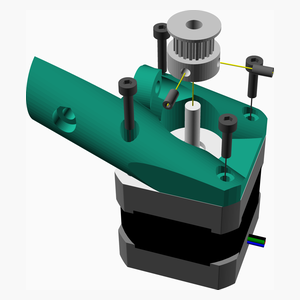
[picture p99: build/assemblies/loops_motor_holder_assembly_tn.png]
loops_motor_holder_assembly


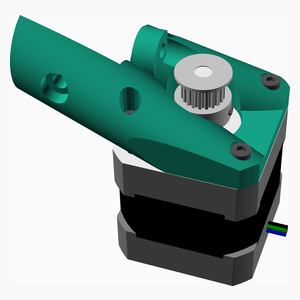
[picture p100: build/assemblies/loops_motor_holder_assembled_tn.png]
loops_motor_holder_assembled


<span></span>
[Top](#TOP)

---

## Idler Assembly
### Vitamins
|Qty|Description|
|---:|:---|
|4| Nut M3 x 2.4mm |
|4| Pulley GT2 (2 x F623ZZ flanged + washer 0.8) idler smooth 10mm|
|4| Screw M3 cap x 30mm|
|8| Washer  M3 x 6mm x 1mm|

### 3D Printed parts

| 1 x idler_holderL1.stl | 1 x idler_holderL2.stl | 1 x idler_holderR1.stl |
|---|---|---|
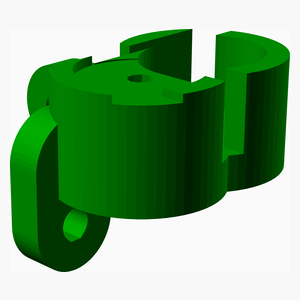
[picture p101: build/stls/idler_holderL1.png]
idler_holderL1.stl
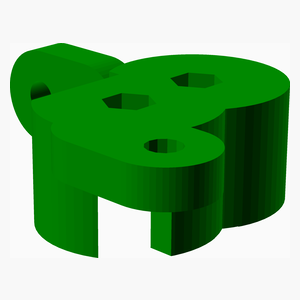
[picture p102: build/stls/idler_holderL2.png]
idler_holderL2.stl
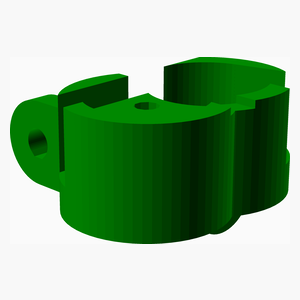
[picture p103: build/stls/idler_holderR1.png]
idler_holderR1.stl
|  |  |  

| 1 x idler_holderR2.stl |
|---|
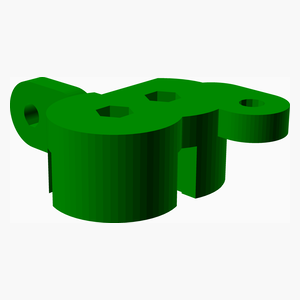
[picture p104: build/stls/idler_holderR2.png]
idler_holderR2.stl
|  

### Assembly instructions
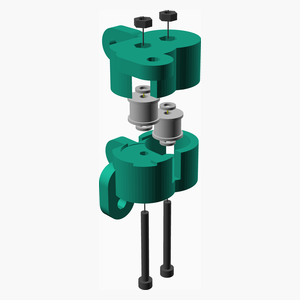
[picture p105: build/assemblies/idler_assembly_tn.png]
idler_assembly


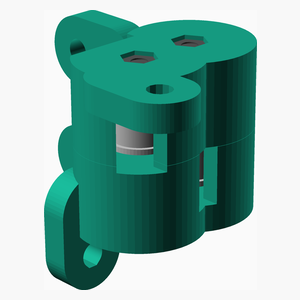
[picture p106: build/assemblies/idler_assembled_tn.png]
idler_assembled


<span></span>
[Top](#TOP)

---

## Bed1 Assembly
### Vitamins
|Qty|Description|
|---:|:---|
|3| Leadscrew nut 8 x 2|
|12| Nut M3 x 2.4mm |
|12| Screw M3 cap x 12mm|
|6| Smooth rod 2mm x 10mm|
|3| Spring 11.85mm OD, 0.8mm gauge x 37.8mm long, closed end|
|6| Washer  M2 x 5mm x 0.3mm|

### 3D Printed parts

| 1 x bed_holderB2.stl | 1 x bed_holderF2.stl | 1 x bed_holderL2.stl |
|---|---|---|
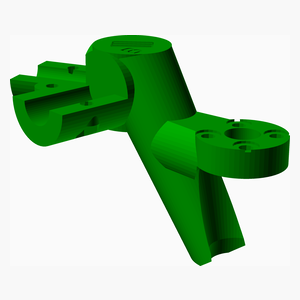
[picture p107: build/stls/bed_holderB2.png]
bed_holderB2.stl
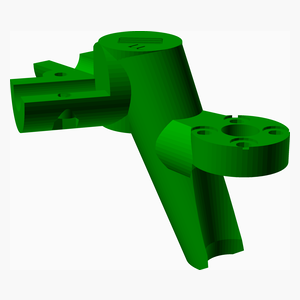
[picture p108: build/stls/bed_holderF2.png]
bed_holderF2.stl
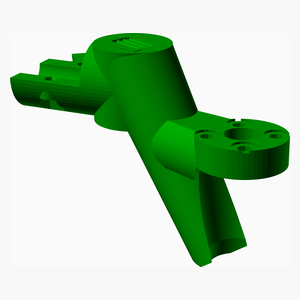
[picture p109: build/stls/bed_holderL2.png]
bed_holderL2.stl
|  |  |  

### Assembly instructions
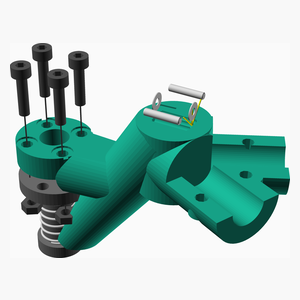
[picture p110: build/assemblies/bed1_assembly_tn.png]
bed1_assembly


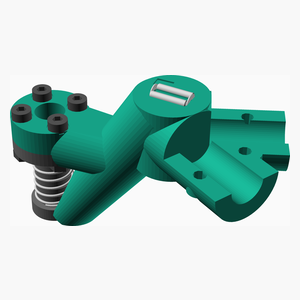
[picture p111: build/assemblies/bed1_assembled_tn.png]
bed1_assembled


<span></span>
[Top](#TOP)

---

## Leads1 Assembly
### Vitamins
|Qty|Description|
|---:|:---|
|12| Screw M3 cap x 12mm|
|3| Stepper motor NEMA17 x 47mm|

### 3D Printed parts

| 1 x leads_motor_holderB.stl | 1 x leads_motor_holderF.stl | 1 x leads_motor_holderL.stl |
|---|---|---|
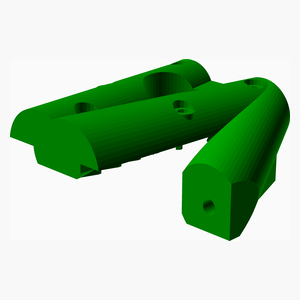
[picture p112: build/stls/leads_motor_holderB.png]
leads_motor_holderB.stl
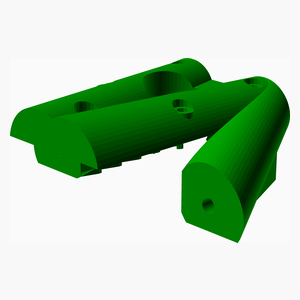
[picture p113: build/stls/leads_motor_holderL.png]
leads_motor_holderL.stl
|  | leads_motor_holderF.stl |  

### Assembly instructions
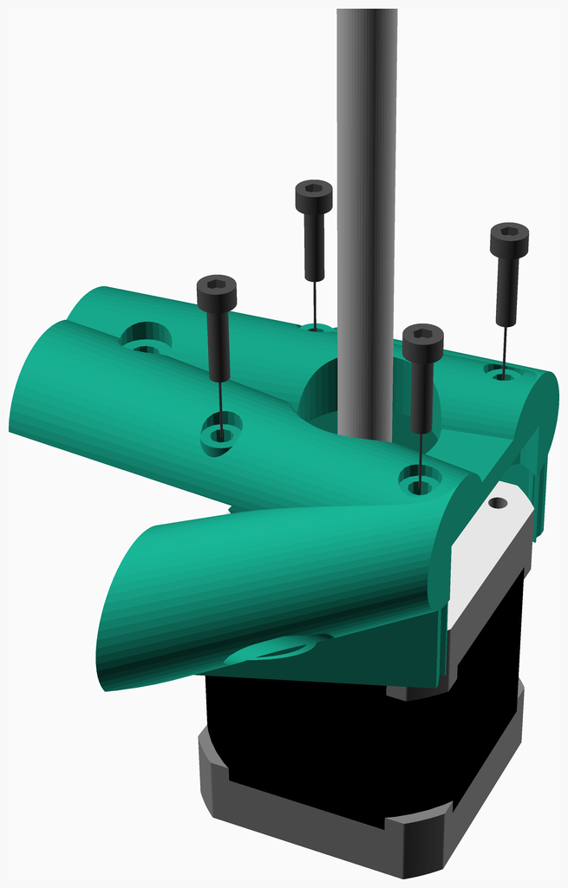
[picture p114: build/assemblies/leads1_assembly.png]
leads1_assembly


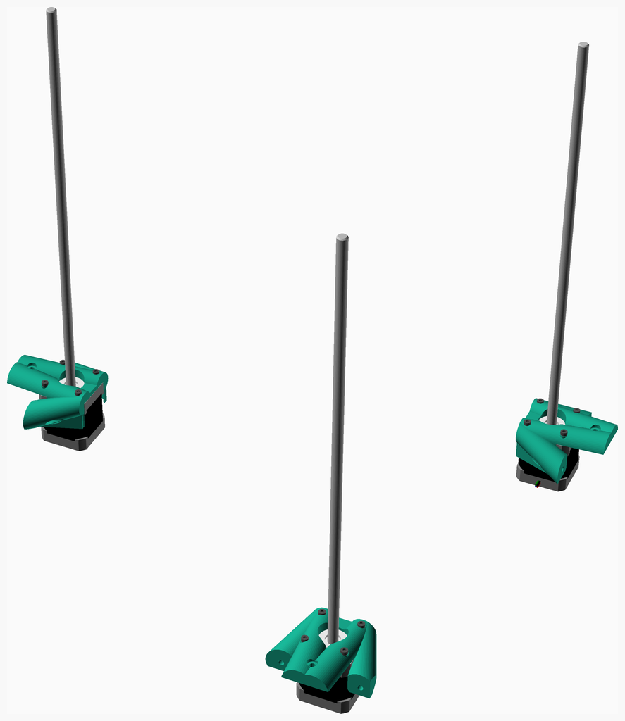
[picture p115: build/assemblies/leads1_assembled.png]
leads1_assembled


<span></span>
[Top](#TOP)

---

## Leads2 Assembly
### Sub-assemblies

| 1 x bed1_assembly | 1 x leads1_assembly |
|---|---|
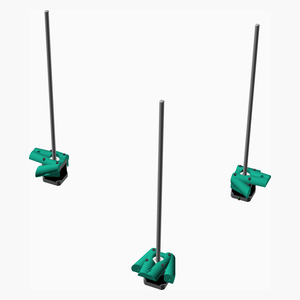
[picture p116: build/assemblies/leads1_assembled_tn.png]
leads1_assembled
| bed1_assembled |  

### Assembly instructions
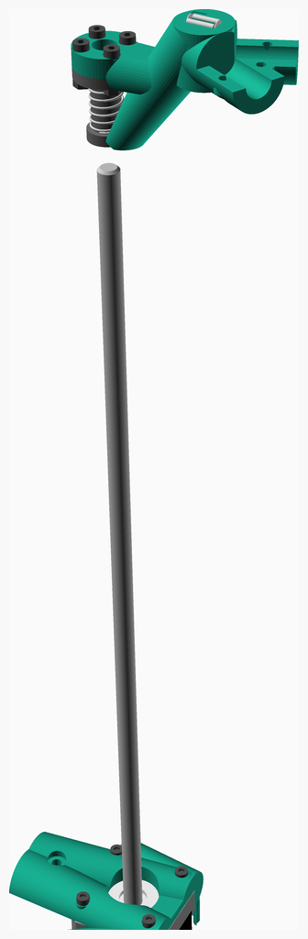
[picture p117: build/assemblies/leads2_assembly.png]
leads2_assembly


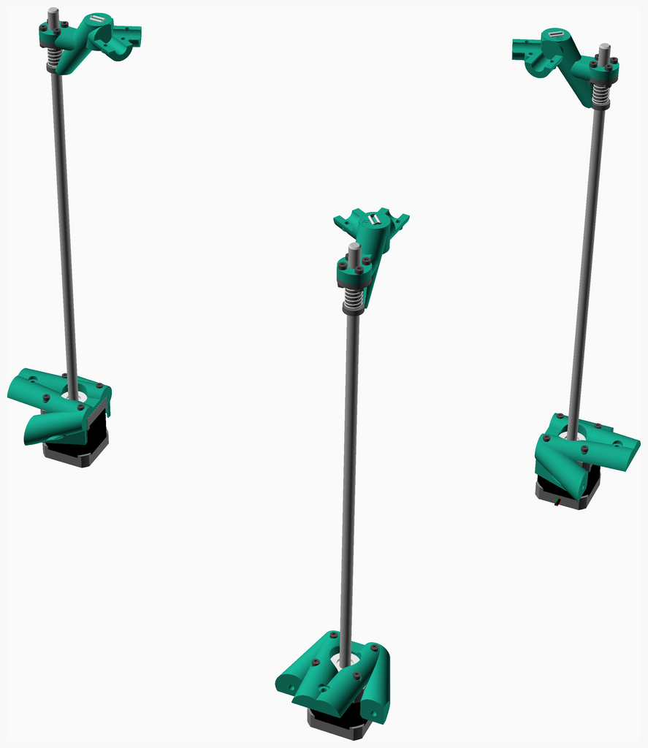
[picture p118: build/assemblies/leads2_assembled.png]
leads2_assembled


<span></span>
[Top](#TOP)

---

## Frame SideR Assembly
### Vitamins
|Qty|Description|
|---:|:---|
|3| Extrusion E3030 x 410mm|
|2| Extrusion E3030 x 600mm|
|4| Extrusion corner bracket 30|
|2| Extrusion inner corner bracket E30 M5|
|9| Nut M3 sliding T|
|17| Nut M4 sliding T|
|8| Screw M4 dome x  8mm|

### Assembly instructions
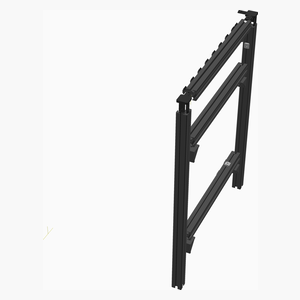
[picture p119: build/assemblies/frame_sideR_assembly_tn.png]
frame_sideR_assembly


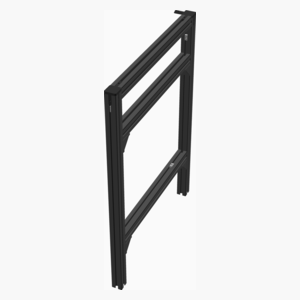
[picture p120: build/assemblies/frame_sideR_assembled_tn.png]
frame_sideR_assembled


<span></span>
[Top](#TOP)

---

## Frame SideL Assembly
### Vitamins
|Qty|Description|
|---:|:---|
|3| Extrusion E3030 x 410mm|
|2| Extrusion E3030 x 600mm|
|4| Extrusion corner bracket 30|
|2| Extrusion inner corner bracket E30 M5|
|9| Nut M3 sliding T|
|17| Nut M4 sliding T|
|8| Screw M4 dome x  8mm|

### Assembly instructions
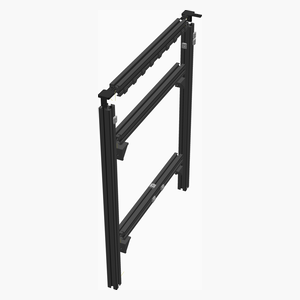
[picture p121: build/assemblies/frame_sideL_assembly_tn.png]
frame_sideL_assembly


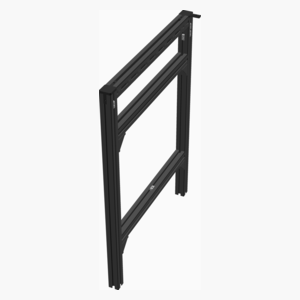
[picture p122: build/assemblies/frame_sideL_assembled_tn.png]
frame_sideL_assembled


<span></span>
[Top](#TOP)

---

## Frame Assembly
### Vitamins
|Qty|Description|
|---:|:---|
|4| Extrusion E3030 x 420mm|
|6| Extrusion corner bracket 30|
|15| Nut M4 sliding T|
|12| Screw M4 dome x  8mm|

### Sub-assemblies

| 1 x frame_sideL_assembly | 1 x frame_sideR_assembly |
|---|---|
| frame_sideL_assembled | frame_sideR_assembled 

### Assembly instructions
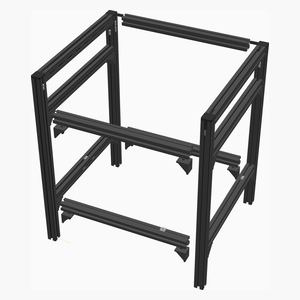
[picture p123: build/assemblies/frame_assembly_tn.png]
frame_assembly


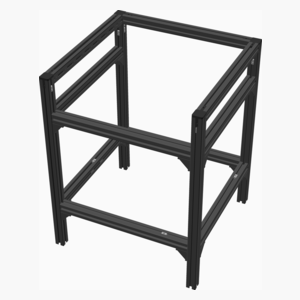
[picture p124: build/assemblies/frame_assembled_tn.png]
frame_assembled


<span></span>
[Top](#TOP)

---

## Frame1 Assembly
### Vitamins
|Qty|Description|
|---:|:---|
|9| Screw M4 dome x 12mm|

### Sub-assemblies

| 1 x frame_assembly | 1 x leads2_assembly |
|---|---|
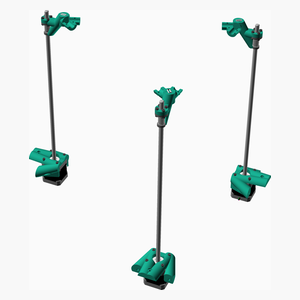
[picture p125: build/assemblies/leads2_assembled_tn.png]
leads2_assembled
| frame_assembled |  

### Assembly instructions
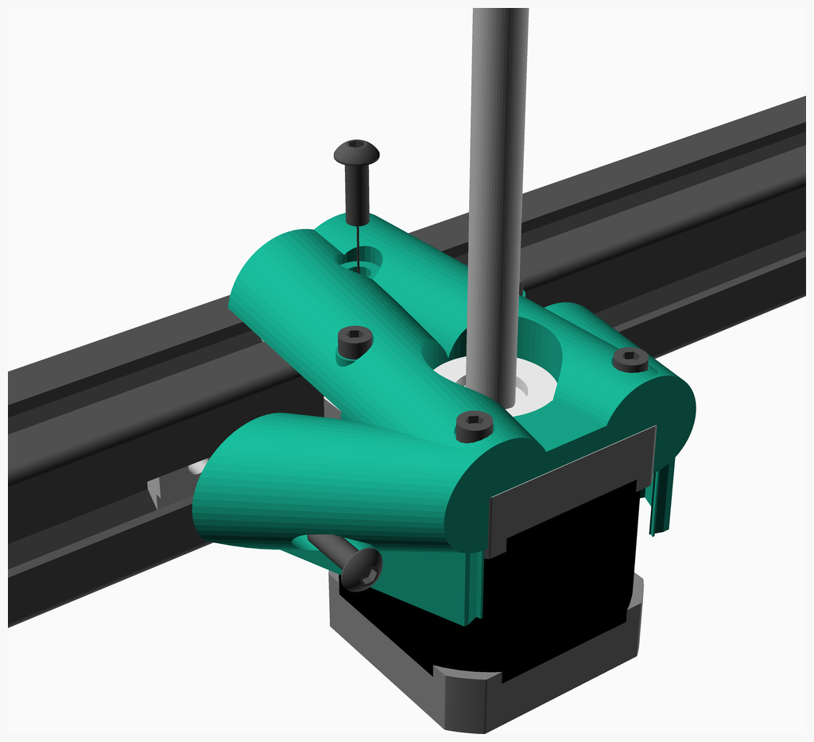
[picture p126: build/assemblies/frame1_assembly.png]
frame1_assembly


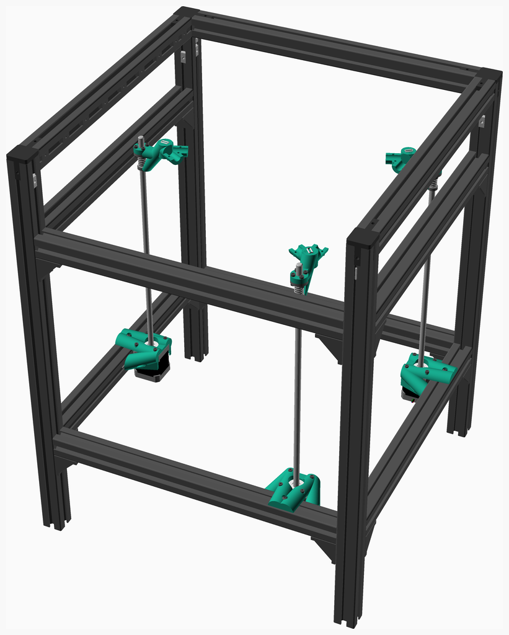
[picture p127: build/assemblies/frame1_assembled.png]
frame1_assembled


<span></span>
[Top](#TOP)

---

## Frame2 Assembly
### Vitamins
|Qty|Description|
|---:|:---|
|3| Ball bearing 608-2RS 8mm x 22mm x 7mm|
|9| Screw M4 dome x 12mm|

### 3D Printed parts

| 3 x leads_holder.stl |
|---|
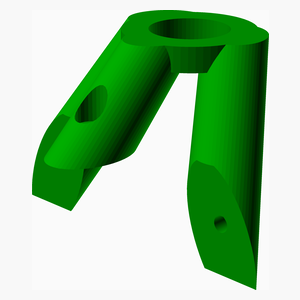
[picture p128: build/stls/leads_holder.png]
leads_holder.stl
|  

### Sub-assemblies

| 1 x frame1_assembly |
|---|
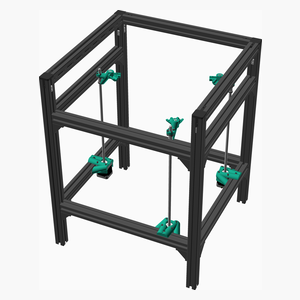
[picture p129: build/assemblies/frame1_assembled_tn.png]
frame1_assembled
|  

### Assembly instructions
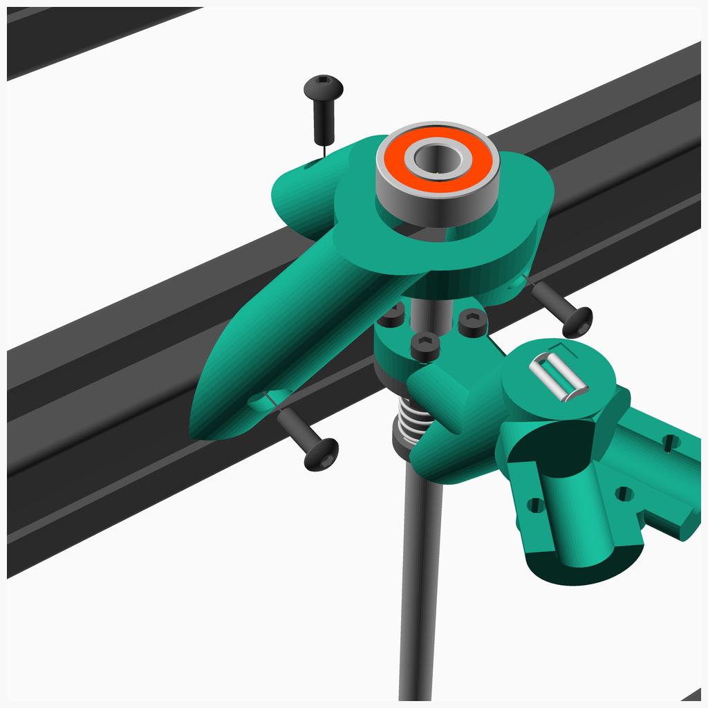
[picture p130: build/assemblies/frame2_assembly.png]
frame2_assembly


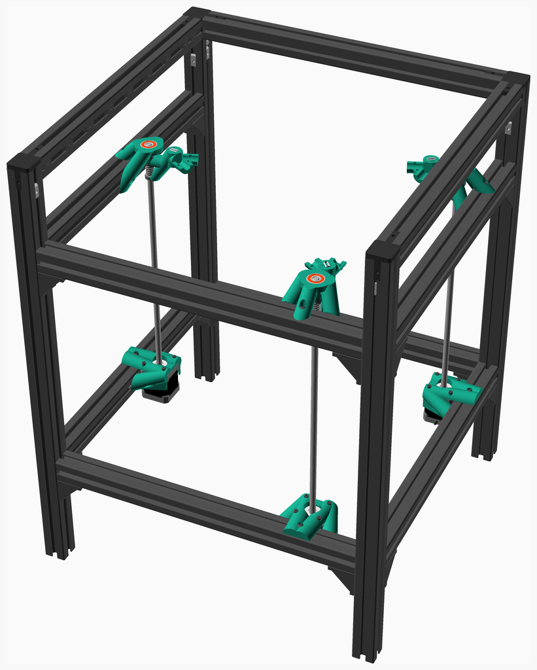
[picture p131: build/assemblies/frame2_assembled.png]
frame2_assembled


<span></span>
[Top](#TOP)

---

## Frame3 Assembly
### Vitamins
|Qty|Description|
|---:|:---|
|1| Carbon fiber OD 10mm ID 8mm x 257.792mm|
|2| Carbon fiber OD 10mm ID 8mm x 304.676mm|
|9| Nut M3 x 2.4mm |
|9| Screw M3 cap x 12mm|

### 3D Printed parts

| 1 x bed_holderB1.stl | 1 x bed_holderF1.stl | 1 x bed_holderL1.stl |
|---|---|---|
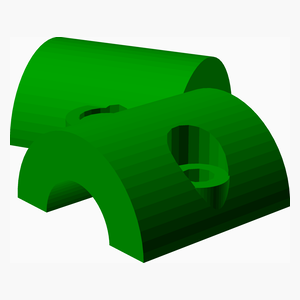
[picture p132: build/stls/bed_holderB1.png]
bed_holderB1.stl
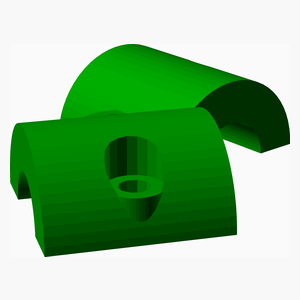
[picture p133: build/stls/bed_holderF1.png]
bed_holderF1.stl
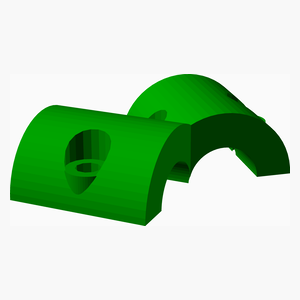
[picture p134: build/stls/bed_holderL1.png]
bed_holderL1.stl
|  |  |  

### Sub-assemblies

| 1 x frame2_assembly |
|---|
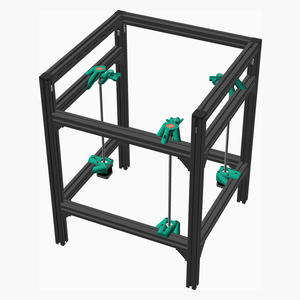
[picture p135: build/assemblies/frame2_assembled_tn.png]
frame2_assembled
|  

### Assembly instructions
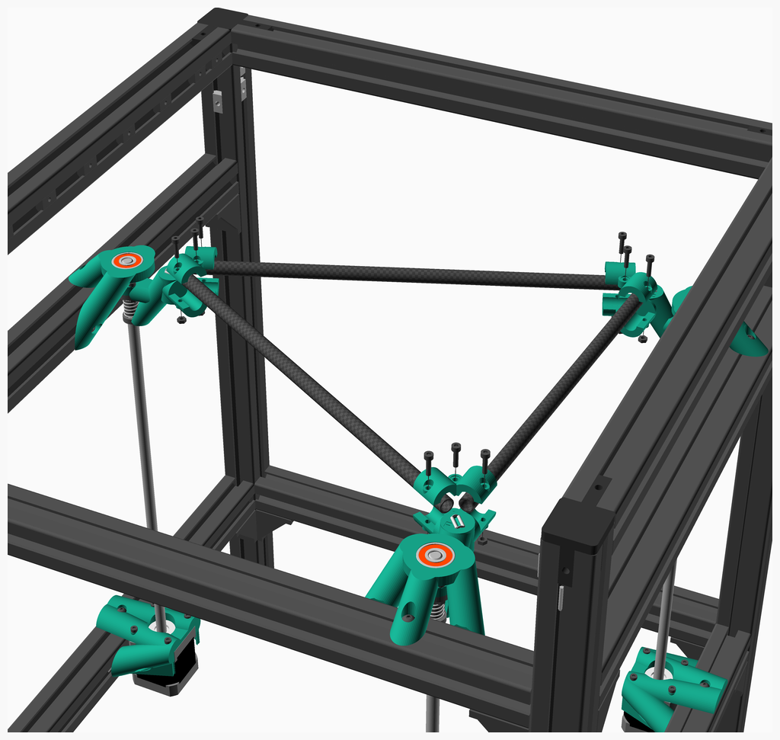
[picture p136: build/assemblies/frame3_assembly.png]
frame3_assembly


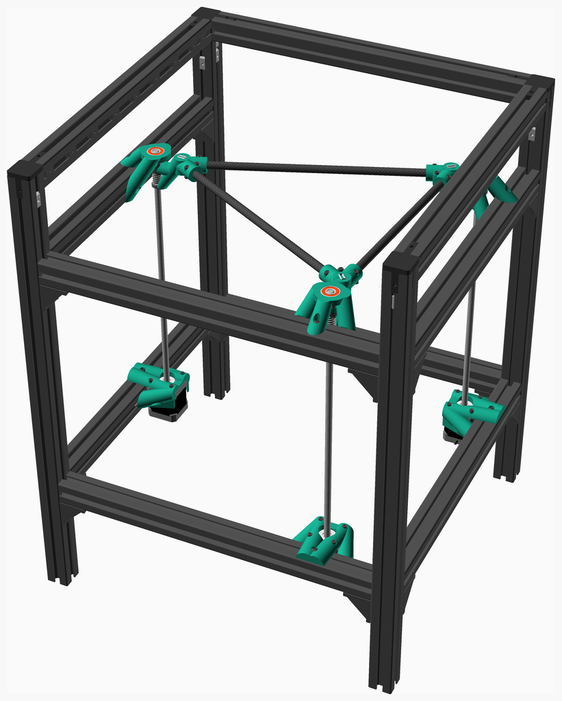
[picture p137: build/assemblies/frame3_assembled.png]
frame3_assembled


<span></span>
[Top](#TOP)

---

## Frame10 Assembly
### Vitamins
|Qty|Description|
|---:|:---|
|8| Screw M4 dome x  8mm|

### Sub-assemblies

| 1 x frame3_assembly | 1 x idler_assembly |
|---|---|
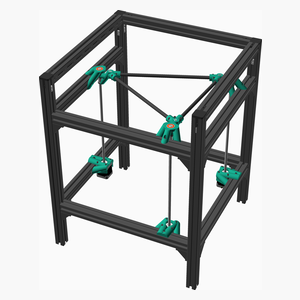
[picture p138: build/assemblies/frame3_assembled_tn.png]
frame3_assembled
|  | idler_assembled 

### Assembly instructions
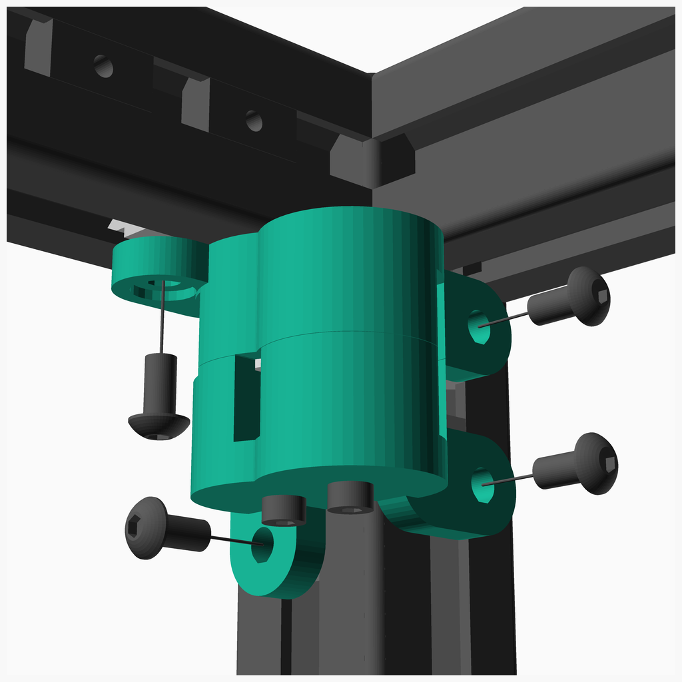
[picture p139: build/assemblies/frame10_assembly.png]
frame10_assembly


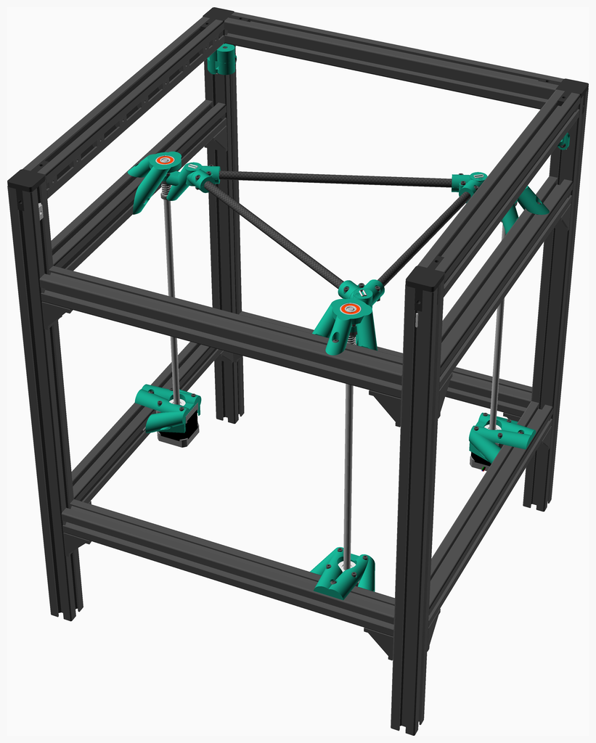
[picture p140: build/assemblies/frame10_assembled.png]
frame10_assembled


<span></span>
[Top](#TOP)

---

## Frame11 Assembly
### Vitamins
|Qty|Description|
|---:|:---|
|4| Screw M4 dome x 12mm|

### Sub-assemblies

| 1 x frame10_assembly | 1 x loops_motor_holder_assembly |
|---|---|
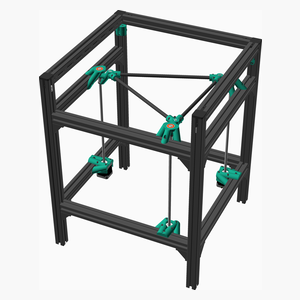
[picture p141: build/assemblies/frame10_assembled_tn.png]
frame10_assembled
|  | loops_motor_holder_assembled 

### Assembly instructions
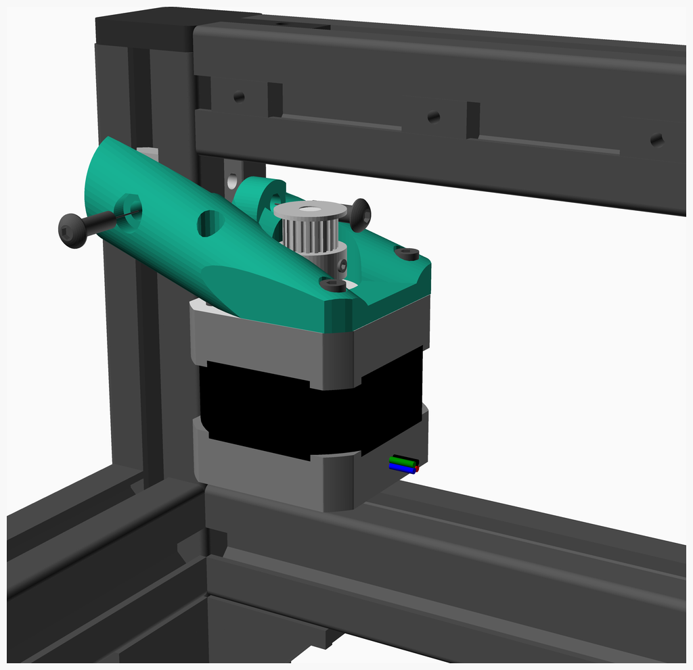
[picture p142: build/assemblies/frame11_assembly.png]
frame11_assembly


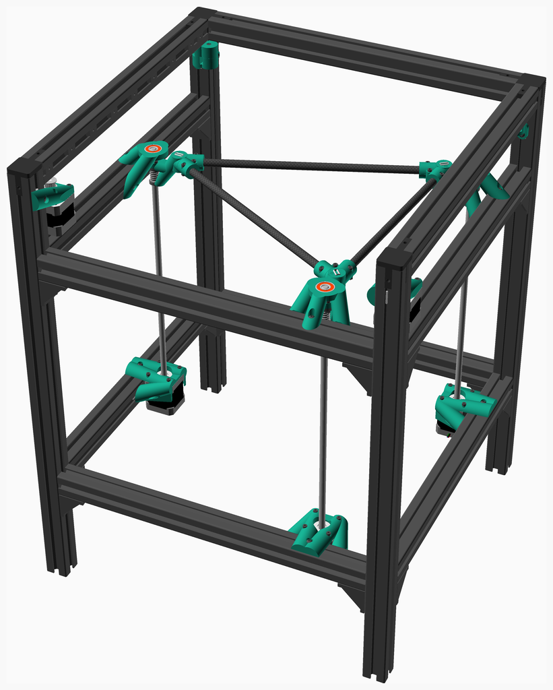
[picture p143: build/assemblies/frame11_assembled.png]
frame11_assembled


<span></span>
[Top](#TOP)

---

## Frame20 Assembly
### Vitamins
|Qty|Description|
|---:|:---|
|2| Linear rail MGN12 x 400mm|
|2| Linear rail carriage MGN12H|
|14| Screw M3 cap x 12mm|
|4| Screw M3 cap x 16mm|

### 3D Printed parts

| 2 x rail_y_back_stop.stl | 2 x rail_y_front_stop.stl |
|---|---|
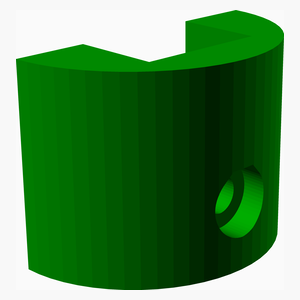
[picture p144: build/stls/rail_y_back_stop.png]
rail_y_back_stop.stl
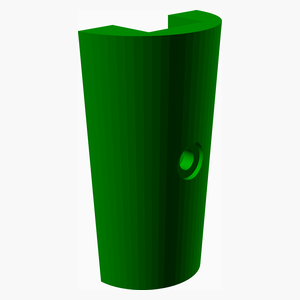
[picture p145: build/stls/rail_y_front_stop.png]
rail_y_front_stop.stl
|  |  

### Sub-assemblies

| 1 x frame11_assembly |
|---|
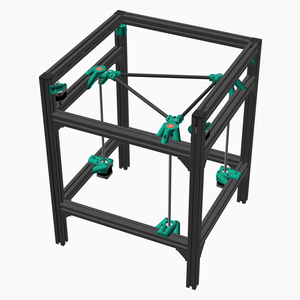
[picture p146: build/assemblies/frame11_assembled_tn.png]
frame11_assembled
|  

### Assembly instructions
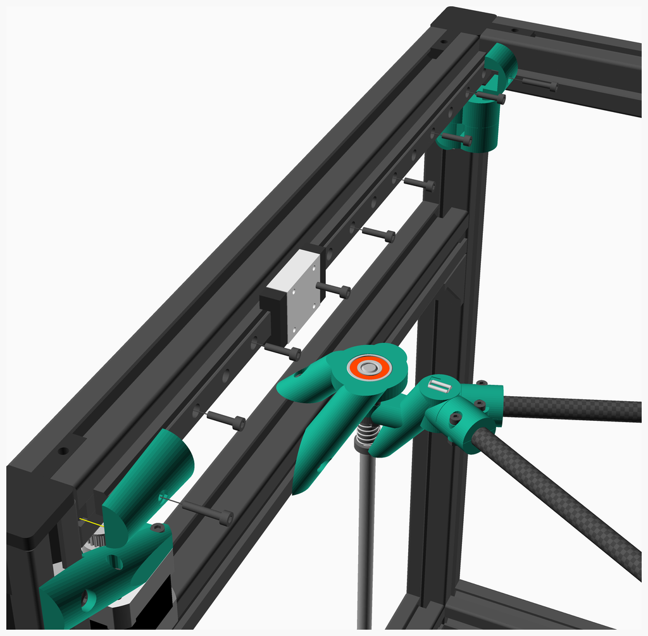
[picture p147: build/assemblies/frame20_assembly.png]
frame20_assembly


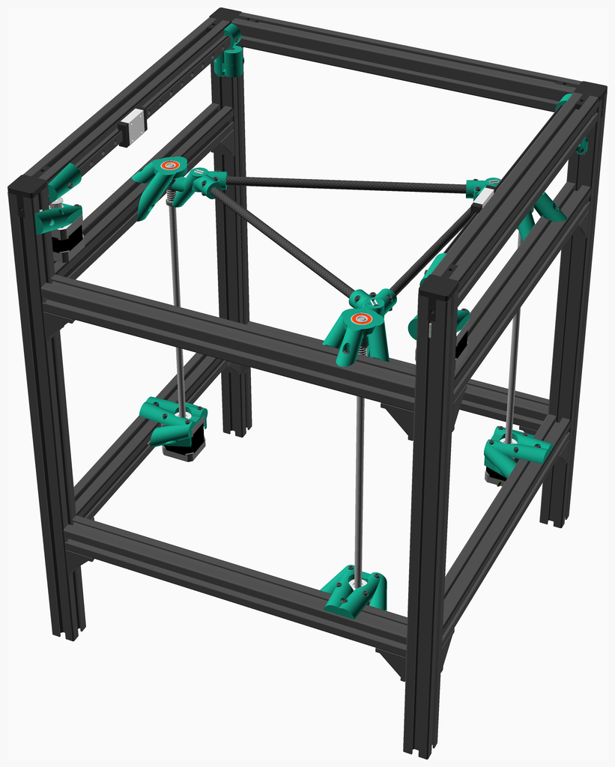
[picture p148: build/assemblies/frame20_assembled.png]
frame20_assembled


<span></span>
[Top](#TOP)

---

## Frame21 Assembly
### Vitamins
|Qty|Description|
|---:|:---|
|4| Nut M3 x 2.4mm |
|4| Screw M3 cap x 10mm|
|4| Screw M3 cap x 12mm|

### 3D Printed parts

| 1 x x_holderL1.stl | 1 x x_holderR1.stl |
|---|---|
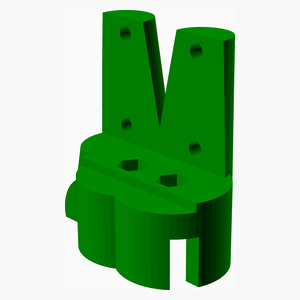
[picture p149: build/stls/x_holderL1.png]
x_holderL1.stl
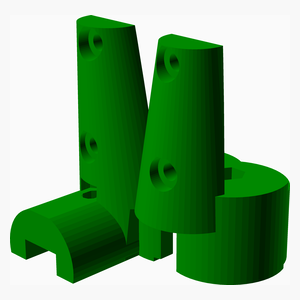
[picture p150: build/stls/x_holderR1.png]
x_holderR1.stl
|  |  

### Sub-assemblies

| 1 x frame20_assembly |
|---|
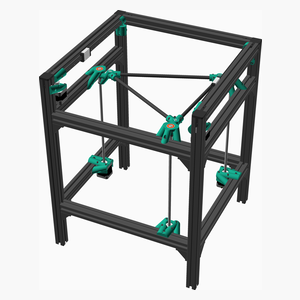
[picture p151: build/assemblies/frame20_assembled_tn.png]
frame20_assembled
|  

### Assembly instructions
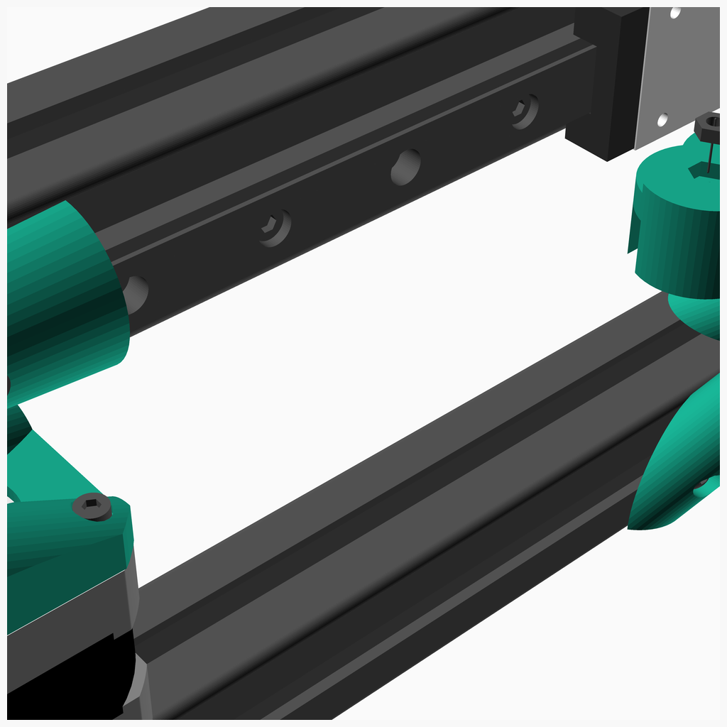
[picture p152: build/assemblies/frame21_assembly.png]
frame21_assembly


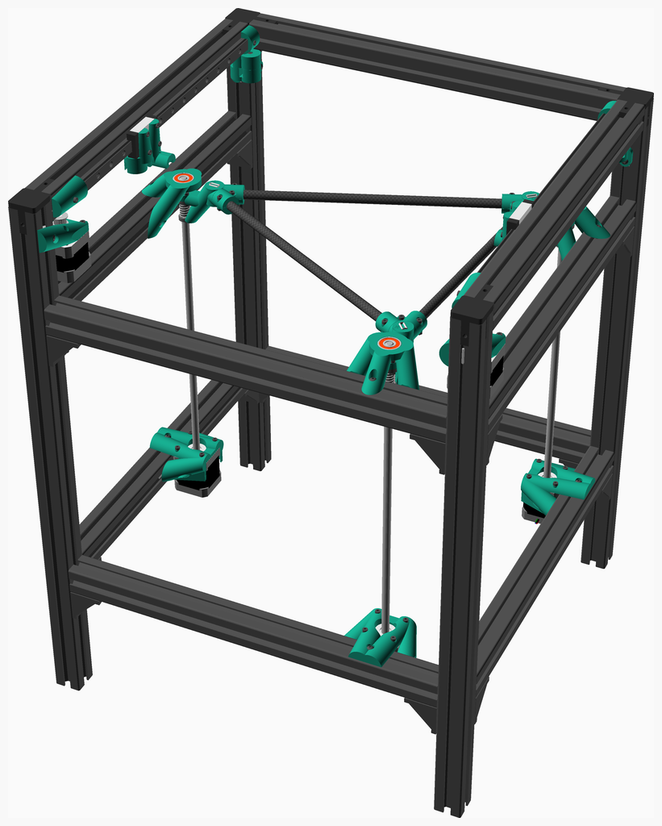
[picture p153: build/assemblies/frame21_assembled.png]
frame21_assembled


<span></span>
[Top](#TOP)

---

## Frame22 Assembly
### Vitamins
|Qty|Description|
|---:|:---|
|1| Linear rail MGN9 x 400mm|
|1| Linear rail carriage MGN9H|
|2| Nut M3 x 2.4mm |
|4| Pulley GT2 (2 x F623ZZ flanged + washer 0.8) idler smooth 10mm|
|2| Screw M3 cap x 20mm|
|4| Screw M3 cap x 30mm|
|8| Washer  M3 x 6mm x 1mm|

### 3D Printed parts

| 1 x x_holderL2.stl | 1 x x_holderR2.stl |
|---|---|
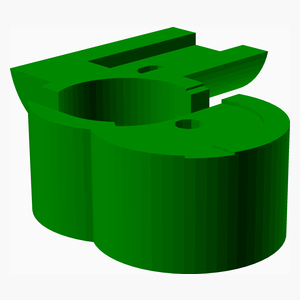
[picture p154: build/stls/x_holderL2.png]
x_holderL2.stl
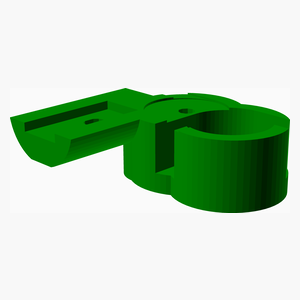
[picture p155: build/stls/x_holderR2.png]
x_holderR2.stl
|  |  

### Sub-assemblies

| 1 x frame21_assembly |
|---|
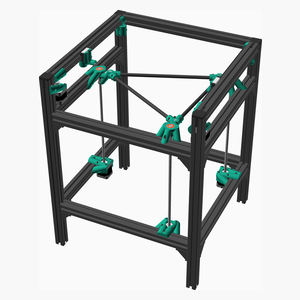
[picture p156: build/assemblies/frame21_assembled_tn.png]
frame21_assembled
|  

### Assembly instructions
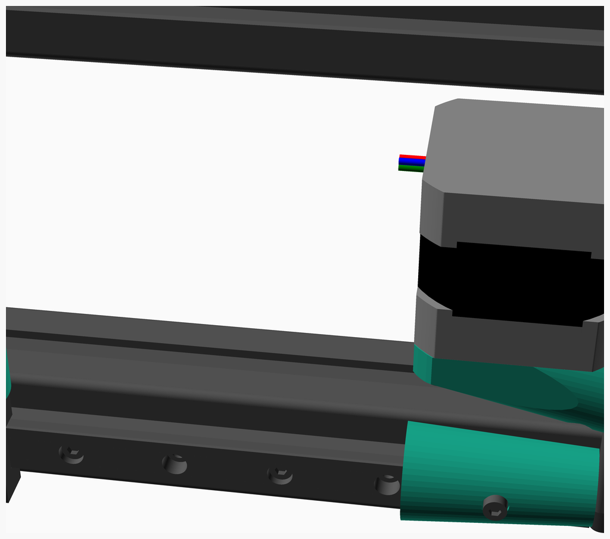
[picture p157: build/assemblies/frame22_assembly.png]
frame22_assembly


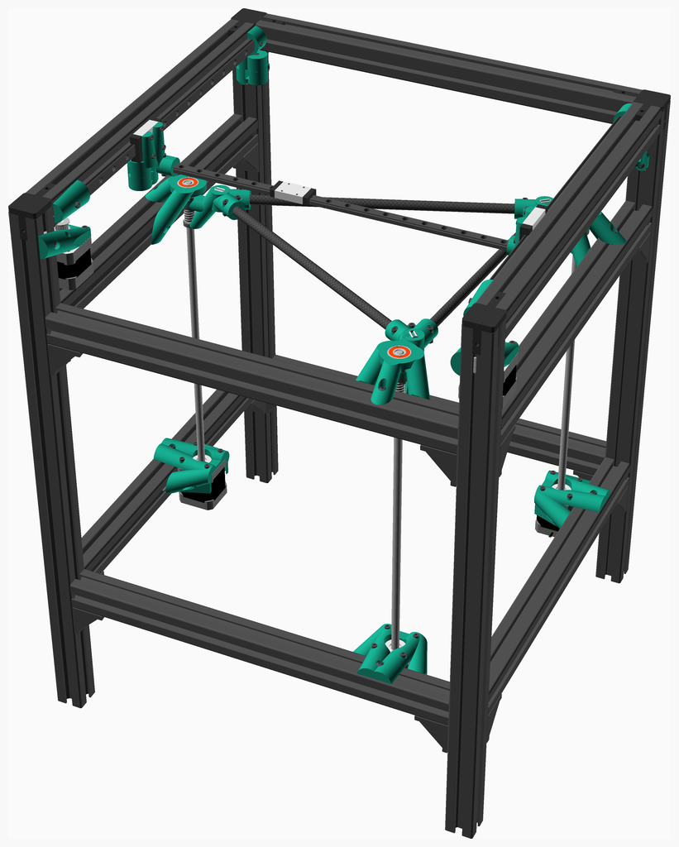
[picture p158: build/assemblies/frame22_assembled.png]
frame22_assembled


<span></span>
[Top](#TOP)

---

## Frame30 Assembly
### Vitamins
|Qty|Description|
|---:|:---|
|2| Nut M3 x 2.4mm |
|2| Screw M3 cap x 30mm|
|4| Screw M3 cs cap x 12mm|

### Sub-assemblies

| 1 x carriage2_assembly | 1 x frame22_assembly |
|---|---|
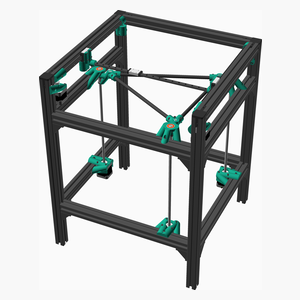
[picture p159: build/assemblies/frame22_assembled_tn.png]
frame22_assembled
| carriage2_assembled |  

### Assembly instructions
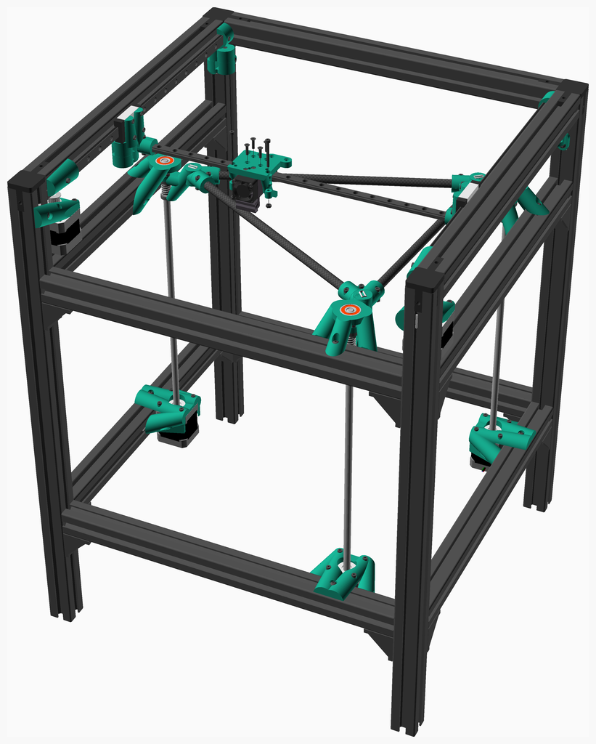
[picture p160: build/assemblies/frame30_assembly.png]
frame30_assembly


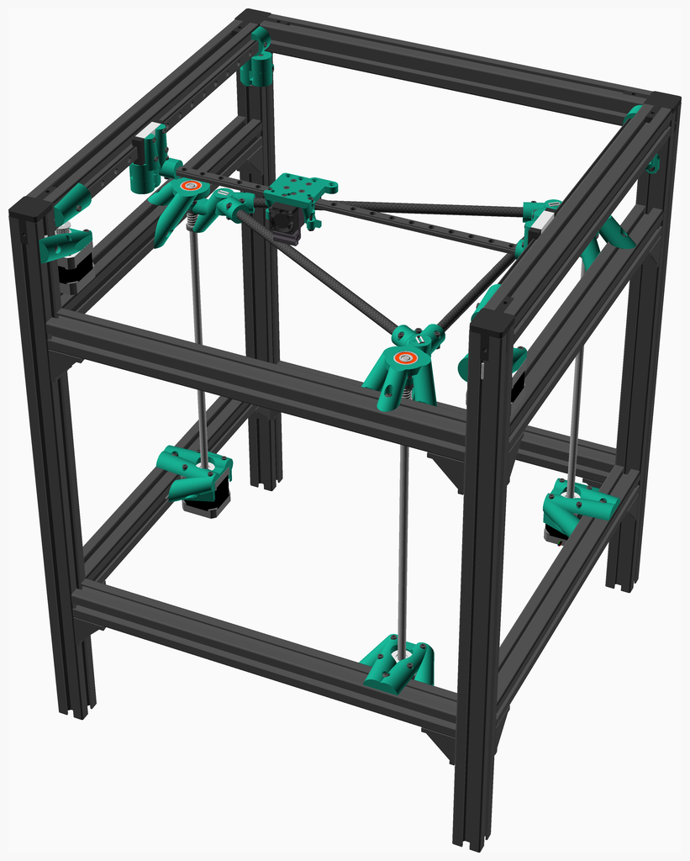
[picture p161: build/assemblies/frame30_assembled.png]
frame30_assembled


<span></span>
[Top](#TOP)

---

## Frame31 Assembly
### Vitamins
|Qty|Description|
|---:|:---|
|2| Nut M2.5 x 2.2mm |
|2| Nut M3 x 2.4mm |
|2| Screw M2.5 cap x 10mm|
|2| Screw M3 cs cap x 12mm|

### 3D Printed parts

| 1 x fan_holder_at_carriage.stl | 1 x mosquito_fan_duct.stl |
|---|---|
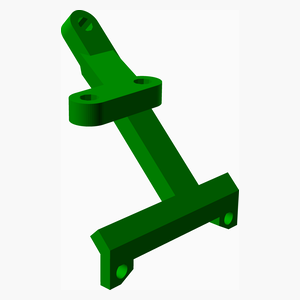
[picture p162: build/stls/fan_holder_at_carriage.png]
fan_holder_at_carriage.stl
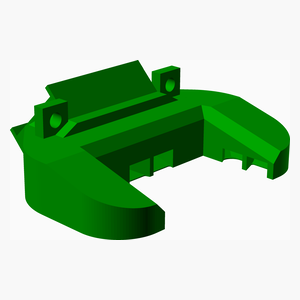
[picture p163: build/stls/mosquito_fan_duct.png]
mosquito_fan_duct.stl
|  |  

### Sub-assemblies

| 1 x frame30_assembly |
|---|
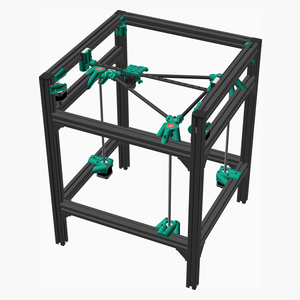
[picture p164: build/assemblies/frame30_assembled_tn.png]
frame30_assembled
|  

### Assembly instructions
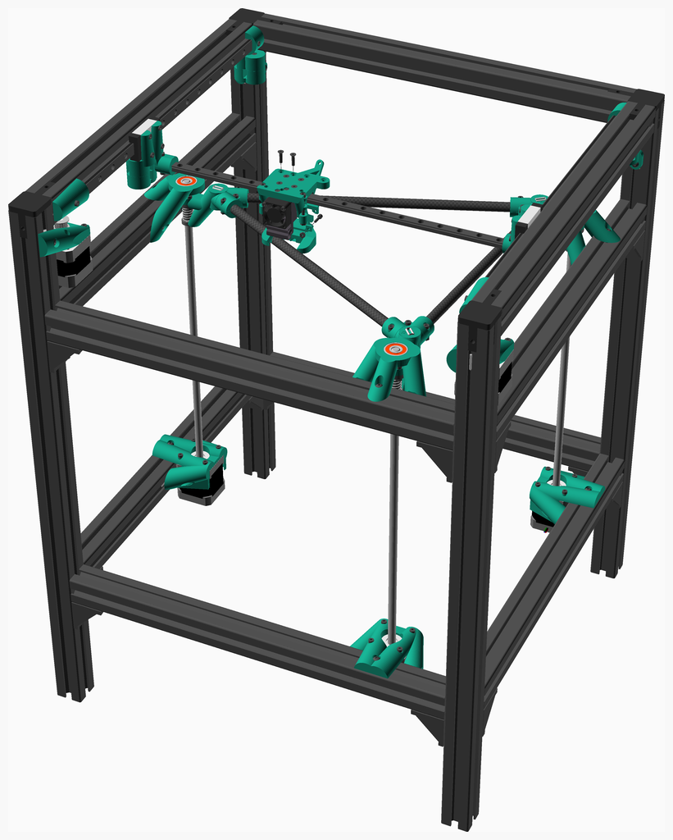
[picture p165: build/assemblies/frame31_assembly.png]
frame31_assembly


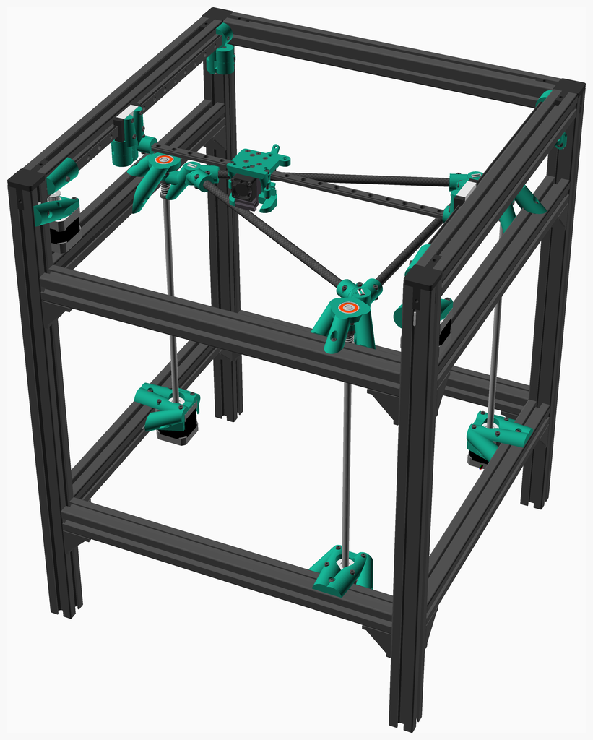
[picture p166: build/assemblies/frame31_assembled.png]
frame31_assembled


<span></span>
[Top](#TOP)

---

## Frame32 Assembly
### Vitamins
|Qty|Description|
|---:|:---|
|1| BLTouch|
|2| Nut M3 x 2.4mm |
|2| Screw M3 cs cap x 10mm|

### Sub-assemblies

| 1 x frame31_assembly |
|---|
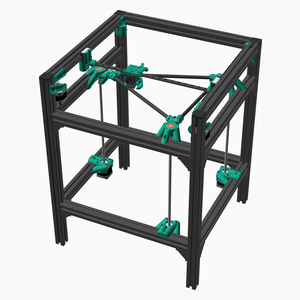
[picture p167: build/assemblies/frame31_assembled_tn.png]
frame31_assembled
|  

### Assembly instructions
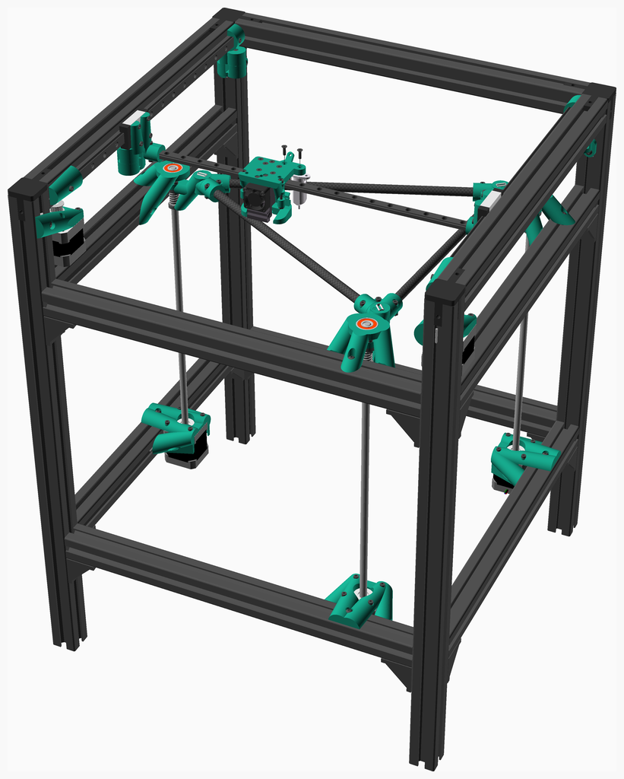
[picture p168: build/assemblies/frame32_assembly.png]
frame32_assembly


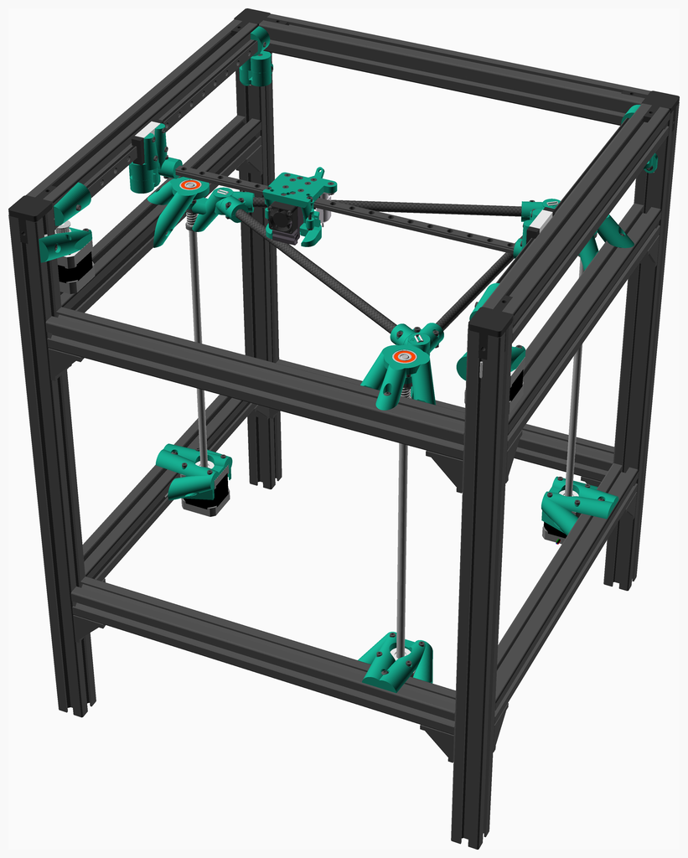
[picture p169: build/assemblies/frame32_assembled.png]
frame32_assembled


<span></span>
[Top](#TOP)

---

## Frame33 Assembly
### Vitamins
|Qty|Description|
|---:|:---|
|1| Blower Runda RB5015|
|1| Nut M3 x 2.4mm |
|1| Screw M3 cap x 25mm|

### Sub-assemblies

| 1 x frame32_assembly |
|---|
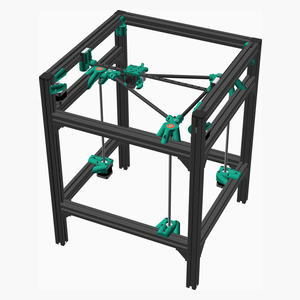
[picture p170: build/assemblies/frame32_assembled_tn.png]
frame32_assembled
|  

### Assembly instructions
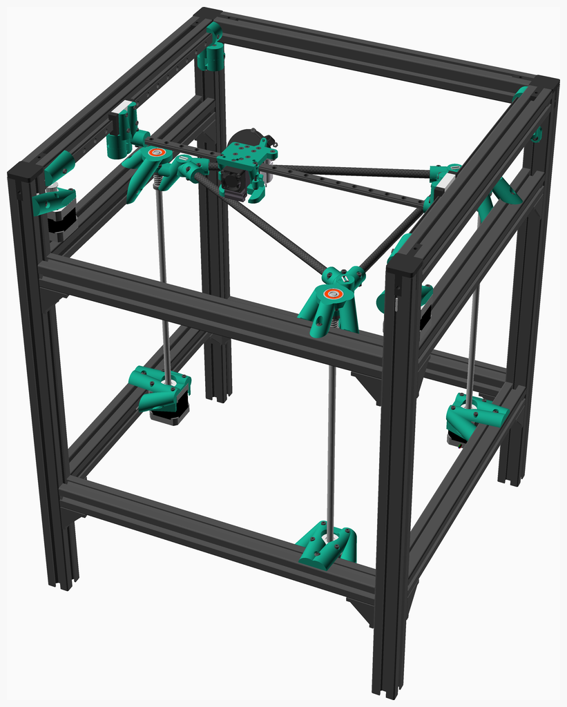
[picture p171: build/assemblies/frame33_assembly.png]
frame33_assembly


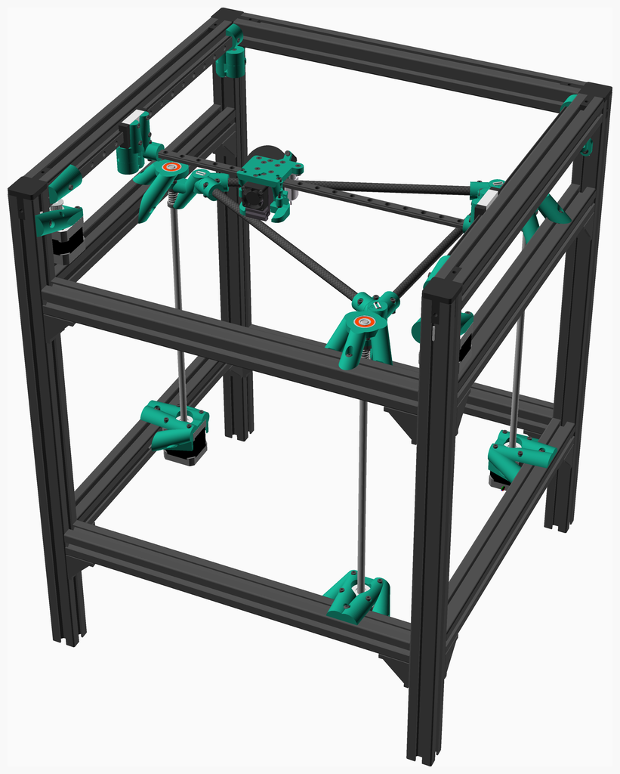
[picture p172: build/assemblies/frame33_assembled.png]
frame33_assembled


<span></span>
[Top](#TOP)

---

## Frame35 Assembly
### Vitamins
|Qty|Description|
|---:|:---|
|2| Heatfit insert M3|
|1| Orbiter Extruder and motor|
|2| Screw M3 cap x  8mm|

### Sub-assemblies

| 1 x frame33_assembly |
|---|
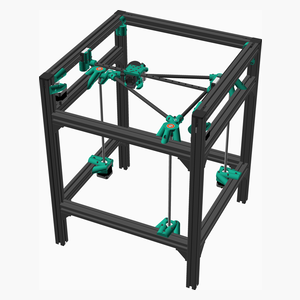
[picture p173: build/assemblies/frame33_assembled_tn.png]
frame33_assembled
|  

### Assembly instructions
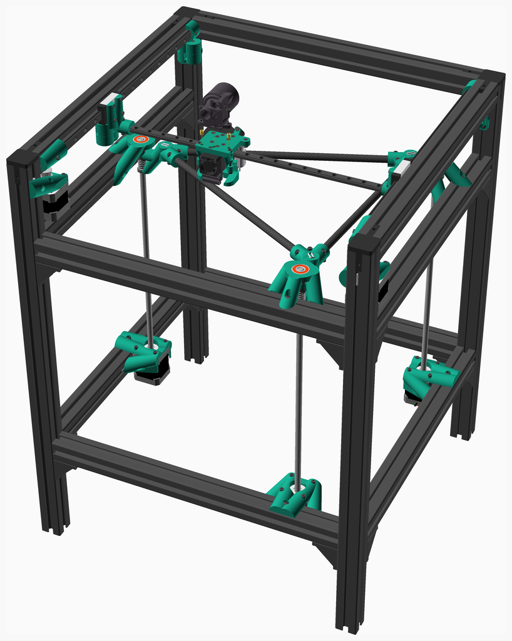
[picture p174: build/assemblies/frame35_assembly.png]
frame35_assembly


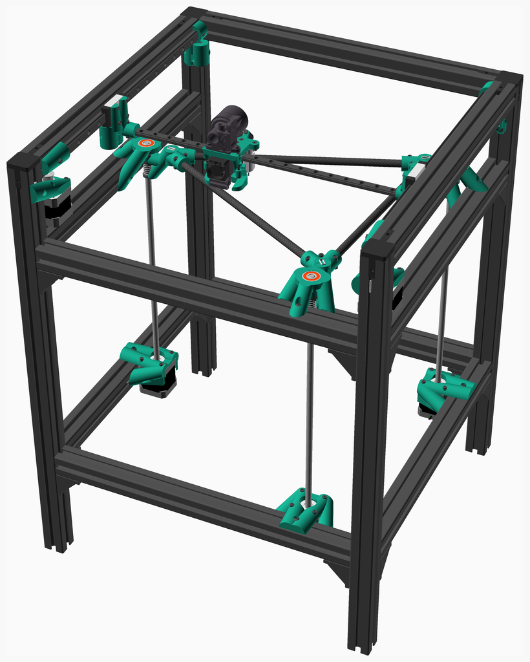
[picture p175: build/assemblies/frame35_assembled.png]
frame35_assembled


<span></span>
[Top](#TOP)

---

## Frame40 Assembly
### Vitamins
|Qty|Description|
|---:|:---|
|1| Belt GT_gates2 x 6mm x 1644mm|
|1| Belt GT_gates2 x 6mm x 1644mm|

### Sub-assemblies

| 1 x frame35_assembly |
|---|
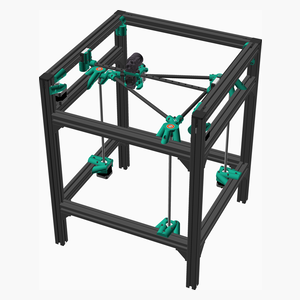
[picture p176: build/assemblies/frame35_assembled_tn.png]
frame35_assembled
|  

### Assembly instructions
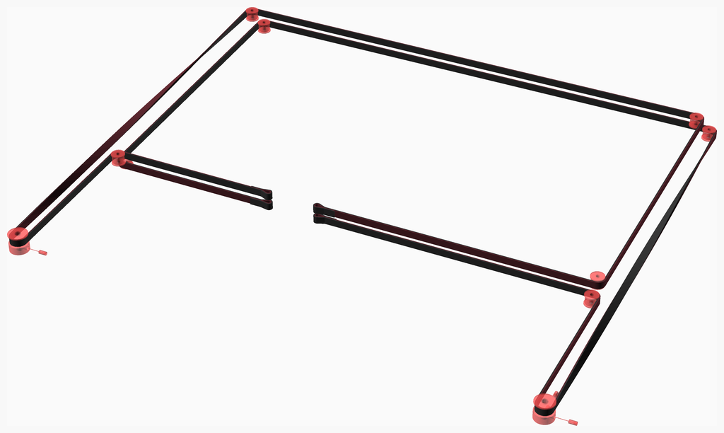
[picture p177: build/assemblies/frame40_assembly.png]
frame40_assembly


frame40_assembled

<span></span>
[Top](#TOP)
