SmoothieAq/cevo2/build/bom/frame20_assembly.txt

frame20_assembly:
Vitamins:
  2 Linear rail carriage MGN12H
  2 Linear rail MGN12 x 400mm
 14 Screw M3 cap x 12mm
  4 Screw M3 cap x 16mm

Printed:
  2 rail_y_back_stop.stl
  2 rail_y_front_stop.stl

Assemblies:
  1 frame11_assembly
