SmoothieAq/cevo2/build/bom/frame22_assembly.txt

frame22_assembly:
Vitamins:
  1 Linear rail carriage MGN9H
  2 Nut M3 x 2.4mm 
  4 Pulley GT2 (2 x F623ZZ flanged + washer 0.8) idler smooth 10mm
  1 Linear rail MGN9 x 400mm
  2 Screw M3 cap x 20mm
  4 Screw M3 cap x 30mm
  8 Washer  M3 x 6mm x 1mm

Printed:
  1 x_holderL2.stl
  1 x_holderR2.stl

Assemblies:
  1 frame21_assembly
