SmoothieAq/cevo2/build/bom/leads1_assembly.txt

leads1_assembly:
Vitamins:
  3 Stepper motor NEMA17 x 47mm
 12 Screw M3 cap x 12mm

Printed:
  1 leads_motor_holderB.stl
  1 leads_motor_holderF.stl
  1 leads_motor_holderL.stl
