SmoothieAq/cevo2/build/bom/frame31_assembly.txt

frame31_assembly:
Vitamins:
  2 Nut M2.5 x 2.2mm 
  2 Nut M3 x 2.4mm 
  2 Screw M2.5 cap x 10mm
  2 Screw M3 cs cap x 12mm

Printed:
  1 fan_holder_at_carriage.stl
  1 mosquito_fan_duct.stl

Assemblies:
  1 frame30_assembly
