SmoothieAq/cevo2/build/bom/frame33_assembly.txt

frame33_assembly:
Vitamins:
  1 Blower Runda RB5015
  1 Nut M3 x 2.4mm 
  1 Screw M3 cap x 25mm

Assemblies:
  1 frame32_assembly
