SmoothieAq/cevo2/build/bom/main_assembly.txt

main_assembly:

Assemblies:
  1 frame40_assembly
