SmoothieAq/cevo2/build/bom/frame10_assembly.txt

frame10_assembly:
Vitamins:
  8 Screw M4 dome x  8mm

Assemblies:
  1 frame3_assembly
  1 idler_assembly
