SmoothieAq/cevo2/build/bom/frame11_assembly.txt

frame11_assembly:
Vitamins:
  4 Screw M4 dome x 12mm

Assemblies:
  1 frame10_assembly
  1 loops_motor_holder_assembly
