SmoothieAq/cevo2/build/bom/frame_assembly.txt

frame_assembly:
Vitamins:
  4 Extrusion E3030 x 420mm
  6 Extrusion corner bracket 30
 12 Screw M4 dome x  8mm
 15 Nut M4 sliding T

Assemblies:
  1 frame_sideL_assembly
  1 frame_sideR_assembly
