SmoothieAq/cevo2/build/bom/leads2_assembly.txt

leads2_assembly:

Assemblies:
  1 bed1_assembly
  1 leads1_assembly
