SmoothieAq/cevo2/build/printme.html

# Cevo2

Main Assembly

## Table of Contents

1. Parts list
2. Carriage1 Assembly
3. Carriage2 Assembly
4. Loops Motor Holder Assembly
5. Idler Assembly
6. Bed1 Assembly
7. Leads1 Assembly
8. Leads2 Assembly
9. Frame SideR Assembly
10. Frame SideL Assembly
11. Frame Assembly
12. Frame1 Assembly
13. Frame2 Assembly
14. Frame3 Assembly
15. Frame10 Assembly
16. Frame11 Assembly
17. Frame20 Assembly
18. Frame21 Assembly
19. Frame22 Assembly
20. Frame30 Assembly
21. Frame31 Assembly
22. Frame32 Assembly
23. Frame33 Assembly
24. Frame35 Assembly
25. Frame40 Assembly

## Parts list

Carriage1 | Carriage2 | Loops Motor Holder | Idler | Bed1 | Leads1 | Leads2 | Frame SideR | Frame SideL | Frame | Frame1 | Frame2 | Frame3 | Frame10 | Frame11 | Frame20 | Frame21 | Frame22 | Frame30 | Frame31 | Frame32 | Frame33 | Frame35 | Frame40 | TOTALS
| | | | | | | | | | | | | | | | | | | | | | | | | Vitamins
. | . | . | . | . | . | . | . | . | . | . | . | . | . | . | . | . | . | . | . | 1 | . | . | . | 1 | BLTouch
. | . | . | . | . | . | . | . | . | . | . | 3 | . | . | . | . | . | . | . | . | . | . | . | . | 3 | Ball bearing 608-2RS 8mm x 22mm x 7mm
. | . | . | . | . | . | . | . | . | . | . | . | . | . | . | . | . | . | . | . | . | . | . | 1 | 1 | Belt GT_gates2 x 6mm x 1644mm
. | . | . | . | . | . | . | . | . | . | . | . | . | . | . | . | . | . | . | . | . | . | . | 1 | 1 | Belt GT_gates2 x 6mm x 1644mm
. | . | . | . | . | . | . | . | . | . | . | . | . | . | . | . | . | . | . | . | . | 1 | . | . | 1 | Blower Runda RB5015
. | . | . | . | . | . | . | . | . | . | . | . | 1 | . | . | . | . | . | . | . | . | . | . | . | 1 | Carbon fiber OD 10mm ID 8mm x 257.792mm
. | . | . | . | . | . | . | . | . | . | . | . | 2 | . | . | . | . | . | . | . | . | . | . | . | 2 | Carbon fiber OD 10mm ID 8mm x 304.676mm
. | . | . | . | . | . | . | 3 | 3 | . | . | . | . | . | . | . | . | . | . | . | . | . | . | . | 6 | Extrusion E3030 x 410mm
. | . | . | . | . | . | . | . | . | 4 | . | . | . | . | . | . | . | . | . | . | . | . | . | . | 4 | Extrusion E3030 x 420mm
. | . | . | . | . | . | . | 2 | 2 | . | . | . | . | . | . | . | . | . | . | . | . | . | . | . | 4 | Extrusion E3030 x 600mm
. | . | . | . | . | . | . | 4 | 4 | 6 | . | . | . | . | . | . | . | . | . | . | . | . | . | . | 14 | Extrusion corner bracket 30
. | . | . | . | . | . | . | 2 | 2 | . | . | . | . | . | . | . | . | . | . | . | . | . | . | . | 4 | Extrusion inner corner bracket E30 M5
. | 1 | . | . | . | . | . | . | . | . | . | . | . | . | . | . | . | . | . | . | . | . | . | . | 1 | Fan 25.4mm x 10mm
. | . | . | . | . | . | . | . | . | . | . | . | . | . | . | . | . | . | . | . | . | . | 2 | . | 2 | Heatfit insert M3
. | . | . | . | 3 | . | . | . | . | . | . | . | . | . | . | . | . | . | . | . | . | . | . | . | 3 | Leadscrew nut 8 x 2
. | . | . | . | . | . | . | . | . | . | . | . | . | . | . | 2 | . | . | . | . | . | . | . | . | 2 | Linear rail MGN12 x 400mm
. | . | . | . | . | . | . | . | . | . | . | . | . | . | . | . | . | 1 | . | . | . | . | . | . | 1 | Linear rail MGN9 x 400mm
. | . | . | . | . | . | . | . | . | . | . | . | . | . | . | 2 | . | . | . | . | . | . | . | . | 2 | Linear rail carriage MGN12H
. | . | . | . | . | . | . | . | . | . | . | . | . | . | . | . | . | 1 | . | . | . | . | . | . | 1 | Linear rail carriage MGN9H
1 | . | . | . | . | . | . | . | . | . | . | . | . | . | . | . | . | . | . | . | . | . | . | . | 1 | Mosquito hotend
2 | 2 | . | . | . | . | . | . | . | . | . | . | . | . | . | . | . | . | . | 2 | . | . | . | . | 6 | Nut M2.5 x 2.2mm
. | . | . | . | . | . | . | 9 | 9 | . | . | . | . | . | . | . | . | . | . | . | . | . | . | . | 18 | Nut M3 sliding T
. | . | . | 4 | 12 | . | . | . | . | . | . | . | 9 | . | . | . | 4 | 2 | 2 | 2 | 2 | 1 | . | . | 38 | Nut M3 x 2.4mm
. | . | . | . | . | . | . | 17 | 17 | 15 | . | . | . | . | . | . | . | . | . | . | . | . | . | . | 49 | Nut M4 sliding T
. | . | . | . | . | . | . | . | . | . | . | . | . | . | . | . | . | . | . | . | . | . | 1 | . | 1 | Orbiter Extruder and motor
. | . | . | 4 | . | . | . | . | . | . | . | . | . | . | . | . | . | 4 | . | . | . | . | . | . | 8 | Pulley GT2 (2 x F623ZZ flanged + washer 0.8) idler smooth 10mm
. | . | 2 | . | . | . | . | . | . | . | . | . | . | . | . | . | . | . | . | . | . | . | . | . | 2 | Pulley GT2OB 20 teeth
. | . | . | . | . | . | . | . | . | . | . | . | . | . | . | . | . | . | . | 2 | . | . | . | . | 2 | Screw M2.5 cap x 10mm
. | 2 | . | . | . | . | . | . | . | . | . | . | . | . | . | . | . | . | . | . | . | . | . | . | 2 | Screw M2.5 cap x 30mm
2 | . | . | . | . | . | . | . | . | . | . | . | . | . | . | . | . | . | . | . | . | . | . | . | 2 | Screw M2.5 dome x 10mm
. | . | . | . | . | . | . | . | . | . | . | . | . | . | . | . | . | . | . | . | . | . | 2 | . | 2 | Screw M3 cap x 8mm
. | . | . | . | . | . | . | . | . | . | . | . | . | . | . | . | 4 | . | . | . | . | . | . | . | 4 | Screw M3 cap x 10mm
. | . | 4 | . | . | . | . | . | . | . | . | . | . | . | . | . | . | . | . | . | . | . | . | . | 4 | Screw M3 cap x 11mm
. | . | . | . | 12 | 12 | . | . | . | . | . | . | 9 | . | . | 14 | 4 | . | . | . | . | . | . | . | 51 | Screw M3 cap x 12mm
. | . | 4 | . | . | . | . | . | . | . | . | . | . | . | . | . | . | . | . | . | . | . | . | . | 4 | Screw M3 cap x 14mm
. | . | . | . | . | . | . | . | . | . | . | . | . | . | . | 4 | . | . | . | . | . | . | . | . | 4 | Screw M3 cap x 16mm
. | . | . | . | . | . | . | . | . | . | . | . | . | . | . | . | . | 2 | . | . | . | . | . | . | 2 | Screw M3 cap x 20mm
. | . | . | . | . | . | . | . | . | . | . | . | . | . | . | . | . | . | . | . | . | 1 | . | . | 1 | Screw M3 cap x 25mm
. | . | . | 4 | . | . | . | . | . | . | . | . | . | . | . | . | . | 4 | 2 | . | . | . | . | . | 10 | Screw M3 cap x 30mm
. | . | . | . | . | . | . | . | . | . | . | . | . | . | . | . | . | . | . | . | 2 | . | . | . | 2 | Screw M3 cs cap x 10mm
. | . | . | . | . | . | . | . | . | . | . | . | . | . | . | . | . | . | 4 | 2 | . | . | . | . | 6 | Screw M3 cs cap x 12mm
. | . | 4 | . | . | . | . | . | . | . | . | . | . | . | . | . | . | . | . | . | . | . | . | . | 4 | Screw M3 grub x 6mm
. | . | . | . | . | . | . | 8 | 8 | 12 | . | . | . | 8 | . | . | . | . | . | . | . | . | . | . | 36 | Screw M4 dome x 8mm
. | . | . | . | . | . | . | . | . | . | 9 | 9 | . | . | 4 | . | . | . | . | . | . | . | . | . | 22 | Screw M4 dome x 12mm
. | . | . | . | 6 | . | . | . | . | . | . | . | . | . | . | . | . | . | . | . | . | . | . | . | 6 | Smooth rod 2mm x 10mm
. | . | . | . | 3 | . | . | . | . | . | . | . | . | . | . | . | . | . | . | . | . | . | . | . | 3 | Spring 11.85mm OD, 0.8mm gauge x 37.8mm long, closed end
. | . | 2 | . | . | . | . | . | . | . | . | . | . | . | . | . | . | . | . | . | . | . | . | . | 2 | Stepper motor NEMA17 x 40mm
. | . | . | . | . | 3 | . | . | . | . | . | . | . | . | . | . | . | . | . | . | . | . | . | . | 3 | Stepper motor NEMA17 x 47mm
. | . | . | . | 6 | . | . | . | . | . | . | . | . | . | . | . | . | . | . | . | . | . | . | . | 6 | Washer M2 x 5mm x 0.3mm
. | . | . | 8 | . | . | . | . | . | . | . | . | . | . | . | . | . | 8 | . | . | . | . | . | . | 16 | Washer M3 x 6mm x 1mm
5 | 5 | 16 | 20 | 42 | 15 | . | 45 | 45 | 37 | 9 | 12 | 21 | 8 | 4 | 22 | 12 | 22 | 8 | 8 | 5 | 3 | 5 | 2 | 371 | Total vitamins count
| | | | | | | | | | | | | | | | | | | | | | | | | 3D printed parts
. | . | . | . | . | . | . | . | . | . | . | . | 1 | . | . | . | . | . | . | . | . | . | . | . | 1 | bed_holderB1.stl
. | . | . | . | 1 | . | . | . | . | . | . | . | . | . | . | . | . | . | . | . | . | . | . | . | 1 | bed_holderB2.stl
. | . | . | . | . | . | . | . | . | . | . | . | 1 | . | . | . | . | . | . | . | . | . | . | . | 1 | bed_holderF1.stl
. | . | . | . | 1 | . | . | . | . | . | . | . | . | . | . | . | . | . | . | . | . | . | . | . | 1 | bed_holderF2.stl
. | . | . | . | . | . | . | . | . | . | . | . | 1 | . | . | . | . | . | . | . | . | . | . | . | 1 | bed_holderL1.stl
. | . | . | . | 1 | . | . | . | . | . | . | . | . | . | . | . | . | . | . | . | . | . | . | . | 1 | bed_holderL2.stl
1 | . | . | . | . | . | . | . | . | . | . | . | . | . | . | . | . | . | . | . | . | . | . | . | 1 | carriage.stl
. | . | . | . | . | . | . | . | . | . | . | . | . | . | . | . | . | . | . | 1 | . | . | . | . | 1 | fan_holder_at_carriage.stl
. | . | . | 1 | . | . | . | . | . | . | . | . | . | . | . | . | . | . | . | . | . | . | . | . | 1 | idler_holderL1.stl
. | . | . | 1 | . | . | . | . | . | . | . | . | . | . | . | . | . | . | . | . | . | . | . | . | 1 | idler_holderL2.stl
. | . | . | 1 | . | . | . | . | . | . | . | . | . | . | . | . | . | . | . | . | . | . | . | . | 1 | idler_holderR1.stl
. | . | . | 1 | . | . | . | . | . | . | . | . | . | . | . | . | . | . | . | . | . | . | . | . | 1 | idler_holderR2.stl
. | . | . | . | . | . | . | . | . | . | . | 3 | . | . | . | . | . | . | . | . | . | . | . | . | 3 | leads_holder.stl
. | . | . | . | . | 1 | . | . | . | . | . | . | . | . | . | . | . | . | . | . | . | . | . | . | 1 | leads_motor_holderB.stl
. | . | . | . | . | 1 | . | . | . | . | . | . | . | . | . | . | . | . | . | . | . | . | . | . | 1 | leads_motor_holderF.stl
. | . | . | . | . | 1 | . | . | . | . | . | . | . | . | . | . | . | . | . | . | . | . | . | . | 1 | leads_motor_holderL.stl
. | . | 1 | . | . | . | . | . | . | . | . | . | . | . | . | . | . | . | . | . | . | . | . | . | 1 | loops_motor_holderL.stl
. | . | 1 | . | . | . | . | . | . | . | . | . | . | . | . | . | . | . | . | . | . | . | . | . | 1 | loops_motor_holderR.stl
. | . | . | . | . | . | . | . | . | . | . | . | . | . | . | . | . | . | . | 1 | . | . | . | . | 1 | mosquito_fan_duct.stl
. | . | . | . | . | . | . | . | . | . | . | . | . | . | . | 2 | . | . | . | . | . | . | . | . | 2 | rail_y_back_stop.stl
. | . | . | . | . | . | . | . | . | . | . | . | . | . | . | 2 | . | . | . | . | . | . | . | . | 2 | rail_y_front_stop.stl
. | . | . | . | . | . | . | . | . | . | . | . | . | . | . | . | 1 | . | . | . | . | . | . | . | 1 | x_holderL1.stl
. | . | . | . | . | . | . | . | . | . | . | . | . | . | . | . | . | 1 | . | . | . | . | . | . | 1 | x_holderL2.stl
. | . | . | . | . | . | . | . | . | . | . | . | . | . | . | . | 1 | . | . | . | . | . | . | . | 1 | x_holderR1.stl
. | . | . | . | . | . | . | . | . | . | . | . | . | . | . | . | . | 1 | . | . | . | . | . | . | 1 | x_holderR2.stl
1 | . | 2 | 4 | 3 | 3 | . | . | . | . | . | 3 | 3 | . | . | 4 | 2 | 2 | . | 2 | . | . | . | . | 29 | Total 3D printed parts count

## Carriage1 Assembly

### Vitamins

Qty | Description
1 | Mosquito hotend
2 | Nut M2.5 x 2.2mm
2 | Screw M2.5 dome x 10mm

### 3D Printed parts

1 x carriage.stl

carriage.stl

### Assembly instructions

carriage1_assembly

carriage1_assembled

## Carriage2 Assembly

### Vitamins

Qty | Description
1 | Fan 25.4mm x 10mm
2 | Nut M2.5 x 2.2mm
2 | Screw M2.5 cap x 30mm

### Sub-assemblies

1 x carriage1_assembly

carriage1_assembled

### Assembly instructions

carriage2_assembly

carriage2_assembled

## Loops Motor Holder Assembly

### Vitamins

Qty | Description
2 | Pulley GT2OB 20 teeth
4 | Screw M3 cap x 11mm
4 | Screw M3 cap x 14mm
4 | Screw M3 grub x 6mm
2 | Stepper motor NEMA17 x 40mm

### 3D Printed parts

1 x loops_motor_holderL.stl | 1 x loops_motor_holderR.stl
loops_motor_holderL.stl | loops_motor_holderR.stl

### Assembly instructions

loops_motor_holder_assembly

loops_motor_holder_assembled

## Idler Assembly

### Vitamins

Qty | Description
4 | Nut M3 x 2.4mm
4 | Pulley GT2 (2 x F623ZZ flanged + washer 0.8) idler smooth 10mm
4 | Screw M3 cap x 30mm
8 | Washer M3 x 6mm x 1mm

### 3D Printed parts

1 x idler_holderL1.stl | 1 x idler_holderL2.stl | 1 x idler_holderR1.stl
idler_holderL1.stl | idler_holderL2.stl | idler_holderR1.stl

1 x idler_holderR2.stl

idler_holderR2.stl

### Assembly instructions

idler_assembly

idler_assembled

## Bed1 Assembly

### Vitamins

Qty | Description
3 | Leadscrew nut 8 x 2
12 | Nut M3 x 2.4mm
12 | Screw M3 cap x 12mm
6 | Smooth rod 2mm x 10mm
3 | Spring 11.85mm OD, 0.8mm gauge x 37.8mm long, closed end
6 | Washer M2 x 5mm x 0.3mm

### 3D Printed parts

1 x bed_holderB2.stl | 1 x bed_holderF2.stl | 1 x bed_holderL2.stl
bed_holderB2.stl | bed_holderF2.stl | bed_holderL2.stl

### Assembly instructions

bed1_assembly

bed1_assembled

## Leads1 Assembly

### Vitamins

Qty | Description
12 | Screw M3 cap x 12mm
3 | Stepper motor NEMA17 x 47mm

### 3D Printed parts

1 x leads_motor_holderB.stl | 1 x leads_motor_holderF.stl | 1 x leads_motor_holderL.stl
leads_motor_holderB.stl | leads_motor_holderF.stl | leads_motor_holderL.stl

### Assembly instructions

leads1_assembly

leads1_assembled

## Leads2 Assembly

### Sub-assemblies

1 x bed1_assembly | 1 x leads1_assembly
bed1_assembled | leads1_assembled

### Assembly instructions

leads2_assembly

leads2_assembled

## Frame SideR Assembly

### Vitamins

Qty | Description
3 | Extrusion E3030 x 410mm
2 | Extrusion E3030 x 600mm
4 | Extrusion corner bracket 30
2 | Extrusion inner corner bracket E30 M5
9 | Nut M3 sliding T
17 | Nut M4 sliding T
8 | Screw M4 dome x 8mm

### Assembly instructions

frame_sideR_assembly

frame_sideR_assembled

## Frame SideL Assembly

### Vitamins

Qty | Description
3 | Extrusion E3030 x 410mm
2 | Extrusion E3030 x 600mm
4 | Extrusion corner bracket 30
2 | Extrusion inner corner bracket E30 M5
9 | Nut M3 sliding T
17 | Nut M4 sliding T
8 | Screw M4 dome x 8mm

### Assembly instructions

frame_sideL_assembly

frame_sideL_assembled

## Frame Assembly

### Vitamins

Qty | Description
4 | Extrusion E3030 x 420mm
6 | Extrusion corner bracket 30
15 | Nut M4 sliding T
12 | Screw M4 dome x 8mm

### Sub-assemblies

1 x frame_sideL_assembly | 1 x frame_sideR_assembly
frame_sideL_assembled | frame_sideR_assembled

### Assembly instructions

frame_assembly

frame_assembled

## Frame1 Assembly

### Vitamins

Qty | Description
9 | Screw M4 dome x 12mm

### Sub-assemblies

1 x frame_assembly | 1 x leads2_assembly
frame_assembled | leads2_assembled

### Assembly instructions

frame1_assembly

frame1_assembled

## Frame2 Assembly

### Vitamins

Qty | Description
3 | Ball bearing 608-2RS 8mm x 22mm x 7mm
9 | Screw M4 dome x 12mm

### 3D Printed parts

3 x leads_holder.stl

leads_holder.stl

### Sub-assemblies

1 x frame1_assembly

frame1_assembled

### Assembly instructions

frame2_assembly

frame2_assembled

## Frame3 Assembly

### Vitamins

Qty | Description
1 | Carbon fiber OD 10mm ID 8mm x 257.792mm
2 | Carbon fiber OD 10mm ID 8mm x 304.676mm
9 | Nut M3 x 2.4mm
9 | Screw M3 cap x 12mm

### 3D Printed parts

1 x bed_holderB1.stl | 1 x bed_holderF1.stl | 1 x bed_holderL1.stl
bed_holderB1.stl | bed_holderF1.stl | bed_holderL1.stl

### Sub-assemblies

1 x frame2_assembly

frame2_assembled

### Assembly instructions

frame3_assembly

frame3_assembled

## Frame10 Assembly

### Vitamins

Qty | Description
8 | Screw M4 dome x 8mm

### Sub-assemblies

1 x frame3_assembly | 1 x idler_assembly
frame3_assembled | idler_assembled

### Assembly instructions

frame10_assembly

frame10_assembled

## Frame11 Assembly

### Vitamins

Qty | Description
4 | Screw M4 dome x 12mm

### Sub-assemblies

1 x frame10_assembly | 1 x loops_motor_holder_assembly
frame10_assembled | loops_motor_holder_assembled

### Assembly instructions

frame11_assembly

frame11_assembled

## Frame20 Assembly

### Vitamins

Qty | Description
2 | Linear rail MGN12 x 400mm
2 | Linear rail carriage MGN12H
14 | Screw M3 cap x 12mm
4 | Screw M3 cap x 16mm

### 3D Printed parts

2 x rail_y_back_stop.stl | 2 x rail_y_front_stop.stl
rail_y_back_stop.stl | rail_y_front_stop.stl

### Sub-assemblies

1 x frame11_assembly

frame11_assembled

### Assembly instructions

frame20_assembly

frame20_assembled

## Frame21 Assembly

### Vitamins

Qty | Description
4 | Nut M3 x 2.4mm
4 | Screw M3 cap x 10mm
4 | Screw M3 cap x 12mm

### 3D Printed parts

1 x x_holderL1.stl | 1 x x_holderR1.stl
x_holderL1.stl | x_holderR1.stl

### Sub-assemblies

1 x frame20_assembly

frame20_assembled

### Assembly instructions

frame21_assembly

frame21_assembled

## Frame22 Assembly

### Vitamins

Qty | Description
1 | Linear rail MGN9 x 400mm
1 | Linear rail carriage MGN9H
2 | Nut M3 x 2.4mm
4 | Pulley GT2 (2 x F623ZZ flanged + washer 0.8) idler smooth 10mm
2 | Screw M3 cap x 20mm
4 | Screw M3 cap x 30mm
8 | Washer M3 x 6mm x 1mm

### 3D Printed parts

1 x x_holderL2.stl | 1 x x_holderR2.stl
x_holderL2.stl | x_holderR2.stl

### Sub-assemblies

1 x frame21_assembly

frame21_assembled

### Assembly instructions

frame22_assembly

frame22_assembled

## Frame30 Assembly

### Vitamins

Qty | Description
2 | Nut M3 x 2.4mm
2 | Screw M3 cap x 30mm
4 | Screw M3 cs cap x 12mm

### Sub-assemblies

1 x carriage2_assembly | 1 x frame22_assembly
carriage2_assembled | frame22_assembled

### Assembly instructions

frame30_assembly

frame30_assembled

## Frame31 Assembly

### Vitamins

Qty | Description
2 | Nut M2.5 x 2.2mm
2 | Nut M3 x 2.4mm
2 | Screw M2.5 cap x 10mm
2 | Screw M3 cs cap x 12mm

### 3D Printed parts

1 x fan_holder_at_carriage.stl | 1 x mosquito_fan_duct.stl
fan_holder_at_carriage.stl | mosquito_fan_duct.stl

### Sub-assemblies

1 x frame30_assembly

frame30_assembled

### Assembly instructions

frame31_assembly

frame31_assembled

## Frame32 Assembly

### Vitamins

Qty | Description
1 | BLTouch
2 | Nut M3 x 2.4mm
2 | Screw M3 cs cap x 10mm

### Sub-assemblies

1 x frame31_assembly

frame31_assembled

### Assembly instructions

frame32_assembly

frame32_assembled

## Frame33 Assembly

### Vitamins

Qty | Description
1 | Blower Runda RB5015
1 | Nut M3 x 2.4mm
1 | Screw M3 cap x 25mm

### Sub-assemblies

1 x frame32_assembly

frame32_assembled

### Assembly instructions

frame33_assembly

frame33_assembled

## Frame35 Assembly

### Vitamins

Qty | Description
2 | Heatfit insert M3
1 | Orbiter Extruder and motor
2 | Screw M3 cap x 8mm

### Sub-assemblies

1 x frame33_assembly

frame33_assembled

### Assembly instructions

frame35_assembly

frame35_assembled

## Frame40 Assembly

### Vitamins

Qty | Description
1 | Belt GT_gates2 x 6mm x 1644mm
1 | Belt GT_gates2 x 6mm x 1644mm

### Sub-assemblies

1 x frame35_assembly

frame35_assembled

### Assembly instructions

frame40_assembly

frame40_assembled
