SmoothieAq/cevo2/build/assemblies/bed1_assembled.png

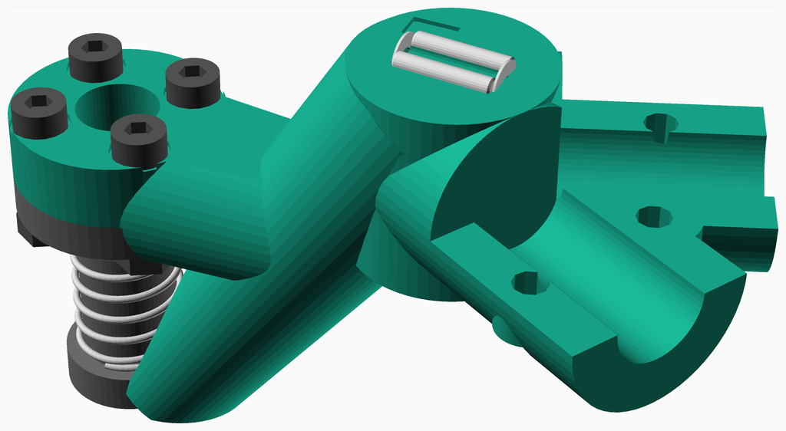
build/assemblies/bed1_assembled.png
