SmoothieAq/cevo2/build/assemblies/bed1_assembled_diff.png

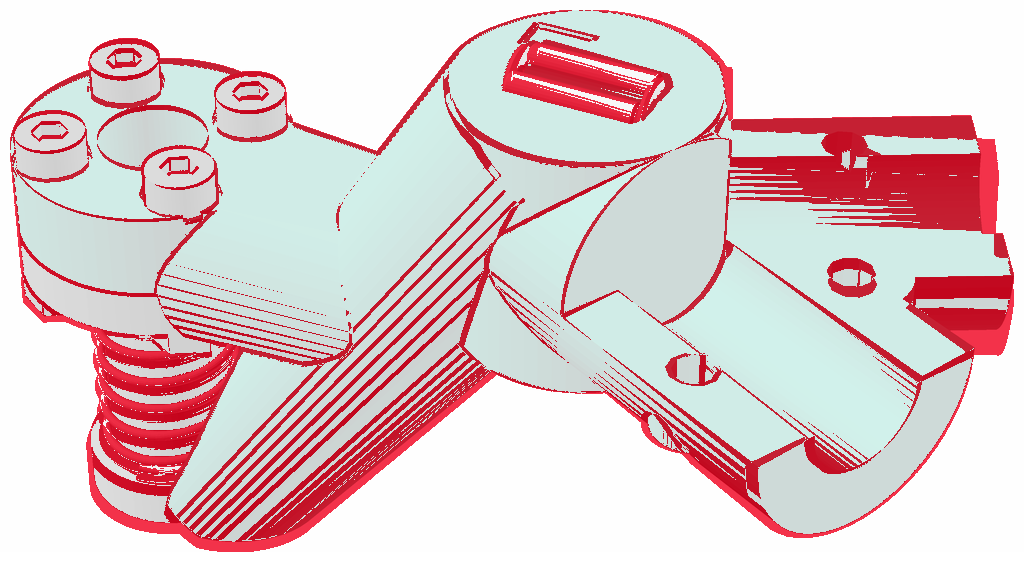
build/assemblies/bed1_assembled_diff.png
