SmoothieAq/cevo2/build/assemblies/bed1_assembled_tn_diff.png

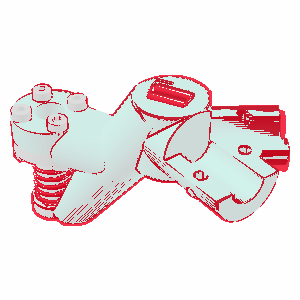
build/assemblies/bed1_assembled_tn_diff.png
