SmoothieAq/cevo2/build/assemblies/bed1_assembly.png

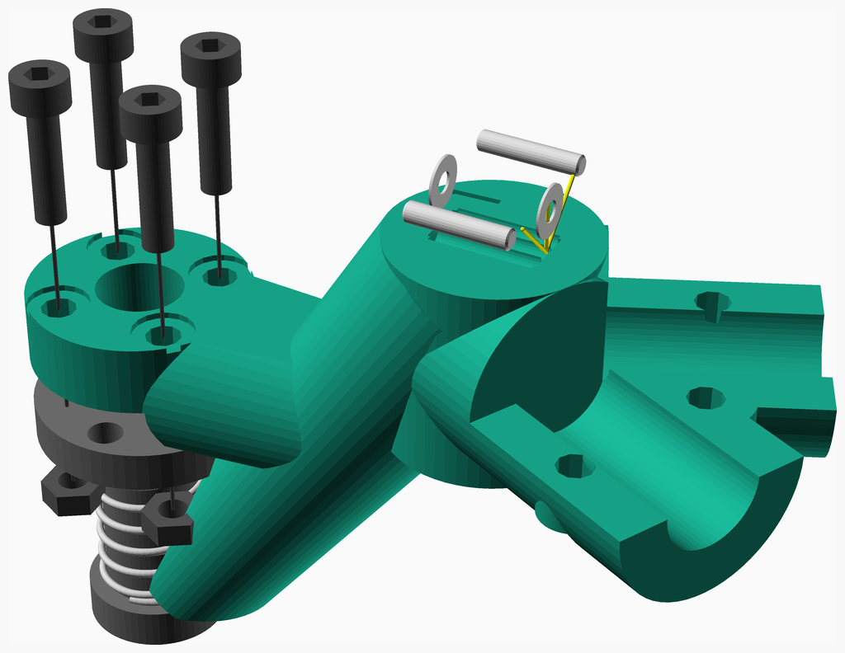
build/assemblies/bed1_assembly.png
