SmoothieAq/cevo2/build/assemblies/bed1_assembly_tn_diff.png

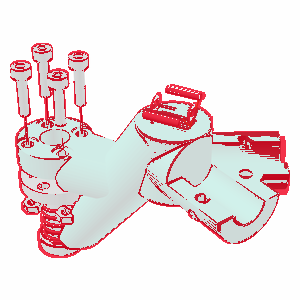
build/assemblies/bed1_assembly_tn_diff.png
