SmoothieAq/cevo2/build/assemblies/carriage1_assembled.png

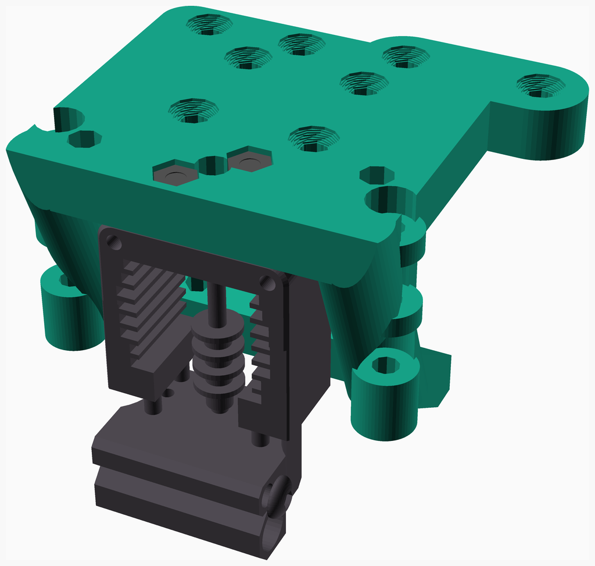
build/assemblies/carriage1_assembled.png
