SmoothieAq/cevo2/build/assemblies/carriage1_assembled_diff.png

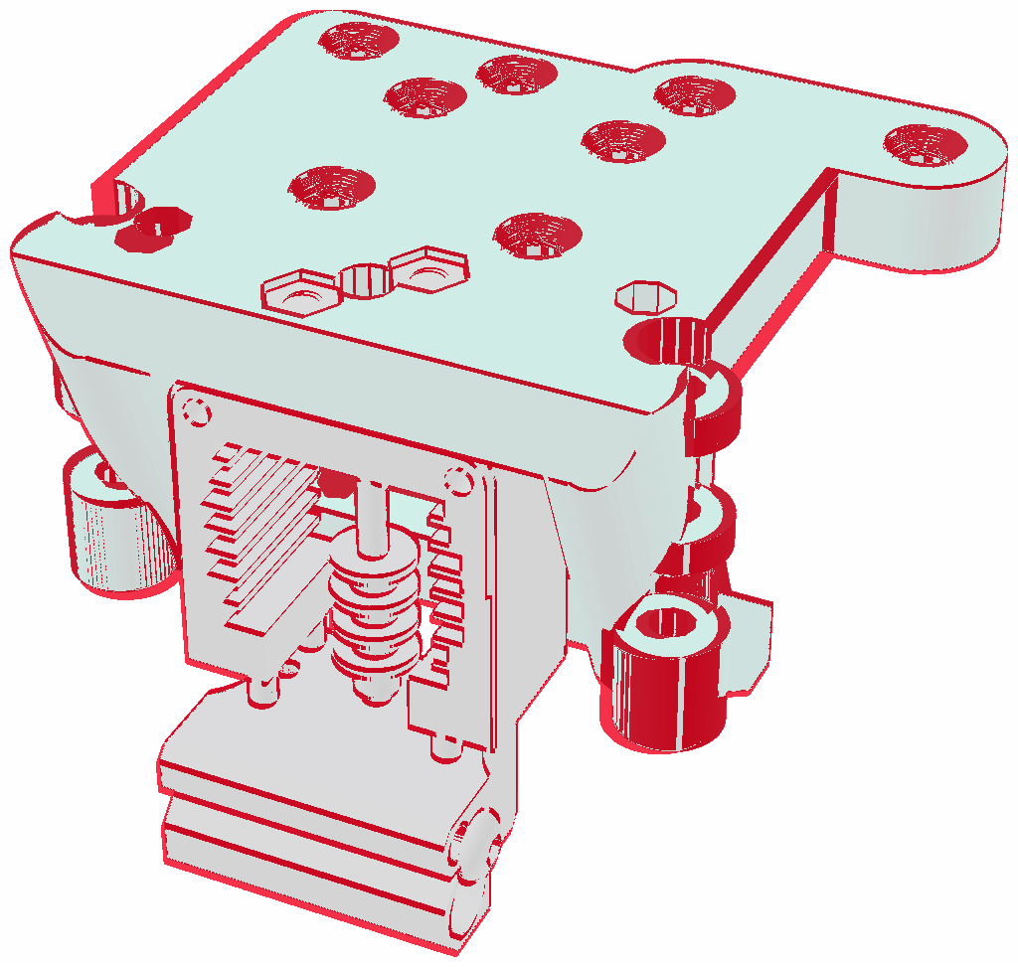
build/assemblies/carriage1_assembled_diff.png
