SmoothieAq/cevo2/build/assemblies/carriage1_assembly_tn_diff.png

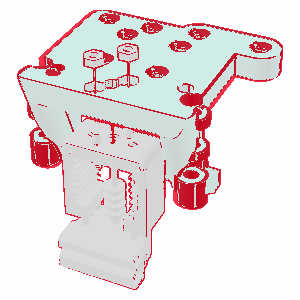
build/assemblies/carriage1_assembly_tn_diff.png
