SmoothieAq/cevo2/build/assemblies/carriage2_assembled.png

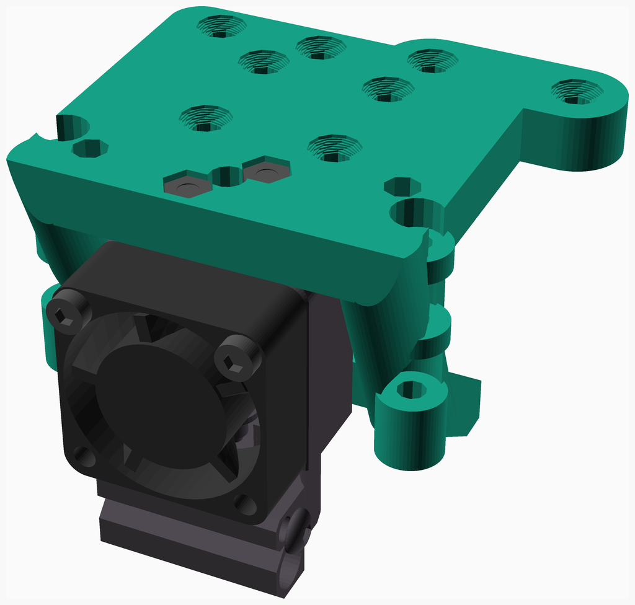
build/assemblies/carriage2_assembled.png
