SmoothieAq/cevo2/build/assemblies/carriage2_assembled_tn_diff.png

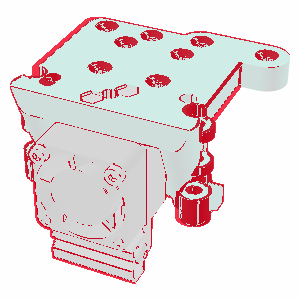
build/assemblies/carriage2_assembled_tn_diff.png
