SmoothieAq/cevo2/build/assemblies/carriage2_assembly.png

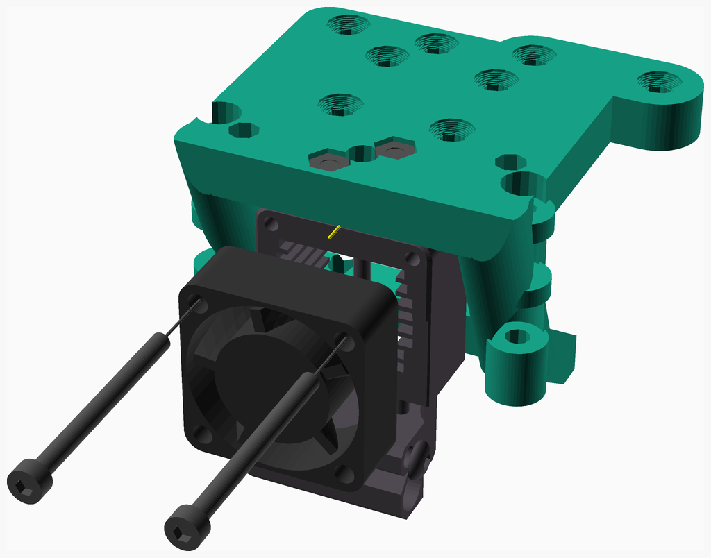
build/assemblies/carriage2_assembly.png
