SmoothieAq/cevo2/build/assemblies/carriage2_assembly_tn_diff.png

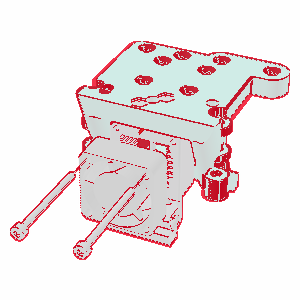
build/assemblies/carriage2_assembly_tn_diff.png
