SmoothieAq/cevo2/build/assemblies/frame1_assembled_diff.png

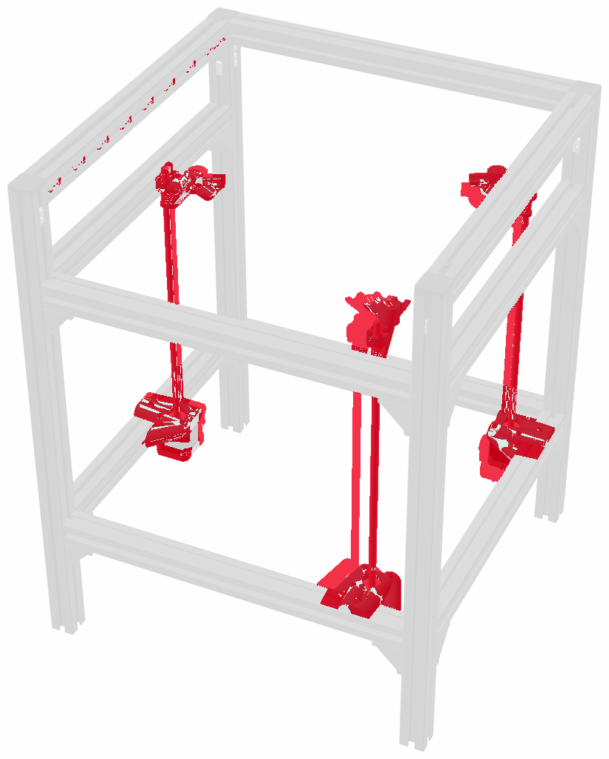
build/assemblies/frame1_assembled_diff.png
