SmoothieAq/cevo2/build/assemblies/frame1_assembly_tn.png

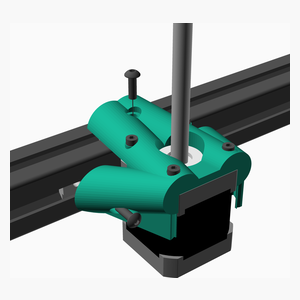
build/assemblies/frame1_assembly_tn.png
