SmoothieAq/cevo2/build/assemblies/frame1_assembly_tn_diff.png

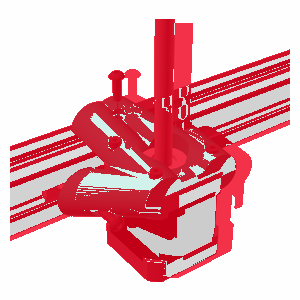
build/assemblies/frame1_assembly_tn_diff.png
