SmoothieAq/cevo2/build/assemblies/frame2_assembly_diff.png

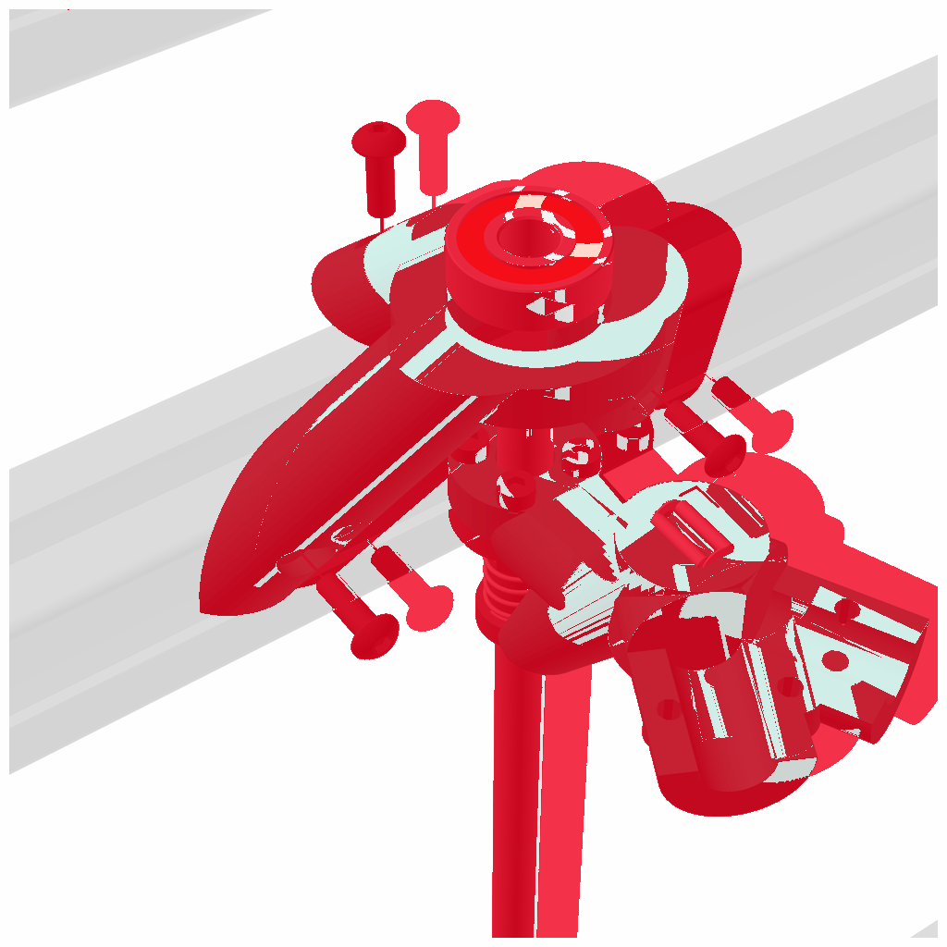
build/assemblies/frame2_assembly_diff.png
