SmoothieAq/cevo2/build/assemblies/frame2_assembly_tn.png

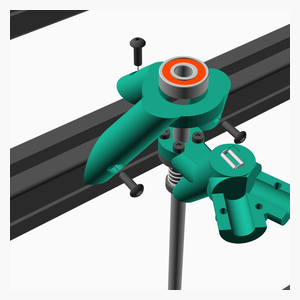
build/assemblies/frame2_assembly_tn.png
