SmoothieAq/cevo2/build/assemblies/frame3_assembly_diff.png

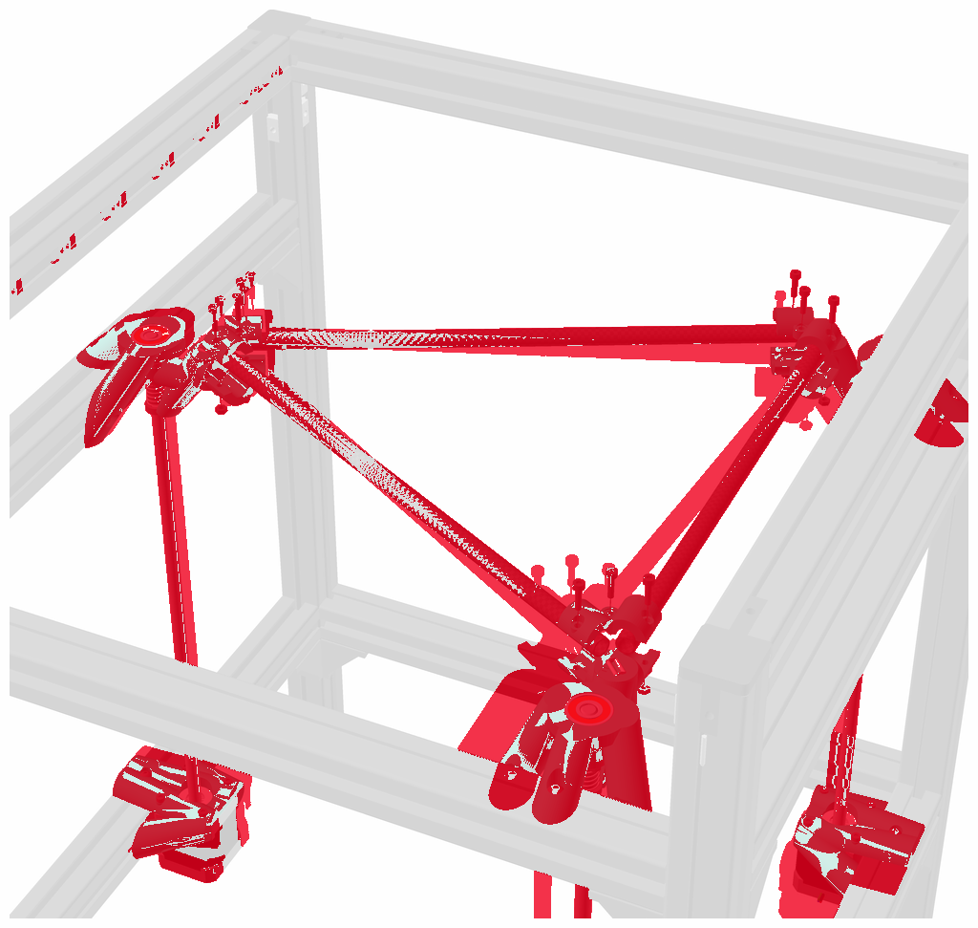
build/assemblies/frame3_assembly_diff.png
