SmoothieAq/cevo2/build/assemblies/frame3_assembly_tn.png

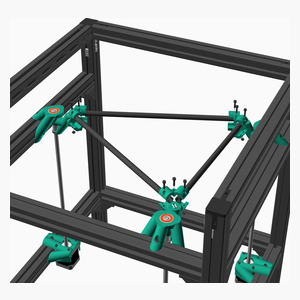
build/assemblies/frame3_assembly_tn.png
