SmoothieAq/cevo2/build/assemblies/frame10_assembly_diff.png

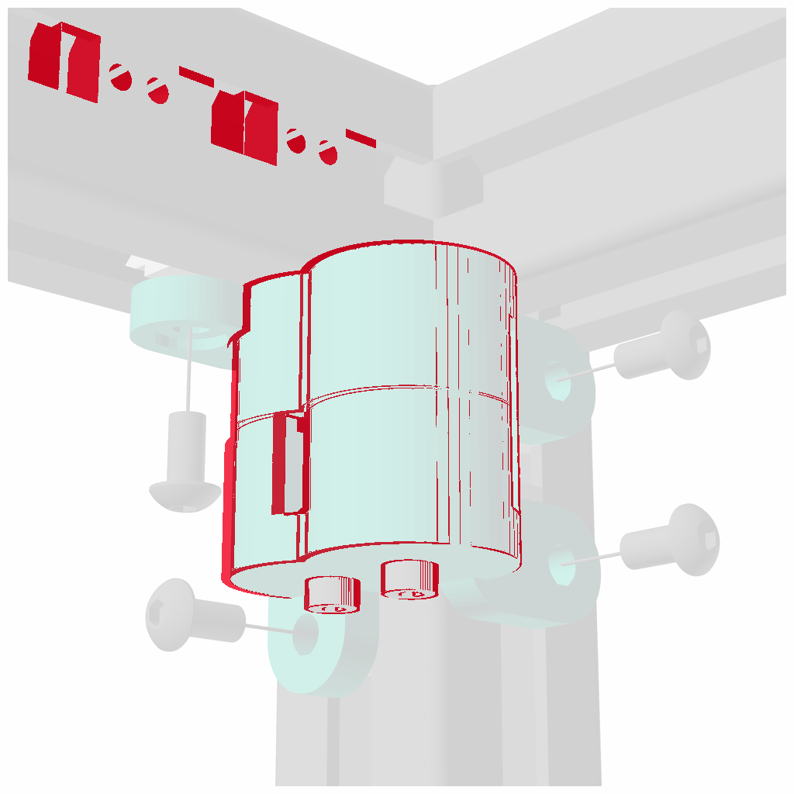
build/assemblies/frame10_assembly_diff.png
