SmoothieAq/cevo2/build/assemblies/frame11_assembly_diff.png

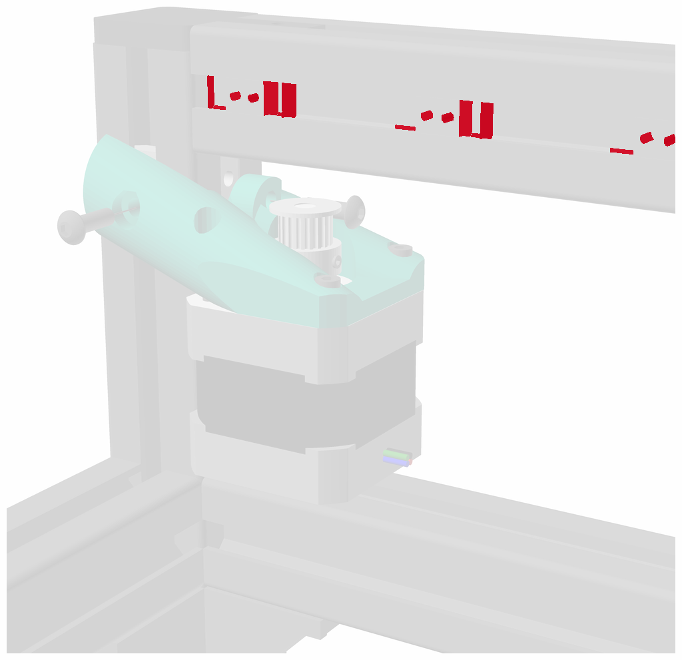
build/assemblies/frame11_assembly_diff.png
