SmoothieAq/cevo2/build/assemblies/frame11_assembly_tn.png

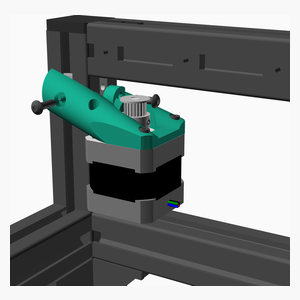
build/assemblies/frame11_assembly_tn.png
