SmoothieAq/cevo2/build/assemblies/frame20_assembly_diff.png

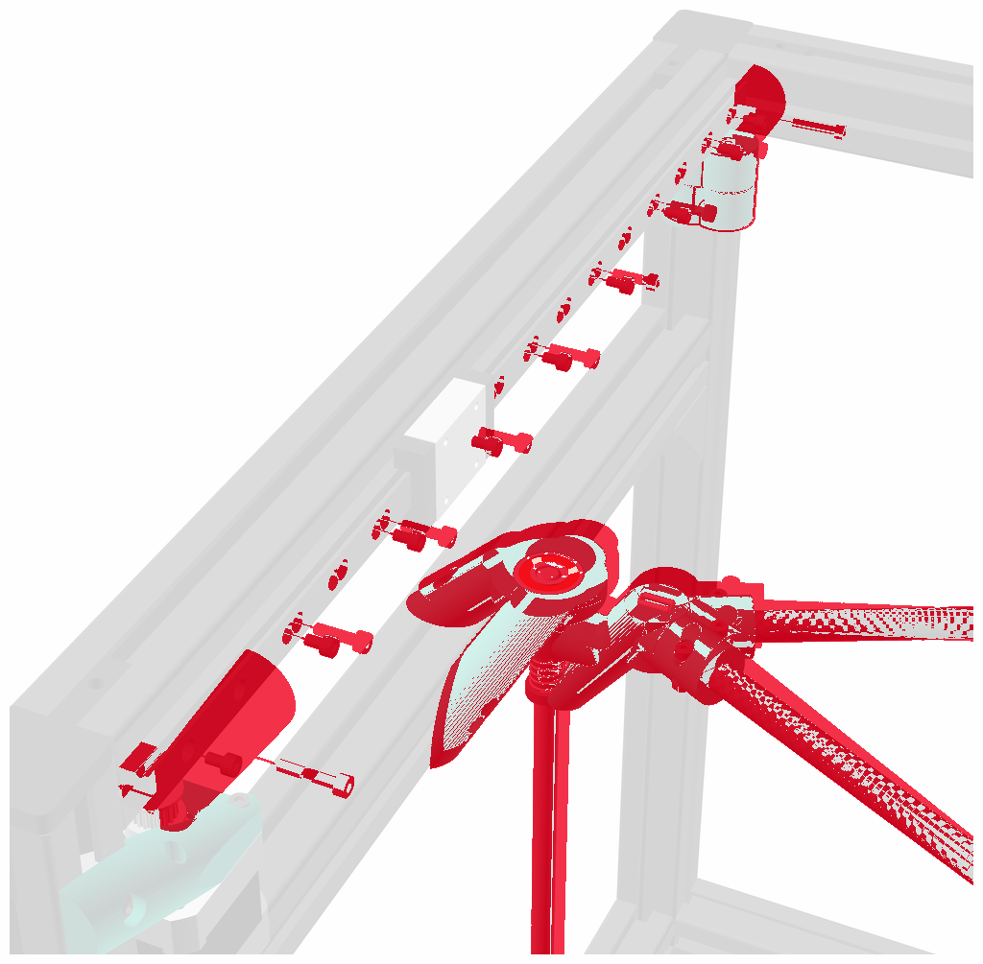
build/assemblies/frame20_assembly_diff.png
