SmoothieAq/cevo2/build/assemblies/frame20_assembly_tn.png

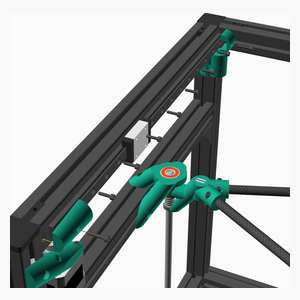
build/assemblies/frame20_assembly_tn.png
