SmoothieAq/cevo2/build/assemblies/frame21_assembly_diff.png

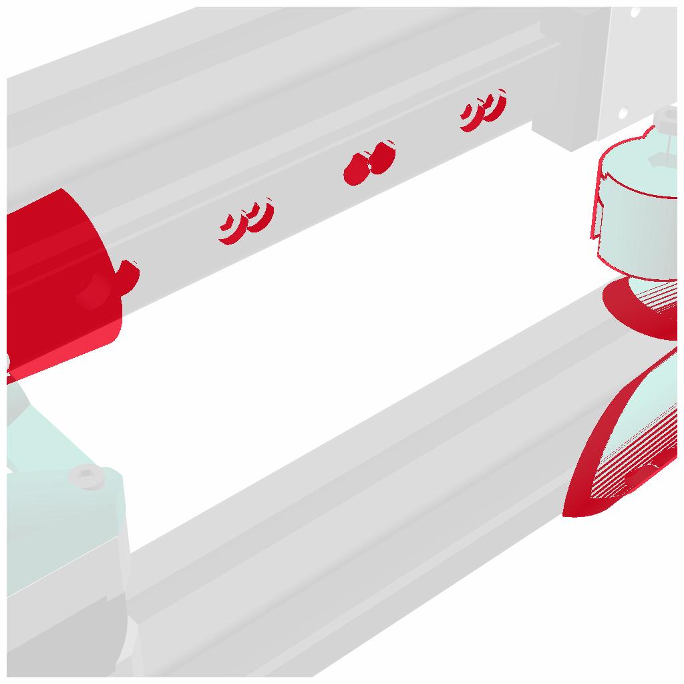
build/assemblies/frame21_assembly_diff.png
