SmoothieAq/cevo2/build/assemblies/frame21_assembly_tn.png

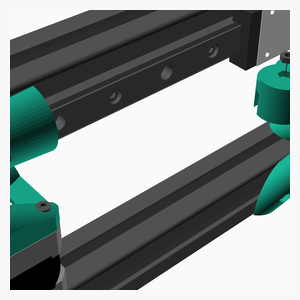
build/assemblies/frame21_assembly_tn.png
