SmoothieAq/cevo2/build/assemblies/frame22_assembly_tn.png

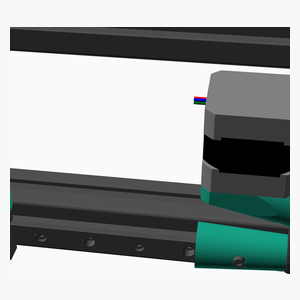
build/assemblies/frame22_assembly_tn.png
