SmoothieAq/cevo2/build/assemblies/frame22_assembly_tn_diff.png

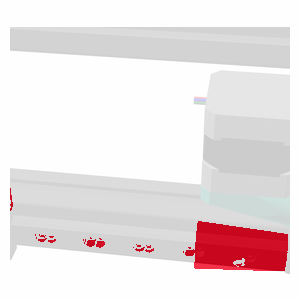
build/assemblies/frame22_assembly_tn_diff.png
