SmoothieAq/cevo2/build/assemblies/frame35_assembly_diff.png

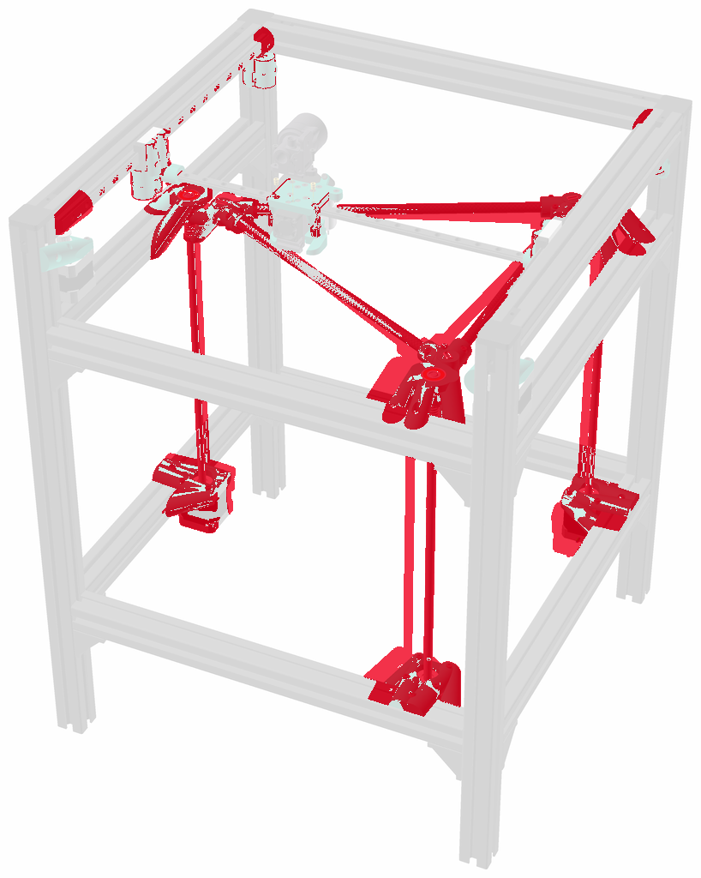
build/assemblies/frame35_assembly_diff.png
