SmoothieAq/cevo2/build/assemblies/frame40_assembled_diff.png

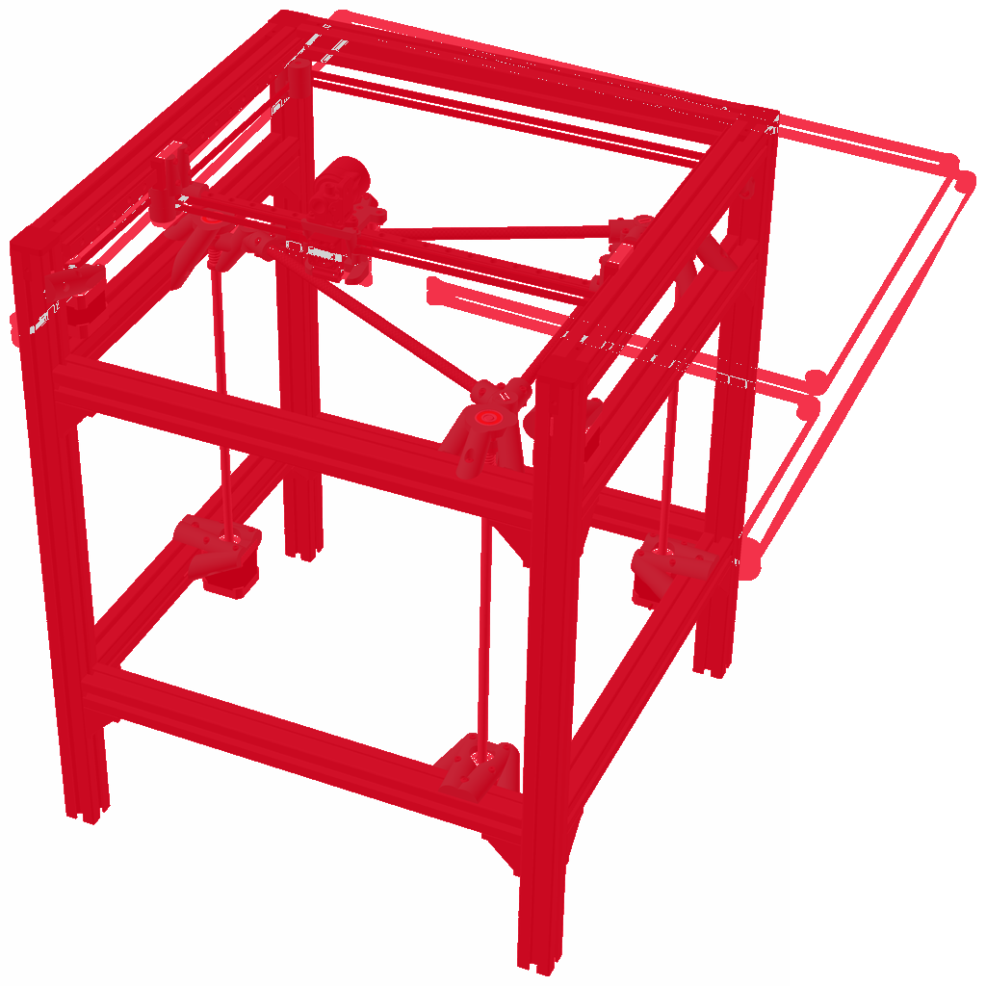
build/assemblies/frame40_assembled_diff.png
