SmoothieAq/cevo2/build/assemblies/frame40_assembled_tn.png

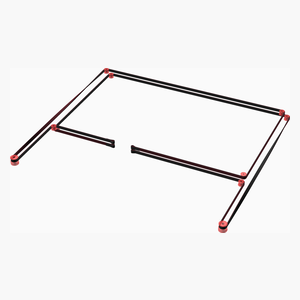
build/assemblies/frame40_assembled_tn.png
