SmoothieAq/cevo2/build/assemblies/frame40_assembled_tn_diff.png

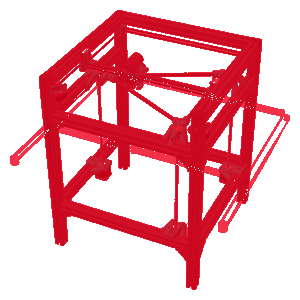
build/assemblies/frame40_assembled_tn_diff.png
