SmoothieAq/cevo2/build/assemblies/frame_assembled_tn_diff.png

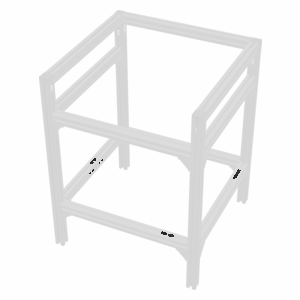
build/assemblies/frame_assembled_tn_diff.png
