SmoothieAq/cevo2/build/assemblies/frame_assembly.png

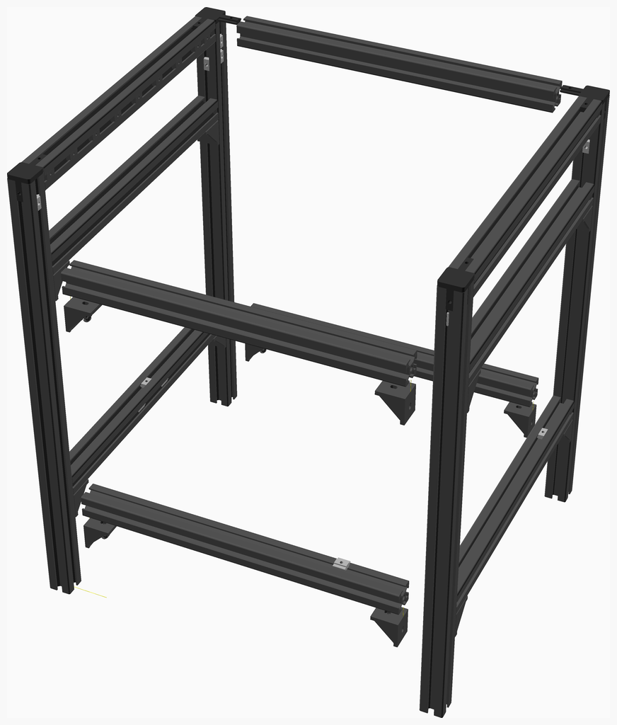
build/assemblies/frame_assembly.png
