SmoothieAq/cevo2/build/assemblies/frame_assembly_tn_diff.png

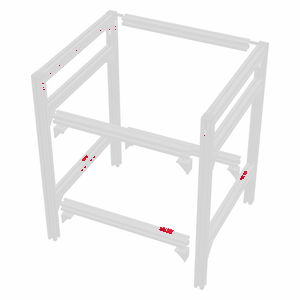
build/assemblies/frame_assembly_tn_diff.png
