SmoothieAq/cevo2/build/assemblies/frame_sideL_assembled.png

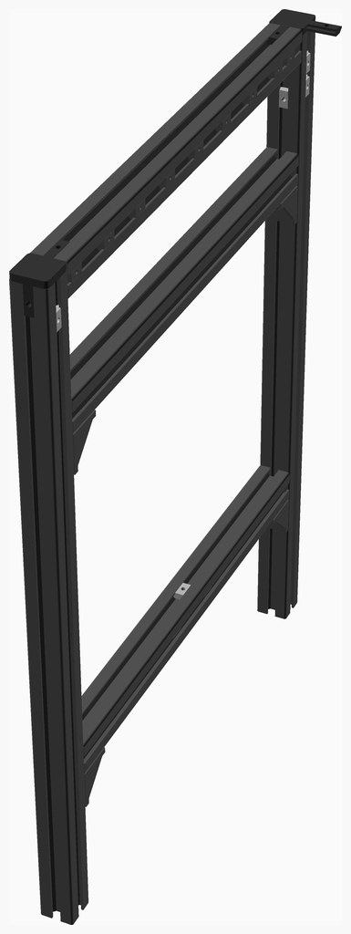
build/assemblies/frame_sideL_assembled.png
