SmoothieAq/cevo2/build/assemblies/frame_sideL_assembly.png

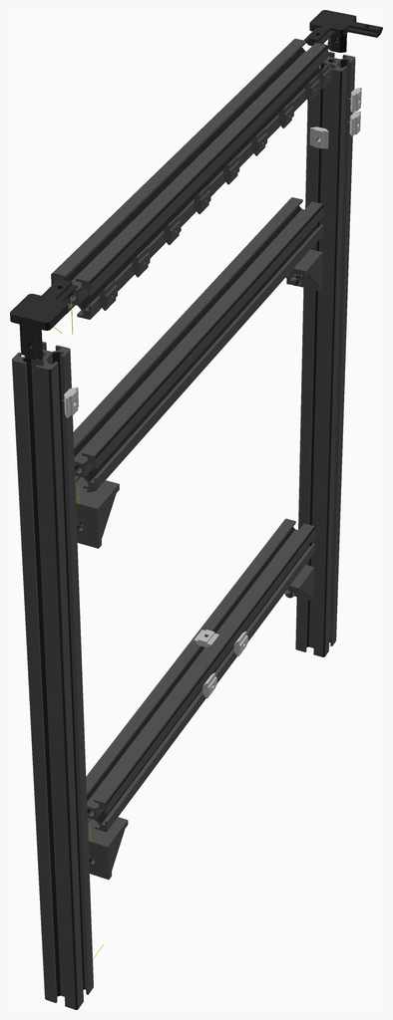
build/assemblies/frame_sideL_assembly.png
