SmoothieAq/cevo2/build/assemblies/frame_sideR_assembled.png

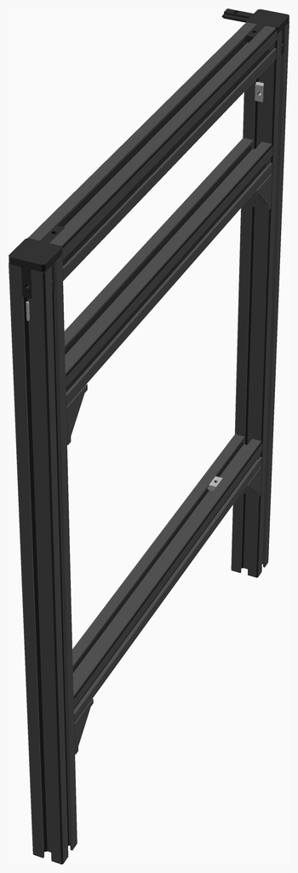
build/assemblies/frame_sideR_assembled.png
