SmoothieAq/cevo2/build/assemblies/frame_sideR_assembly.png

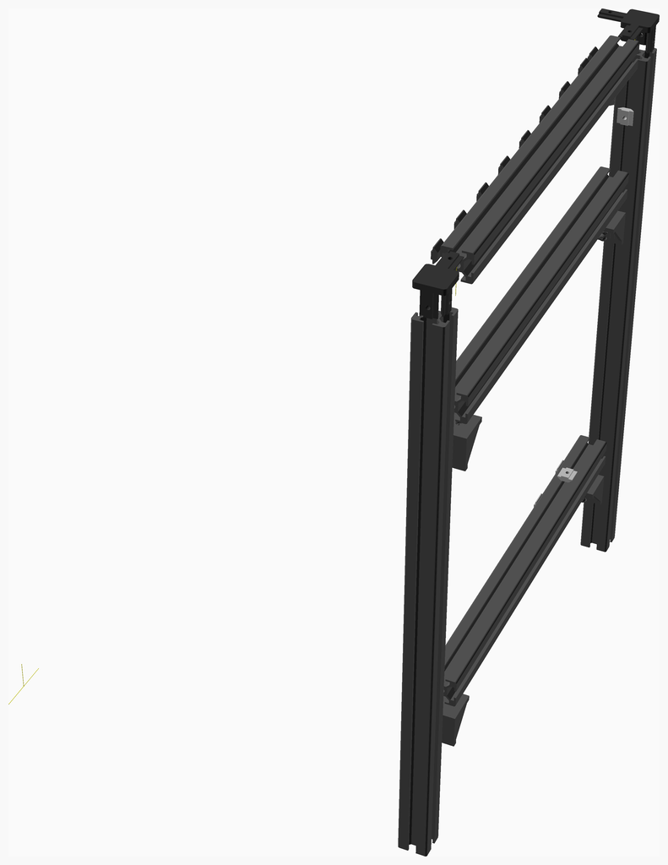
build/assemblies/frame_sideR_assembly.png
