SmoothieAq/cevo2/build/assemblies/idler_assembled.png

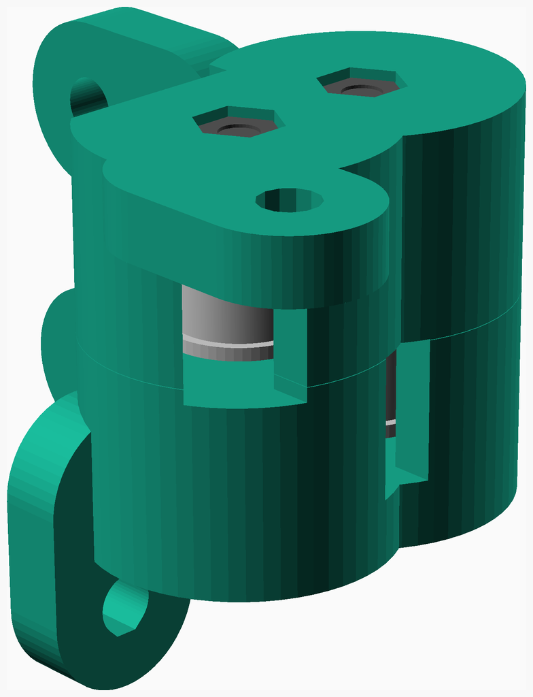
build/assemblies/idler_assembled.png
