SmoothieAq/cevo2/build/assemblies/idler_assembled_tn_diff.png

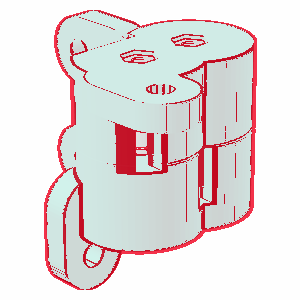
build/assemblies/idler_assembled_tn_diff.png
