SmoothieAq/cevo2/build/assemblies/idler_assembly.png

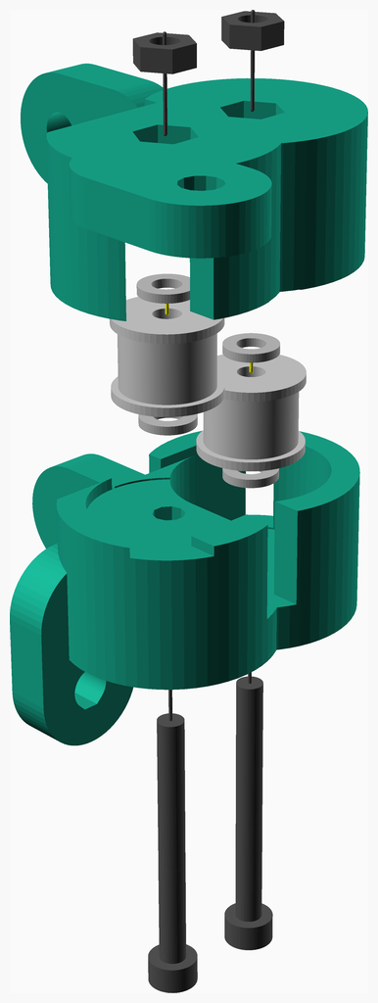
build/assemblies/idler_assembly.png
