SmoothieAq/cevo2/build/assemblies/idler_assembly_tn_diff.png

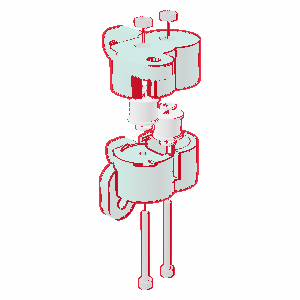
build/assemblies/idler_assembly_tn_diff.png
