SmoothieAq/cevo2/build/assemblies/leads1_assembled_tn_diff.png

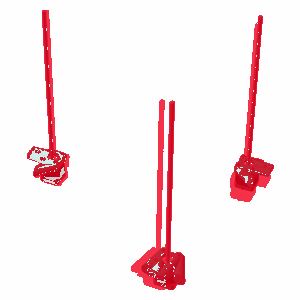
build/assemblies/leads1_assembled_tn_diff.png
