SmoothieAq/cevo2/build/assemblies/leads1_assembly_tn.png

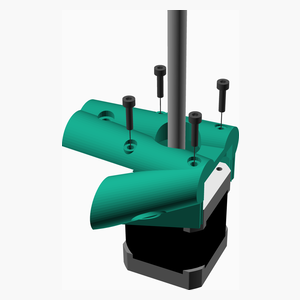
build/assemblies/leads1_assembly_tn.png
