SmoothieAq/cevo2/build/assemblies/leads1_assembly_tn_diff.png

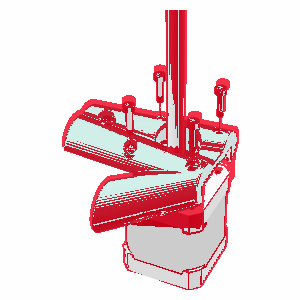
build/assemblies/leads1_assembly_tn_diff.png
