SmoothieAq/cevo2/build/assemblies/leads2_assembly_diff.png

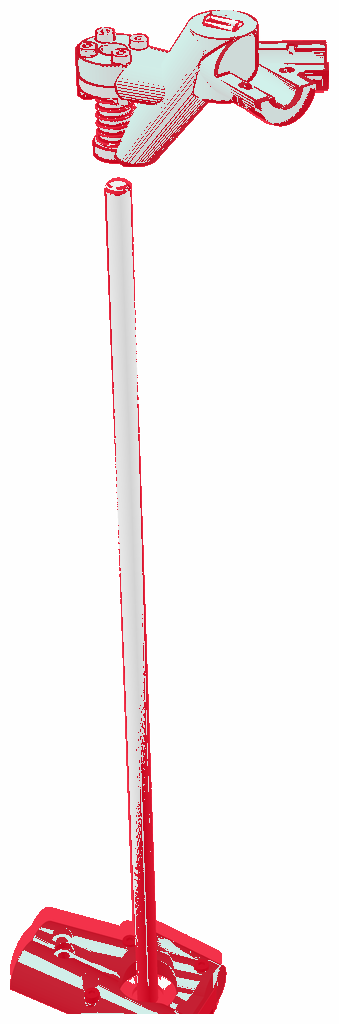
build/assemblies/leads2_assembly_diff.png
