SmoothieAq/cevo2/build/assemblies/leads2_assembly_tn.png

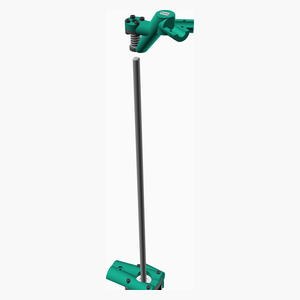
build/assemblies/leads2_assembly_tn.png
