SmoothieAq/cevo2/build/assemblies/loops_motor_holder_assembled.png

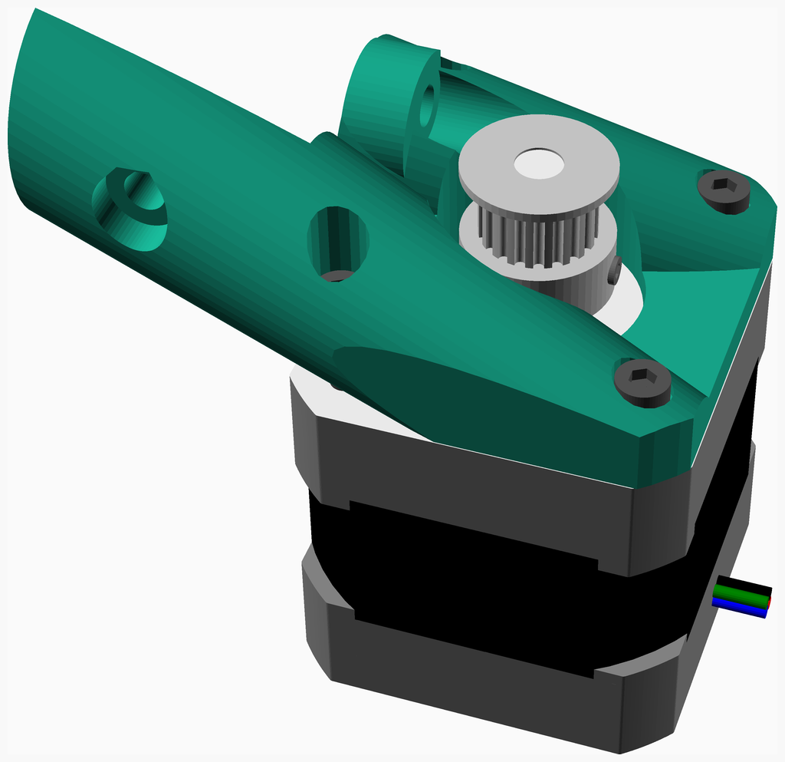
build/assemblies/loops_motor_holder_assembled.png
