SmoothieAq/cevo2/build/assemblies/loops_motor_holder_assembly.png

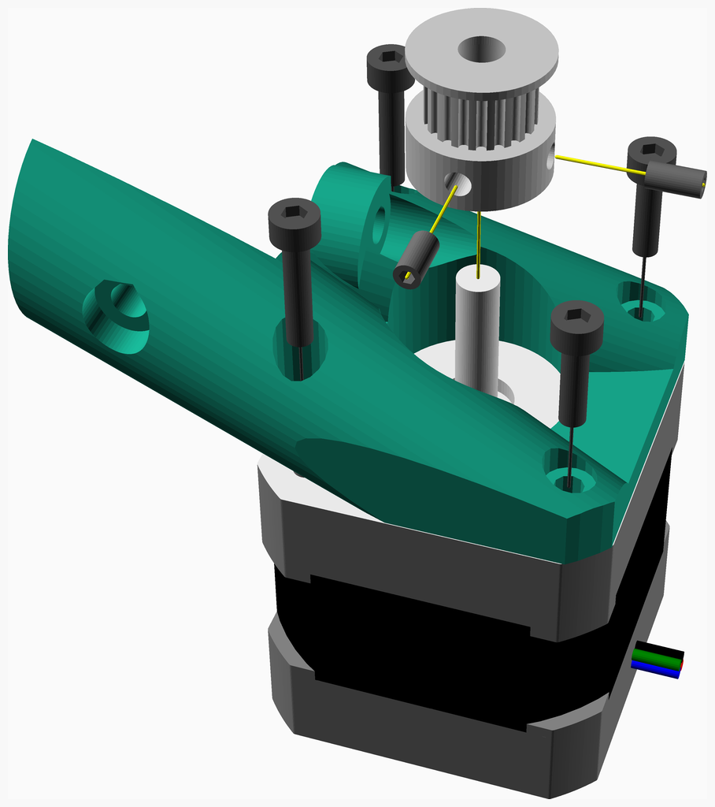
build/assemblies/loops_motor_holder_assembly.png
