SmoothieAq/cevo2/build/stls/bed_holderB1_diff.png

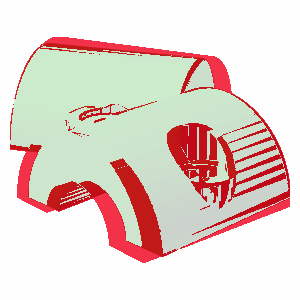
build/stls/bed_holderB1_diff.png
