SmoothieAq/cevo2/build/stls/bed_holderB2_diff.png

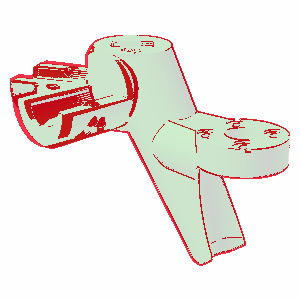
build/stls/bed_holderB2_diff.png
