SmoothieAq/cevo2/build/stls/bed_holderF1_diff.png

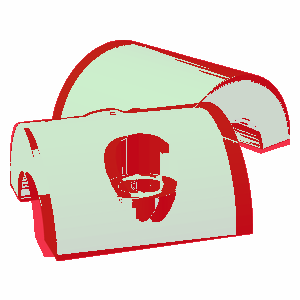
build/stls/bed_holderF1_diff.png
