SmoothieAq/cevo2/build/stls/bed_holderF2_diff.png

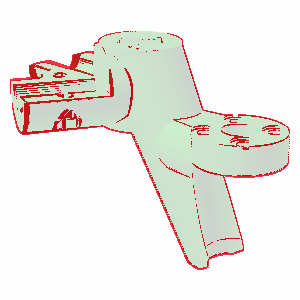
build/stls/bed_holderF2_diff.png
