SmoothieAq/cevo2/build/stls/bed_holderL1_diff.png

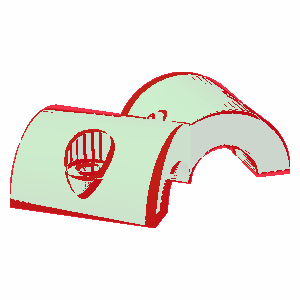
build/stls/bed_holderL1_diff.png
