SmoothieAq/cevo2/build/stls/bed_holderL2_diff.png

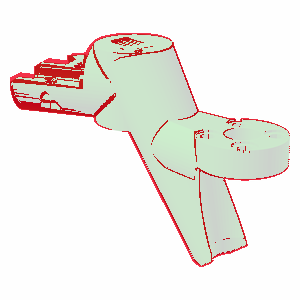
build/stls/bed_holderL2_diff.png
