SmoothieAq/cevo2/build/stls/carriage_diff.png

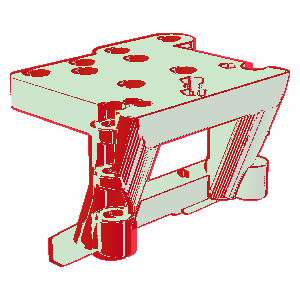
build/stls/carriage_diff.png
