SmoothieAq/cevo2/build/stls/idler_holderL1_diff.png

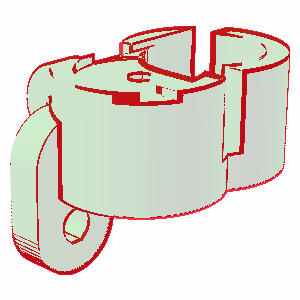
build/stls/idler_holderL1_diff.png
