SmoothieAq/cevo2/build/stls/idler_holderL2_diff.png

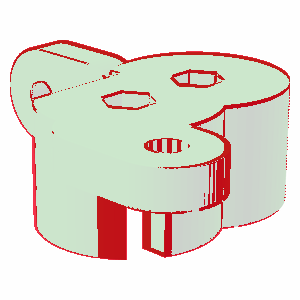
build/stls/idler_holderL2_diff.png
