SmoothieAq/cevo2/build/stls/idler_holderR1_diff.png

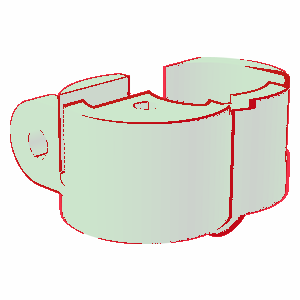
build/stls/idler_holderR1_diff.png
