SmoothieAq/cevo2/build/stls/idler_holderR2_diff.png

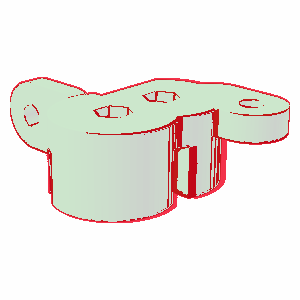
build/stls/idler_holderR2_diff.png
