SmoothieAq/cevo2/build/stls/x_holderL1_diff.png

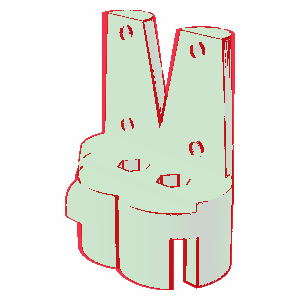
build/stls/x_holderL1_diff.png
