SmoothieAq/cevo2/build/stls/x_holderL2_diff.png

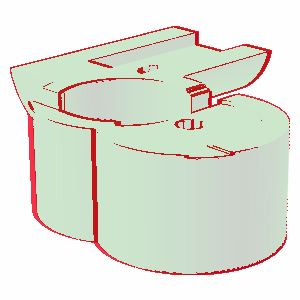
build/stls/x_holderL2_diff.png
