SmoothieAq/cevo2/build/stls/x_holderR1_diff.png

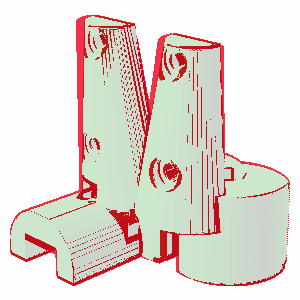
build/stls/x_holderR1_diff.png
