SmoothieAq/cevo2/build/stls/x_holderR2_diff.png

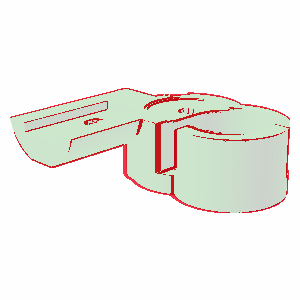
build/stls/x_holderR2_diff.png
