SmoothieAq/cevo2/(list of files, drawings)

Other design files:
electronics/power.fzz
